18460003808-coder/16_ADC_TEST/hardware/chip reference/ads7953_context.md

# ads7953.pdf

## 主要内容

- **IC型号**: ADS7950～ADS7961；本项目使用 ADS7953
- **类型**: 数据手册（SLAS605C，2018-07 修订）
- **文档覆盖内容**: 特性、引脚、电气参数、时序、工作模式、编程、应用、布局、封装
- **关键外设/特性**: 12/10/8-bit SAR ADC、4/8/12/16 通道、SPI、GPIO、告警、外部参考
- **总页数**: 87

## 目录

### 1 Features (p.1)

### 2 Applications (p.1)

### 3 Description (p.1)

### 4 Revision History (p.2)

### 5 Device Comparison Table (p.5)

### 6 Pin Configuration and Functions (p.5)

### 7 Specifications (p.10)

#### 7.1 Absolute Maximum Ratings (p.10)

#### 7.2 ESD Ratings (p.10)

#### 7.3 Recommended Operating Conditions (p.10)

#### 7.4 Thermal Information: TSSOP (p.11)

#### 7.5 Thermal Information: VQFN (p.11)

#### 7.6 Electrical Characteristics: ADS7950/51/52/53 (p.12)

#### 7.7 Electrical Characteristics: ADS7954/55/56/57 (p.14)

#### 7.8 Electrical Characteristics: ADS7958/59/60/61 (p.15)

#### 7.9 Timing Requirements (p.17)

#### 7.10 Typical Characteristics: All Devices (p.20)

#### 7.11 Typical Characteristics: 12-Bit Devices (p.21)

#### 7.12 Typical Characteristics: 12-Bit Devices (p.27)

### 8 Detailed Description (p.28)

#### 8.1 Overview (p.28)

#### 8.2 Functional Block Diagram (p.29)

#### 8.3 Feature Description (p.29)

#### 8.4 Device Functional Modes (p.29)

#### 8.5 Programming (p.41)

### 9 Application and Implementation (p.46)

#### 9.1 Application Information (p.46)

#### 9.2 Typical Applications (p.48)

### 10 Power Supply Recommendations (p.51)

### 11 Layout (p.52)

#### 11.1 Layout Guidelines (p.52)

#### 11.2 Layout Examples (p.52)

### 12 Device and Documentation Support (p.54)

#### 12.1 Documentation Support (p.54)

#### 12.2 Related Links (p.54)

#### 12.3 Receiving Notification of Documentation Updates (p.54)

#### 12.4 Community Resources (p.54)

#### 12.5 Trademarks (p.54)

#### 12.6 Electrostatic Discharge Caution (p.55)

#### 12.7 Glossary (p.55)

### 13 Mechanical, Packaging, and Orderable Information (p.55)
