18460003808-coder/16_ADC_TEST/ADS7953_0-5V/datasheet_index.md

# Datasheet Index

> 由 datasheet 阅读流程生成的导航文件。

## ./

### 电路原理图.pdf
- **IC/Subject**: ADS7953 16 路 ADC 板
- **Document Type**: 电路原理图
- **Coverage**: ADS7953 电源、参考源、16 路模拟输入、SPI 与连接器
- **Key Features/Peripherals**: CH0～CH15、MXO/AINP、CS#/SCLK/SDI/SDO、GPIO0～3
- **Total Pages**: 1
- **Context File**: 电路原理图_context.md

## chip reference/

### ads7953.pdf
- **IC/Subject**: TI ADS7950～ADS7961，重点 ADS7953
- **Document Type**: 数据手册
- **Coverage**: 引脚、电气指标、SPI 时序、Manual/Auto-1/Auto-2、编程与应用
- **Key Features/Peripherals**: 12-bit、16-channel、1-MSPS、20-MHz SPI、外部参考
- **Total Pages**: 87
- **Context File**: chip reference/ads7953_context.md

## FPGA 选择/

### EP4CE30VER6.1D硬件用户手册.pdf
- **IC/Subject**: Altera Cyclone IV E EP4CE30/EP4CE40 核心板
- **Document Type**: FPGA 核心板硬件用户手册
- **Coverage**: 核心板资源、原理图、板卡布局、外设接口、电源、时钟、扩展接口
- **Key Features/Peripherals**: DDR2、USB 转 RS232、千兆以太网、USB2.0、SD 卡、LCD、QSPI Flash、EEPROM、DS1302
- **Total Pages**: 40
- **Context File**: FPGA 选择/EP4CE30VER6.1D硬件用户手册_context.md
