18460003808-coder/16_ADC_TEST/ADS7953_0-5V/电路原理图_context.md

# 电路原理图.pdf

## 主要内容

- **IC型号**: ADS7953SBDBTR
- **类型**: 单页电路原理图
- **文档覆盖内容**: 电源、参考电压、模拟通道、SPI、GPIO、连接器
- **关键外设/特性**: CH0～CH15、MXO/AINP、CS#/SCLK/SDI/SDO
- **总页数**: 1

## 目录

### Pages
#### SCH_Schematic1 1-P1 (p.1)
### Net
#### AGND, MXO, AINP, SDO, SDI, SCLK, CS#, VCC, +2.5V, +3.3V, +5V (p.1)
#### CH0～CH15, GPIO0～GPIO3 (p.1)
