18460003808-coder/16_ADC_TEST/NEW/ADS7953_NBoard_UART_SLIDE/最开始工程说明.txt

ADS7953_NBoard_UART_SLIDE最终工程说明
=====================================

本工程继承NEW/ADS7953_NBoard_UART的1～20板UART采集功能，并加入滑轨脉冲控制、ADC联动采集、纵向Excel导出和320×N灰度成像。Quartus入口为ADS7953_NBoard_UART_SLIDE.qpf。

一、FPGA

1. 板数由rtl/ads7953_board_count.vh中的ADS7953_BOARD_COUNT宏决定，合法范围1～20，当前为20；修改后必须完整编译并重新下载SOF。
2. ADC SCLK为1 MHz。每块板最多尝试32个SPI字，失败后停止该板SCLK并通过CH0高字节bit7报告读取错误，缺板不会使系统永久忙。
3. slide模块输出2 kHz、50%占空比的脉冲。80个脉冲对应1 mm；一次硬件命令的pulse_num范围为0～65535。
4. dir=1为正向，dir=0为反向。顶层pwm_out连接PIN_A20，dir连接PIN_A19。
5. FPGA只有在ADC与滑轨控制空闲且命令校验正确时才接受滑轨命令；实际脉冲输出结束后才返回完成帧。

二、正式上位机

保留两个程序：

- host/dist/ADS7953_NBoard_AllChannels_UART_SLIDE.exe：全通道显示、采集、滑轨与灰度成像最终版。
- host/dist/ADS7953_NBoard_Scope_UART.exe：保留的多通道示波器式显示版，不含滑轨操作界面；通道采用可滚动复选框选择，并提供“全选”和“清空”。

两个程序共用两份配置：host/dist/board_mapping.csv负责采集卡物理插口1～20与实际逻辑子板1～20，host/dist/channel_mapping.csv负责每块板共用的IV0～IV15与ADC CH0～CH15。断开串口后可点击上位机“映射配置”直接修改，保存后立即生效；显示、标红、波形、Excel和灰度图均使用映射后的逻辑IV0～IV319。配置错误时禁止连接，但可在配置窗口修复，具体格式见docs/板卡映射配置说明.md。

全通道滑轨版功能：

1. 滑轨单独调试可选择方向，距离范围0.5～300 mm。运动期间状态灯为红色，收到匹配的FPGA完成帧后变为绿色。
2. ADC联动每步距离为0.5～2 mm，采集间隔为500～5000 ms，可设置次数N。流程为“采集一次、正向移动一步”，重复N次后反向移动N步总距离复位。
3. 联动数据先保存在内存。复位完成后弹出“另存为”，每次生成新的Excel并由用户命名，不追加旧文件；取消保存后仍可再次保存。
4. Excel的A列为IV0～IV319，后续每列对应不同采集时间；错误板的16路数据标红。
5. 可选择已有或刚生成的纵向Excel生成320×N灰度预览。默认0 V为黑、5 V为白，范围可修改；预览后由用户决定是否导出PNG。

三、文档入口

- README.md：工程范围、构建和验证状态。
- docs/通信协议.md：ADC与滑轨UART帧格式。
- docs/滑轨联动使用说明.md：接线、操作、Excel和灰度图说明。
- docs/板卡映射配置说明.md：板卡序号、板内IV→ADC通道及界面修改方法。
- docs/macOS版本使用与打包说明.md：Apple Silicon M5版构建和使用步骤。
- macOS_M5_Package/：可整体复制到M5 Mac的两款上位机独立构建包。
- docs/FPGA模块调用及信号控制框图.txt：FPGA模块层级及控制时序。
