18460003808-coder/16_ADC_TEST/NEW/验证报告.md

# 验证报告

日期：2026-09-27

## 2026-11-03：SLIDE Scope通道复选框

- 验证Scope可按实际板数动态生成最多320个IV复选框，初始默认勾选IV0；单击复选框后，曲线和Excel均继续使用同一组已选通道。
- 验证“全选”可勾选320路，“清空”可取消全部通道，列表内容高度超过显示区时滚动区域有效；维护目录源码和Mac独立发送包源码均通过相同GUI交互检查。
- Python语法检查和21项单元测试全部通过；重新打包后的Windows Scope正式EXE通过3秒启动检查。
- Scope EXE为13,670,414字节，SHA-256 `CBC26750283D8A7ACE8A427F1D2BE964197E212B30949D5B711FA54D45A6FA29`；AllChannels EXE未重新打包。
- 当前Windows环境不能生成或运行macOS `.app`；本次没有修改或编译FPGA，没有运行Quartus、ModelSim或实物硬件测试。

## 2026-11-03：SLIDE两级映射界面与Mac交付包

- 验证`board_mapping.csv`和`channel_mapping.csv`均可保存、重新加载，并拒绝重复/缺失的一对一配置；Mac首次启动路径测试同时覆盖两份配置。
- 验证自定义IV→ADC通道顺序会改变AllChannels显示行、纵向Excel和Scope Excel读取的ADC原码；板卡序号映射、错误标红、滑轨联动及灰度成像原有测试继续通过。
- Python语法检查和21项单元测试全部通过；AllChannels和Scope均完成“打开映射配置窗口”GUI源码检查，Mac独立交付目录中的同源代码也完成相同检查。
- 两个Windows正式EXE重新打包并分别通过3秒启动检查；`dist`同时包含`board_mapping.csv`和`channel_mapping.csv`。
- AllChannels EXE为16,416,465字节，SHA-256 `C967FEDB41B25E2A95B3141B3D4F08479B4DA4207A5FC9CB119B16FF6A7D3377`；Scope EXE为13,669,247字节，SHA-256 `534C22D87B8FD3D14845A4A851FC6F3F20A03198A608E40B34454E29B1611174`。
- `board_mapping.csv` SHA-256为`6C6C611057B780E32CFAD22EC162E6E1EB5734946324FB0CC774BD0995FF483C`；`channel_mapping.csv` SHA-256为`D14F55DDFE0F007E84DB5B3CACD431BA2D70705102264BDB6A963FAA90AC718E`。
- 当前Windows环境不能实际生成或运行macOS `.app`；M5上的Gatekeeper、USB转串口、实际采集、Excel/PNG和滑轨仍待Mac实机验证。
- 本次没有修改或编译FPGA，没有运行Quartus、ModelSim或实物硬件测试。

## 2026-10-22：SLIDE Apple Silicon M5上位机准备与Windows回归

- macOS路径、首次生成20板恒等映射、映射重新加载以及`Documents`存在/不存在时的默认导出目录均已通过自动测试。
- 两份arm64 PyInstaller规格文件通过Python语法解析；`ads7953_Nboard_gui.py`、AllChannels、Scope和测试文件通过Python语法检查，18项单元测试全部通过。
- `macOS_M5_Package`内9个构建文件与维护目录源文件逐项SHA-256一致，Python源码和两份规格文件可独立解析，Shell脚本保持LF换行，两款GUI均从发送目录独立完成源码启动检查。
- AllChannels和Scope源码GUI启动检查通过；两个Windows正式EXE重新打包后均通过3秒启动检查，`dist/board_mapping.csv`与源码模板一致。
- AllChannels EXE为16,409,776字节，SHA-256 `FD4382C1E6D994BF185EFF2EE1BE847673B844C122FC8C1B40743260C219008D`；Scope EXE为13,663,201字节，SHA-256 `A1ECC42B768D7D64CB14C7FA5C7675CBA0F4B3E1E15C27556326D9D372F8869E`；映射文件SHA-256为`6C6C611057B780E32CFAD22EC162E6E1EB5734946324FB0CC774BD0995FF483C`。
- 当前环境是Windows，未实际生成、签名或启动macOS `.app`，也未验证M5上的Gatekeeper、USB转串口驱动、Excel/PNG、滑轨或实物采集。
- 本次没有修改或编译FPGA，没有运行Quartus、ModelSim或实物硬件测试。

## 2026-10-21：SLIDE板卡映射上位机

- 验证CSV交换`capture_slot 1/2`后，物理Board 1的数据映射为逻辑Board 0，即最终IV0～IV15；SPI错误状态随同16路数据一起映射。
- 验证重复逻辑子板配置被拒绝；实现同时检查缺失文件、表头、整数范围、重复插口和20行完整性。
- AllChannels映射后Excel测试确认IV0取自配置所指物理板，并在该物理板错误时标红；Scope与AllChannels共享同一公共重排入口。
- Python语法检查通过，17项单元测试全部通过，AllChannels和Scope源码GUI启动检查通过。
- 两个正式EXE均已重新打包并通过3秒启动检查，`board_mapping.csv`已复制到同目录。AllChannels为16,409,425字节，SHA-256 `7A0353FC907E54B425EAF7B4C13B553CB666A3290913F6ADD71B469C6FCBFB7B`；Scope为13,663,204字节，SHA-256 `B81C8989B3AF2446A70590E854934D9670CC720468535B221B08E14556F19C3A`。
- 本次没有修改或编译FPGA，没有运行Quartus、ModelSim或实物板卡映射验证。

## 2026-10-08：SLIDE最终整理复核

- 当前正式AllChannels EXE为`host/dist/ADS7953_NBoard_AllChannels_UART_SLIDE.exe`，16,406,775字节，SHA-256 `4F0E1388555E043FA88E32B317E1E6C9C830710B1E456937891239E202550FFD`。
- 当前保留的13项Python单元测试全部通过；本次没有重新运行GUI启动检查、Quartus或ModelSim，也没有进行实物验证。
- 文档全文检索未发现残留UDP/NET、`_FIXED`、`_PREVIEW`、Diagnostic或FreeRun现行说明。
- 项目内现行说明统一为README、`最开始工程说明.txt`、`docs/通信协议.md`、`docs/滑轨联动使用说明.md`和`docs/FPGA模块调用及信号控制框图.txt`。
- 用户Excel和PNG数据未删除；FPGA RTL、约束、SOF和上位机源码未修改。

## 2026-10-08：灰度图预览与选择性PNG导出

- 灰度计算完成后先创建预览窗口，程序不自动写PNG；保存对话框仅由预览窗口“导出PNG”按钮触发。
- 关闭预览或取消导出不会创建PNG，取消导出后预览保持可用。
- 当前`host/dist/1.xlsx`已达到320×320数据，后台解析用时约0.45秒。
- 18项Python测试和GUI源码启动检查通过，预览版EXE打包成功。
- 预览版EXE：`host/dist/ADS7953_NBoard_AllChannels_UART_SLIDE_PREVIEW.exe`，16,406,775字节，SHA-256 `4F0E1388555E043FA88E32B317E1E6C9C830710B1E456937891239E202550FFD`。
- 本次未修改FPGA或SOF。

## 2026-10-08：灰度成像未响应修复

- 复现文件`host/dist/1.xlsx`为321行、101列，即320×100有效数据；普通加载约0.18秒，旧随机访问函数超过30秒未完成。
- 修复后同一文件完整解析为100×320、共32000灰度像素，用时0.139秒。
- Excel改为`iter_rows(values_only=True)`顺序读取，耗时操作放到后台线程；Tk主线程通过队列接收结果并弹出保存和预览。
- 18项Python测试通过，GUI源码启动检查通过，修复版EXE打包成功。
- 修复版EXE：`host/dist/ADS7953_NBoard_AllChannels_UART_SLIDE_FIXED.exe`，16,403,885字节，SHA-256 `F9E2174B4EEA4BF261A02B63627463C80C7CC7DE81652DBDAB55FEDD7C07E904`。
- 原正式EXE当时仍被用户打开，未强制结束或覆盖；本次未修改FPGA或SOF。

## 2026-10-08：SLIDE上位机320×N灰度成像

- 验证纵向Excel解析尺寸为N列×320行，图像行顺序为IV0～IV319、列顺序为采集1～N。
- 默认0～5 V映射验证：0 V为0、2.5 V为128、5 V及以上为255，空白单元格为0；无效电压范围被拒绝。
- SLIDE上位机18项Python测试通过，GUI源码启动检查通过，包含Pillow的正式EXE重新生成成功。
- 新EXE：`host/dist/ADS7953_NBoard_AllChannels_UART_SLIDE.exe`，16,403,677字节，SHA-256 `D96C6FCFF7942F8076CBB9737E91C15EB9AA2C25F2AE30D38A2F103890221A7B`。
- 本次未修改FPGA源码、通信协议或SOF，没有运行Quartus、ModelSim或实物联动验证。

## 2026-10-08：SLIDE联动独立Excel导出

- 验证联动导出直接创建全新工作簿；测试目标原先包含“旧数据”工作表，导出后仅保留新的“纵向通道数据”，证明没有追加旧内容。
- 验证A列IV0～IV319、两轮采集生成两列、列头包含真实采集时间/Seq/位置、错误板对应单元格标红。
- SLIDE上位机16项Python测试通过，GUI源码启动检查通过，正式EXE重新生成成功。
- 新EXE：`host/dist/ADS7953_NBoard_AllChannels_UART_SLIDE.exe`，13,666,218字节，SHA-256 `AC6A4D8143B49928FA941DD6421D31A783D5102575B96EB398AC3E9E2197611C`。
- 本次未修改FPGA源码、通信协议或SOF，没有运行Quartus、ModelSim或实物联动验证。

## 2026-10-08：SLIDE单独调试距离扩展到300 mm

- 验证单独调试接受300 mm并换算为24000个PWM，拒绝300.1 mm。
- 验证联动距离仍限制为0.5～2 mm。
- SLIDE上位机15项Python测试通过，GUI源码启动检查通过，正式EXE重新生成成功。
- 新EXE：`host/dist/ADS7953_NBoard_AllChannels_UART_SLIDE.exe`，13,665,192字节，SHA-256 `9F4CD943C43F26BDA7A2EAD152D8169D93E06010E47F3A137C68A07349A920D1`。
- 本次未修改FPGA源码或SOF，没有运行Quartus、ModelSim或实物滑轨验证。

## 2026-10-08：SLIDE单独调试距离扩展

- 验证单独调试接受0.5 mm和30 mm，拒绝30.1 mm；30 mm正确换算为2400个PWM。
- 验证联动距离仍接受0.5～2 mm并拒绝2.1 mm，未扩大联动运动范围。
- SLIDE上位机全套15项Python测试通过，GUI源码及正式EXE启动检查通过。
- 新EXE：`host/dist/ADS7953_NBoard_AllChannels_UART_SLIDE.exe`，13,665,937字节，SHA-256 `14F77F1FE1CDCE8DEFA075E6A539DBA9B172D15C1DC675CD1290A996E5412162`。
- 本次未修改FPGA源码或SOF，没有运行Quartus或ModelSim，也没有进行实物滑轨验证。

## 2026-10-08：N板UART滑轨联动工程

- `NEW/ADS7953_NBoard_UART_SLIDE`以当前`ADS7953_BOARD_COUNT=20`完成Quartus 13.1全流程编译，Analysis & Synthesis、Fitter、Assembler、TimeQuest均为0 error。
- Fitter保留1条既有3.3-V接口通用警告；TimeQuest同时提示板外I/O未完全约束，不能把编译通过等同于实物滑轨或ADC时序验证。
- 慢角85°C最差setup slack为1.296 ns，最差hold slack为0.450 ns。
- SOF：`output_files/ADS7953_NBoard_UART_SLIDE.sof`，1,171,650字节，SHA-256 `4D759FFE8A1F56EF95D487E175494FA1A96125492F5E12275DC27542D29D4071`。
- Python单元测试15项通过，覆盖原ADC帧、滑轨命令编码、分片完成帧、错误校验拒绝、距离到脉冲换算和既有显示/Excel功能。
- GUI源码启动检查及正式EXE 3秒启动检查通过。EXE：`host/dist/ADS7953_NBoard_AllChannels_UART_SLIDE.exe`，13,665,643字节，SHA-256 `D421816A5333EBF6F6E9E8DE517A16E494EC624DD6DE80B11FF1F4489B0058E7`。
- 已准备`sim/run_slide.do`及更新后的N板仿真脚本，但本次没有运行ModelSim；再次仿真仍需单独取得用户许可。
- 未进行物理滑轨、PWM引脚波形、机械方向、实际位移精度或整套联动实机验证。

## 2026-10-06：AllChannels纵向通道导出

- 验证导出工作表为321行：第1行为表头，第2～321行为IV0～IV319。
- 验证每次采集新增一个数据列，列标题包含时间和Seq；2板配置时IV32～IV319保持空白。
- 验证错误板对应16个数据单元格使用红色字体和浅红背景。
- N板UART上位机全套11项Python测试通过，包含旧工作表保留及自动切换验证；AllChannels源码界面和正式EXE启动检查通过。
- 正式EXE SHA-256：`972BF60956CB223DBC20ABFB6C2C3691CE5AB6E4FA9A8C0C975ECBEE100688E8`。
- 本次未修改FPGA，也未运行ModelSim。

## 2026-10-06：N板UART读取诊断版

- `NEW/ADS7953_NBoard_UART`在当前`ADS7953_BOARD_COUNT=20`配置下完成Quartus 13.1全流程编译：Analysis & Synthesis、Fitter、Assembler、TimeQuest均为0 error；Fitter保留1条既有3.3-V接口通用警告。
- 慢角85°C最差setup slack为1.523 ns，最差hold slack为0.450 ns；板外SPI仍未建立完整输入/输出延时约束，因此该结果不等同于物理SPI波形验证。
- 新SOF：`output_files/ADS7953_NBoard_UART.sof`，SHA-256 `9F44CF897909C2159A0B7C0D8F861660FE5AE08B859D32868B93E19212105ABD`。
- N板UART上位机共9项Python测试通过，覆盖正常/错误标志解析、12位ADC值不受bit7影响、旧解析器兼容、Excel错误状态与红色格式，以及原有连续触发和视图测试。
- `ADS7953_NBoard_Diagnostic_UART.exe`已生成并通过3秒启动冒烟测试；SHA-256 `FF2F611B3C32D0408B7E2FE6510106480A085E8661100FE5E61AB3028BB75CB7`。
- 本次没有运行ModelSim。诊断标志的RTL动态行为尚未做新一轮仿真，运行前仍须取得用户单独许可。

## 2026-10-06：N板UART五款上位机同步更新

- 主界面、AllChannels、Scope、FreeRun和Diagnostic均解析Byte8 bit7；原12位ADC值继续使用高字节`& 0x0F`，协议长度不变。
- 当前全套11项Python测试通过，覆盖错误标志、旧40字节解析兼容、主数据值、AllChannels纵向导出与旧表保留、Scope/Diagnostic导出状态及红色格式、连续触发和通道映射。
- 五个源码界面均完成Tk启动检查；五个正式`host/dist/*.exe`均完成2秒启动冒烟测试。
- 正式EXE SHA-256：主界面`19496285C80BBA9FF1F1D7B8C6501D3428C1CC175C92E0506FF03E93773857D3`；AllChannels`080855D481F224D4D4D6498848C76B3CDD067BB7472AFC910FDEE3681D0B42CC`；Scope`17EF65158929396B91AED09598A347F99C3BC4B7C78CB134B0D65743044C8574`；FreeRun`030866EB5DFF978E5E14E108256CE96544E1A8F08AE62002B1C98FBE5A55C18F`；Diagnostic`16F5E3405C14831EEEA7D6E2499DBF4AB8587819BE9BC94D4074F61A24B21DBF`。
- 本次仅更新上位机源码和EXE，没有再次修改或编译FPGA，也没有运行ModelSim。

## Quartus 13.1

四个工程均以Cyclone IV E `EP4CE30F23C8`完成Analysis & Synthesis、Fitter、Assembler和TimeQuest，结果均为0 error。

| 工程 | 验证板数 | 结果 | 慢角最差setup slack |
|---|---:|---|---:|
| ADS7953_1Board_UART | 1 | 通过 | 6.251 ns |
| ADS7953_1Board_NET | 1 | 通过 | 0.599 ns |
| ADS7953_NBoard_UART | 1 | 通过 | 6.483 ns |
| ADS7953_NBoard_UART | 20 | 通过 | 1.502 ns |
| ADS7953_NBoard_NET | 1 | 通过 | 0.560 ns |
| ADS7953_NBoard_NET | 20 | 通过 | 0.317 ns |

20板验证后，两个N板工程均已恢复`ADS7953_BOARD_COUNT=1`，并重新生成默认1板`.sof`。

NET工程仍有Quartus警告：PHY管理接口`MDC`固定低、`MDIO`保持高阻；GMII GTX时钟到输出脚使用非专用布线；板外I/O未建立完整输入/输出延时约束。当前工程依赖RTL8211上电固定配置，功能编译通过，但量产前建议根据PCB走线补齐板级时序约束并实测GMII裕量。

## 上位机

- 1板UART：新增FreeRun测试后共5项单元测试通过。
- N板UART：新增FreeRun测试后共5项单元测试通过。
- 1板NET：新增FreeRun测试后共7项单元测试通过。
- N板NET：新增FreeRun测试后共7项单元测试通过。
- 四个工程共16个EXE均能启动并保持运行，冒烟测试通过；优化后大小约12.9～13.0 MB。

测试覆盖分片串口帧、UDP完整负载、动态板数、全局IV编号、全通道Excel、示波器选中通道导出、NET示波器刻度校验和IP搜索候选地址。

四个工程的FreeRun专项测试均在完全不提供任何返回帧/UDP数据报的条件下，确认发送循环连续发送3次`T`，证明触发发送不依赖FPGA反馈。

## ModelSim

需求规定每次ModelSim仿真前必须先征得用户许可，当前结果如下：

| 工程/脚本 | 结果 | 仿真时间 | 覆盖内容 |
|---|---|---:|---|
| ADS7953_1Board_UART `sim/run.do` | PASS | 34851 ns | 单板Auto-2扫描、16通道数据及10 MHz SCLK高40 ns/低60 ns |
| ADS7953_1Board_NET `sim/run.do` | PASS | 34851 ns | 单板Auto-2扫描、16通道数据及10 MHz SCLK高40 ns/低60 ns |
| ADS7953_NBoard_UART `sim/run.do` | PASS | 267510 ns | N=1，两轮采集、CS隔离、16通道数据帧和结束帧 |
| ADS7953_NBoard_UART `sim/run_20.do` | PASS | 4616990 ns | N=20，两轮采集、20路CS隔离、全部数据帧和结束帧 |
| ADS7953_NBoard_NET `sim/run_udp.do` | PASS | 4552 ns | N=2，UDP触发、应用负载、IP/UDP封装和Ethernet FCS |
| ADS7953_NBoard_NET `sim/run_udp_20.do` | PASS | 24712 ns | N=20，808字节最大应用负载及Ethernet FCS |

本轮计划内ModelSim仿真已全部通过。

## 无板防死锁修改

- 四个`ads7953_16ch_reader.v`增加`MAX_FRAME_COUNT=32`上限。
- 超过32个16位SPI帧仍未收到完整CH0～CH15时，SCLK停止、CS释放、本轮数据清零并产生完成信号。
- 多板控制器收到完成信号后继续下一块板，因此缺失一块板不会锁死整轮。
- 四个工程已重新通过Quartus 13.1完整编译，均为0 error。
- 单板测试平台已加入SDO固定0的无板场景；新的ModelSim回归尚待用户许可。
