18460003808-coder/16_ADC_TEST/NEW/引脚约束基准.md

# ADS7953统一引脚约束基准

用户于2026-10-06通过Quartus图形界面修改了`ADS7953_NBoard_UART`工程的引脚约束，并明确指定以后所有ADS7953工程均以该工程当前的有效约束为基准。

## 基准如何形成

主工程文件：

`NEW/ADS7953_NBoard_UART/ADS7953_NBoard_UART.qsf`

主QSF先执行：

`source constraints/pins.qsf`

随后，Quartus GUI在主QSF末尾写入CS1～CS19的新分配。由于这些语句位于`source`之后，它们构成对应信号的当前工程覆盖值。因此，不能只复制`constraints/pins.qsf`，也不能只查看主QSF中的新增行；必须解析两者得到最终有效约束。

指定时文件校验值：

- `ADS7953_NBoard_UART.qsf` SHA-256：`EFF4CE49A5B436B7EDCF1A1442365AFF5CEF9C731343FB9B057F92BFFBD7769D`
- `constraints/pins.qsf` SHA-256：`B0755C9B953BAFEF51BBDB9275FCCFD640E3C94B20CC44490D037F269AD42C1A`

## 当前解析后的有效引脚

| 信号 | 有效FPGA引脚 | 来源 |
|---|---|---|
| clk | PIN_G1 | pins.qsf |
| rst_n | PIN_E4 | pins.qsf |
| uart_rxd | PIN_P16 | pins.qsf |
| uart_txd | PIN_P20 | pins.qsf |
| adc_sdo | PIN_G17 | pins.qsf |
| adc_sdi | PIN_H19 | pins.qsf |
| adc_sclk | PIN_J17 | pins.qsf |
| adc_cs_n[0] | PIN_B21 | pins.qsf |
| adc_cs_n[1] | PIN_F17 | 主QSF GUI覆盖 |
| adc_cs_n[2] | PIN_H20 | 主QSF GUI覆盖 |
| adc_cs_n[3] | PIN_K21 | 主QSF GUI覆盖 |
| adc_cs_n[4] | PIN_C20 | 主QSF GUI覆盖 |
| adc_cs_n[5] | PIN_F20 | 主QSF GUI覆盖 |
| adc_cs_n[6] | PIN_H22 | 主QSF GUI覆盖 |
| adc_cs_n[7] | PIN_L21 | 主QSF GUI覆盖 |
| adc_cs_n[8] | PIN_C22 | 主QSF GUI覆盖 |
| adc_cs_n[9] | PIN_F22 | 主QSF GUI覆盖 |
| adc_cs_n[10] | PIN_J18 | 主QSF GUI覆盖 |
| adc_cs_n[11] | PIN_M19 | 主QSF GUI覆盖 |
| adc_cs_n[12] | PIN_D21 | 主QSF GUI覆盖 |
| adc_cs_n[13] | PIN_G18 | 主QSF GUI覆盖 |
| adc_cs_n[14] | PIN_J22 | 主QSF GUI覆盖 |
| adc_cs_n[15] | PIN_M21 | 主QSF GUI覆盖 |
| adc_cs_n[16] | PIN_E21 | 主QSF GUI覆盖 |
| adc_cs_n[17] | PIN_H18 | 主QSF GUI覆盖 |
| adc_cs_n[18] | PIN_K18 | 主QSF GUI覆盖 |
| adc_cs_n[19] | PIN_M22 | 主QSF GUI覆盖 |

I/O标准为3.3-V LVTTL。`uart_txd`、`adc_cs_n[*]`、`adc_sdi`和`adc_sclk`的输出驱动为8 mA。

## 后续使用规则

- 新建、修复或同步工程时，以此有效映射为准，不从旧工程或`.bak`文件恢复。
- 单板工程使用`adc_cs_n[0] = PIN_B21`。
- N板工程使用从`adc_cs_n[0]`开始的前N路有效CS映射。
- NET工程保留自己的Ethernet/GMII专用引脚，只同步公共的时钟、复位、SPI和CS。
- 本次仅记录权威基准，没有覆盖其他现有工程，也没有重新编译。
- 若用户以后再次通过Quartus修改该基准工程，应重新解析有效约束并更新本文档与校验值。
