18460003808-coder/16_ADC_TEST/NEW/通信帧格式.md

# ADS7953上位机通信帧格式

## 1. 分层原则

串口和网口只改变传输外壳，应用层数据完全相同：

```text
上位机触发T → FPGA顺序采集板0…板N-1 → N个数据帧 → 1个结束帧
```

ADS7953每个SPI帧为16位，输出内容是4位通道号加12位转换结果；数据在SCLK下降沿更新，FPGA在上升沿采样。[来源: hardware/chip reference/ads7953.pdf, 8.1 Overview, p.28；Figure 2, p.18]

## 2. 触发命令

| 传输 | 上位机发送 |
|---|---|
| UART | ASCII `T`，即单字节 `54` |
| UDP | UDP负载为单字节 `54`，发送至广播地址 `192.168.1.255:5000` |

FPGA忙、ADC未就绪或正在发送上一包时，新触发会被忽略，避免覆盖数据。

## 3. 数据帧：40字节

| 偏移 | 长度 | 字段 | 示例/说明 |
|---:|---:|---|---|
| 0 | 2 | 帧头 | `A5 5A` |
| 2 | 1 | 协议版本 | `01` |
| 3 | 1 | 板号 | `00～13`，即板0～板19 |
| 4 | 1 | ADC负载长度 | 固定`20`，十六进制32字节 |
| 5 | 2 | 采集序号 | 低字节在前 |
| 7 | 32 | ADC数据 | CH0～CH15，每路2字节、低字节在前、低12位有效 |
| 39 | 1 | XOR | 偏移2～38逐字节异或 |

`NEW/ADS7953_NBoard_UART`在偏移8（CH0高字节）的bit7提供板级SPI读取错误标志：`0=正常`，`1=32字超时`。该位不属于ADC原码，错误时本板16路均无效。其他工程保留该位为0。所有解析器仍必须用`& 0x0F`提取ADC高4位，因此帧长和旧上位机兼容。

第`k`通道原始码解析：

```text
code[k] = byte[7+2k] | ((byte[8+2k] & 0x0F) << 8)
voltage = code[k] × 5.0 / 4096.0
```

## 4. 结束帧：8字节

| 偏移 | 长度 | 字段 | 示例/说明 |
|---:|---:|---|---|
| 0 | 2 | 帧头 | `A5 5A` |
| 2 | 1 | 协议版本 | `01` |
| 3 | 1 | 结束标志 | `FF` |
| 4 | 1 | 实际板数 | `01～14`，即1～20 |
| 5 | 2 | 采集序号 | 与本轮数据帧相同，低字节在前 |
| 7 | 1 | XOR | 偏移2～6逐字节异或 |

单板、序号0的结束帧为：

```text
A5 5A 01 FF 01 00 00 FF
```

结束帧用于明确一轮采集结束。若它声明N块板，而上位机未收到板0～板N-1中的任一数据帧，则本轮判定为不完整。

## 5. UART承载

- 参数：115200 baud、8数据位、无校验、1停止位。
- 字节流：`数据帧0 + … + 数据帧N-1 + 结束帧`。
- 上位机解析器可以从任意字节位置重新搜索`A5 5A`，并用长度、版本和XOR三重校验恢复同步。

## 6. UDP承载

- FPGA：`192.168.1.50:5000`。
- 上位机：默认`192.168.1.10:5001`。
- 触发使用广播，FPGA记住触发方MAC/IP/端口并直接回复，无需FPGA实现ARP。
- 一轮采集封装在一个UDP负载中，长度为`N×40+8`；20板最大808字节，小于标准以太网MTU。

## 7. 多板采集顺序

```text
CS0拉低 → 板0读取16通道 → CS0拉高
等待板间隔
CS1拉低 → 板1读取16通道 → CS1拉高
…
CS(N-1)完成 → 封装并发送本轮数据
```

Auto-2模式可以设定最后扫描通道，并从通道0按升序扫描至该通道；本工程设置最后通道为15。[来源: hardware/chip reference/ads7953.pdf, 8.4.1 Channel Sequencing Modes, p.29-30]

## 8. N板UART滑轨工程扩展

仅`NEW/ADS7953_NBoard_UART_SLIDE`增加以下UART帧：

- 上位机移动命令：`55 AA 4D Dir PulseLo PulseHi XOR`，XOR覆盖Byte2～Byte5。
- FPGA运动完成帧：`A5 5A 01 FE 01 Dir PulseLo PulseHi XOR`，XOR覆盖Byte2～Byte7。
- `Dir=01`为正向，`Dir=00`为反向；脉冲数为16位小端。

原有`54`采集触发、40字节ADC数据帧和8字节结束帧没有改变。
