18460003808-coder/16_ADC_TEST/ADS7953_0-5V/FPGA 选择/EP4CE30VER6.1D硬件用户手册_context.md

# EP4CE30VER6.1D硬件用户手册.pdf

## 主要内容

- **IC型号**: Altera Cyclone IV E EP4CE30/EP4CE40
- **类型**: FPGA 核心板硬件用户手册
- **文档覆盖内容**: 核心板资源、原理图、板卡布局、外设接口、电源、时钟、扩展接口
- **关键外设/特性**: DDR2、USB 转 RS232、千兆以太网、USB2.0、SD 卡、LCD、QSPI Flash、EEPROM、DS1302
- **总页数**: 40

## 目录

### 目 录 (p.2)
### 第一章 硬件说明 (p.3)
#### 1.【产品定位】 (p.4)
#### 2.【产品特色】 (p.4)
#### 3.FPGA核心板资源 (p.6)
#### 4.实验准备 (p.7)
#### 5.原理图 (p.7)
#### 6.开发板布局图 (p.9)
#### 7.系统结构图 (p.9)
#### 一. 简介 (p.11)
#### 二. 可选配套扩展模块列表 (p.12)
#### 三. 电路分析和说明 (p.14)
#### 与摄像头+TFT3.2寸触摸屏+AD模块组合 (p.33)
#### 与3块双通道AD模块组合成6路AD数据采集系统 (p.33)
#### 与7寸LCD连接 (p.33)
#### 混合搭配 (p.34)
#### 与EDA7.0主板组合成EDA+SOPC开发系统 (p.35)
#### 与EDA6.1主板组合成EDA+SOPC综合教学开发系统 (p.35)
#### 双MT9M001摄像头实验 (p.35)
#### 双MT9M034高清摄像头实验 (p.37)
#### AD/DA虚拟仪器实验 (p.38)
