18460003808-coder/16_ADC_TEST/ADS7953_20Board_SharedSPI/fpga_Nboard_NET/datasheet_index.md

# Datasheet Index

> 由datasheet阅读流程生成的导航文件。

## ./

### EP4CE30VER6.1D硬件用户手册.pdf
- **IC/Subject**: Altera Cyclone IV E EP4CE30/EP4CE40核心板
- **Document Type**: FPGA核心板硬件用户手册
- **Coverage**: 核心板资源、原理图、千兆以太网、时钟、电源和扩展接口
- **Key Features/Peripherals**: RTL8211EG、GMII、DDR2、USB2.0、SD卡
- **Total Pages**: 40
- **Context File**: EP4CE30VER6.1D硬件用户手册_context.md
