18460003808-coder/16_ADC_TEST/ADS7953_20Board_SharedSPI/fpga_Nboard_NET/EP4CE30VER6.1D硬件用户手册_context.md

# EP4CE30VER6.1D硬件用户手册.pdf

## 主要内容

- **IC型号**: Altera Cyclone IV E EP4CE30/EP4CE40
- **类型**: FPGA核心板硬件用户手册
- **文档覆盖内容**: 核心板资源、原理图、板卡布局、外设接口、电源、时钟、扩展接口
- **关键外设/特性**: DDR2、USB转RS232、千兆以太网、USB2.0、SD卡、LCD、QSPI Flash、EEPROM、DS1302
- **总页数**: 40

## 目录

### 目录 (p.2)
### 第一章 硬件说明 (p.3)
#### 产品定位 (p.4)
#### 产品特色 (p.4)
#### FPGA核心板资源 (p.6)
#### 实验准备 (p.7)
#### 原理图 (p.7)
#### 开发板布局图 (p.9)
#### 系统结构图 (p.9)
#### 电路分析和说明 (p.14)
#### 千兆网络 (p.22)
#### 时钟源 (p.24)
#### 电源 (p.25)
#### 扩展接口J6、J7、J11 (p.28)
