18460003808-coder/16_ADC_TEST/ADS7953_20Board_SharedSPI/fpga_Nboard/docs/串口协议.md

# ADS7953 N板串口协议

串口参数：`115200 baud, 8-N-1`。上位机发送ASCII `T`（`0x54`）触发一次采集。

FPGA按照编译宏 `ADS7953_BOARD_COUNT=N` 依次扫描板0～板N-1，发送N个40字节数据帧，最后发送一个8字节结束帧。同一轮数据帧和结束帧使用相同采集序号。

## 数据帧（40字节）

| 偏移 | 长度 | 内容 |
|---:|---:|---|
| 0 | 2 | 帧头 `A5 5A` |
| 2 | 1 | 协议版本 `01` |
| 3 | 1 | 板号 `00..13`（十六进制，即0～19） |
| 4 | 1 | ADC负载长度 `20`（十六进制，即32字节） |
| 5 | 2 | 采集序号，小端序 |
| 7 | 32 | CH0～CH15，每通道2字节、小端序、低12位有效 |
| 39 | 1 | 偏移2～38的XOR校验 |

## 结束帧（8字节）

| 偏移 | 长度 | 内容 |
|---:|---:|---|
| 0 | 2 | 帧头 `A5 5A` |
| 2 | 1 | 协议版本 `01` |
| 3 | 1 | 结束标志 `FF` |
| 4 | 1 | 本工程实际板卡数量 `01..14`（十六进制，即1～20） |
| 5 | 2 | 采集序号，小端序 |
| 7 | 1 | 偏移2～6的XOR校验 |

结束帧使上位机无需预先配置板数，也不需要依赖串口空闲超时判断一轮数据何时完成。若结束帧报告N块，但缺少板0～板N-1中的任何数据帧，上位机将显示缺失板号，不提交该轮数据。
