18460003808-coder/16_ADC_TEST/NEW/ADS7953_NBoard_UART_SLIDE/host/dist/1_grayscale.png

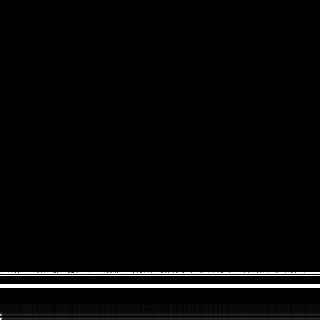
NEW/ADS7953_NBoard_UART_SLIDE/host/dist/1_grayscale.png
