18460003808-coder/16_ADC_TEST/(list of files, cad)

Other CAD files:
ADS7953_0-5V/signaltap/ads7953_debug.stp
ADS7953_20Board_SharedSPI/fpga_2board/stp2.stp
ADS7953_20Board_SharedSPI/fpga_Nboard_NET/stp1.stp
NPWM_DAC/stp1.stp
ADS7953_20Board_SharedSPI/fpga_2board/sim/work/ads7953_2board_top/verilog.psm
ADS7953_20Board_SharedSPI/fpga_2board/sim/work/ads7953_model/verilog.psm
ADS7953_20Board_SharedSPI/fpga_2board/sim/work/tb_ads7953_2board/verilog.psm
NPWM_DAC/NPWM_DAC_ADJ/sim/work/npwm_dac_adjustable/verilog.psm
NPWM_DAC/NPWM_DAC_ADJ/sim/work/tb_npwm_dac_adjustable/verilog.psm
