18460003808-coder/16_ADC_TEST/NEW/ADS7953_NBoard_UART/host/build/ADS7953_NBoard_Diagnostic_UART/xref-ADS7953_NBoard_Diagnostic_UART.html

# modulegraph cross reference for ads7953_diagnostic_gui.py, pyi_rth__tkinter.py, pyi_rth_inspect.py, pyi_rth_pkgutil.py

ads7953_diagnostic_gui.py Script

imports: __future__ • _collections_abc • _weakrefset • abc • ads7953_Nboard_gui • codecs • collections • copyreg • datetime • encodings • encodings.aliases • encodings.ascii • encodings.base64_codec • encodings.big5 • encodings.big5hkscs • encodings.bz2_codec • encodings.charmap • encodings.cp037 • encodings.cp1006 • encodings.cp1026 • encodings.cp1125 • encodings.cp1140 • encodings.cp1250 • encodings.cp1251 • encodings.cp1252 • encodings.cp1253 • encodings.cp1254 • encodings.cp1255 • encodings.cp1256 • encodings.cp1257 • encodings.cp1258 • encodings.cp273 • encodings.cp424 • encodings.cp437 • encodings.cp500 • encodings.cp720 • encodings.cp737 • encodings.cp775 • encodings.cp850 • encodings.cp852 • encodings.cp855 • encodings.cp856 • encodings.cp857 • encodings.cp858 • encodings.cp860 • encodings.cp861 • encodings.cp862 • encodings.cp863 • encodings.cp864 • encodings.cp865 • encodings.cp866 • encodings.cp869 • encodings.cp874 • encodings.cp875 • encodings.cp932 • encodings.cp949 • encodings.cp950 • encodings.euc_jis_2004 • encodings.euc_jisx0213 • encodings.euc_jp • encodings.euc_kr • encodings.gb18030 • encodings.gb2312 • encodings.gbk • encodings.hex_codec • encodings.hp_roman8 • encodings.hz • encodings.idna • encodings.iso2022_jp • encodings.iso2022_jp_1 • encodings.iso2022_jp_2 • encodings.iso2022_jp_2004 • encodings.iso2022_jp_3 • encodings.iso2022_jp_ext • encodings.iso2022_kr • encodings.iso8859_1 • encodings.iso8859_10 • encodings.iso8859_11 • encodings.iso8859_13 • encodings.iso8859_14 • encodings.iso8859_15 • encodings.iso8859_16 • encodings.iso8859_2 • encodings.iso8859_3 • encodings.iso8859_4 • encodings.iso8859_5 • encodings.iso8859_6 • encodings.iso8859_7 • encodings.iso8859_8 • encodings.iso8859_9 • encodings.johab • encodings.koi8_r • encodings.koi8_t • encodings.koi8_u • encodings.kz1048 • encodings.latin_1 • encodings.mac_arabic • encodings.mac_croatian • encodings.mac_cyrillic • encodings.mac_farsi • encodings.mac_greek • encodings.mac_iceland • encodings.mac_latin2 • encodings.mac_roman • encodings.mac_romanian • encodings.mac_turkish • encodings.mbcs • encodings.oem • encodings.palmos • encodings.ptcp154 • encodings.punycode • encodings.quopri_codec • encodings.raw_unicode_escape • encodings.rot_13 • encodings.shift_jis • encodings.shift_jis_2004 • encodings.shift_jisx0213 • encodings.tis_620 • encodings.undefined • encodings.unicode_escape • encodings.utf_16 • encodings.utf_16_be • encodings.utf_16_le • encodings.utf_32 • encodings.utf_32_be • encodings.utf_32_le • encodings.utf_7 • encodings.utf_8 • encodings.utf_8_sig • encodings.uu_codec • encodings.zlib_codec • enum • functools • genericpath • heapq • io • keyword • linecache • locale • ntpath • openpyxl • openpyxl.styles • operator • os • pathlib • posixpath • pyi_rth__tkinter.py • pyi_rth_inspect.py • pyi_rth_pkgutil.py • queue • re • re._casefix • re._compiler • re._constants • re._parser • reprlib • serial • sre_compile • sre_constants • sre_parse • stat • tkinter • traceback • types • warnings • weakref

pyi_rth__tkinter.py Script

imports: os • sys

imported by: ads7953_diagnostic_gui.py

pyi_rth_inspect.py Script

imports: inspect • os • sys • zipfile

imported by: ads7953_diagnostic_gui.py

pyi_rth_pkgutil.py Script

imports: pkgutil • pyimod02_importers

imported by: ads7953_diagnostic_gui.py

'System.IO' MissingModule

imported by: serial.serialcli

'collections.abc' MissingModule

imported by: http.client • importlib.resources.readers • inspect • logging • selectors • traceback • tracemalloc • typing • xml.etree.ElementTree

'java.lang' MissingModule

imported by: platform

'lxml.etree' MissingModule

imported by: openpyxl.xml • openpyxl.xml.functions

PIL ExcludedModule

imported by: openpyxl.drawing.image

System MissingModule

imported by: serial.serialcli

__future__ SourceModule

imported by: _colorize • _pyrepl.pager • ads7953_Nboard_gui • ads7953_diagnostic_gui.py • defusedxml • defusedxml.ElementTree • defusedxml.cElementTree • defusedxml.expatbuilder • defusedxml.expatreader • defusedxml.minidom • defusedxml.pulldom • defusedxml.sax • defusedxml.xmlrpc • et_xmlfile.xmlfile • importlib.metadata • importlib.metadata._meta • importlib.resources.readers • pydoc • serial • serial.serialcli • serial.serialjava • serial.serialposix • serial.serialutil • serial.serialwin32 • serial.tools.list_ports • serial.tools.list_ports_common • serial.tools.list_ports_linux • serial.tools.list_ports_osx • serial.tools.list_ports_posix • serial.tools.list_ports_windows • serial.win32

_abc (builtin module)

imported by: abc

_aix_support SourceModule

imports: contextlib • os • subprocess • sys • sysconfig

imported by: sysconfig

_ast (builtin module)

imported by: ast

_bisect (builtin module)

imported by: bisect

_blake2 (builtin module)

imported by: hashlib

_bz2 D:\anaconda3\DLLs\_bz2.pyd

imported by: bz2

_codecs (builtin module)

imported by: codecs

_codecs_cn (builtin module)

imported by: encodings.gb18030 • encodings.gb2312 • encodings.gbk • encodings.hz

_codecs_hk (builtin module)

imported by: encodings.big5hkscs

_codecs_iso2022 (builtin module)

imported by: encodings.iso2022_jp • encodings.iso2022_jp_1 • encodings.iso2022_jp_2 • encodings.iso2022_jp_2004 • encodings.iso2022_jp_3 • encodings.iso2022_jp_ext • encodings.iso2022_kr

_codecs_jp (builtin module)

imported by: encodings.cp932 • encodings.euc_jis_2004 • encodings.euc_jisx0213 • encodings.euc_jp • encodings.shift_jis • encodings.shift_jis_2004 • encodings.shift_jisx0213

_codecs_kr (builtin module)

imported by: encodings.cp949 • encodings.euc_kr • encodings.johab

_codecs_tw (builtin module)

imported by: encodings.big5 • encodings.cp950

_collections (builtin module)

imported by: collections • threading

_collections_abc SourceModule

imports: abc • sys • warnings

imported by: ads7953_diagnostic_gui.py • collections • contextlib • locale • os • pathlib._local • random • types • weakref

_colorize SourceModule

imports: __future__ • io • nt • os • sys • typing

imported by: traceback

_compat_pickle SourceModule

imported by: _pickle • pickle

_compression SourceModule

imports: io • sys

imported by: bz2 • gzip • lzma

_contextvars (builtin module)

imported by: contextvars

_csv (builtin module)

imported by: csv

_ctypes D:\anaconda3\DLLs\_ctypes.pyd

imported by: ctypes

_datetime (builtin module)

imports: _strptime • time

imported by: datetime

_decimal D:\anaconda3\DLLs\_decimal.pyd

imported by: decimal

_elementtree D:\anaconda3\DLLs\_elementtree.pyd

imports: pyexpat • xml.etree.ElementInclude • xml.etree.ElementPath • xml.etree.ElementTree • xml.etree.cElementTree

imported by: xml.etree.ElementTree

_frozen_importlib ExcludedModule

imported by: importlib • importlib.abc • zipimport

_frozen_importlib_external MissingModule

imported by: importlib • importlib._bootstrap • importlib.abc • zipimport

_functools (builtin module)

imported by: functools

_hashlib D:\anaconda3\DLLs\_hashlib.pyd

imported by: hashlib

_heapq (builtin module)

imported by: heapq

_imp (builtin module)

imported by: importlib • importlib._bootstrap_external • importlib.util • zipimport

_io (builtin module)

imported by: importlib._bootstrap_external • io • zipimport

_json (builtin module)

imports: json.decoder

imported by: json.decoder • json.encoder • json.scanner

_locale (builtin module)

imported by: locale

_lzma D:\anaconda3\DLLs\_lzma.pyd

imported by: lzma

_md5 (builtin module)

imported by: hashlib

_multibytecodec (builtin module)

imported by: encodings.big5 • encodings.big5hkscs • encodings.cp932 • encodings.cp949 • encodings.cp950 • encodings.euc_jis_2004 • encodings.euc_jisx0213 • encodings.euc_jp • encodings.euc_kr • encodings.gb18030 • encodings.gb2312 • encodings.gbk • encodings.hz • encodings.iso2022_jp • encodings.iso2022_jp_1 • encodings.iso2022_jp_2 • encodings.iso2022_jp_2004 • encodings.iso2022_jp_3 • encodings.iso2022_jp_ext • encodings.iso2022_kr • encodings.johab • encodings.shift_jis • encodings.shift_jis_2004 • encodings.shift_jisx0213

_opcode (builtin module)

imported by: dis • opcode

_opcode_metadata SourceModule

imported by: opcode

_operator (builtin module)

imported by: operator

_pickle (builtin module)

imports: _compat_pickle • codecs • copyreg

imported by: pickle

_posixsubprocess MissingModule

imports: gc

imported by: subprocess

_py_abc SourceModule

imports: _weakrefset

imported by: abc

_pydatetime SourceModule

imports: _strptime • math • operator • sys • time • warnings

imported by: datetime

_pydecimal SourceModule

imports: collections • contextvars • itertools • locale • math • numbers • re • sys

imported by: decimal

_pyrepl Package

imported by: _pyrepl.pager

_pyrepl.pager SourceModule

imports: __future__ • _pyrepl • io • os • re • subprocess • sys • tempfile • termios • tty • typing

imported by: pydoc

_queue D:\anaconda3\DLLs\_queue.pyd

imported by: queue

_random (builtin module)

imported by: random

_scproxy MissingModule

imported by: urllib.request

_sha1 (builtin module)

imported by: hashlib

_sha2 (builtin module)

imported by: hashlib • random

_sha3 (builtin module)

imported by: hashlib

_signal (builtin module)

imported by: signal

_socket D:\anaconda3\DLLs\_socket.pyd

imported by: socket • types

_sre (builtin module)

imports: copy • re

imported by: re • re._compiler • re._constants

_ssl D:\anaconda3\DLLs\_ssl.pyd

imports: socket

imported by: ssl

_stat (builtin module)

imported by: stat

_statistics (builtin module)

imported by: statistics

_string (builtin module)

imported by: string

_strptime SourceModule

imports: _thread • calendar • datetime • locale • os • re • time • warnings

imported by: _datetime • _pydatetime • time

_struct (builtin module)

imported by: struct

_suggestions (builtin module)

imported by: traceback

_sysconfig (builtin module)

imported by: sysconfig

_thread (builtin module)

imported by: _strptime • functools • reprlib • tempfile • threading

_threading_local SourceModule

imports: contextlib • threading • weakref

imported by: threading

_tkinter D:\anaconda3\DLLs\_tkinter.pyd

imported by: tkinter

_tokenize (builtin module)

imported by: tokenize

_tracemalloc (builtin module)

imported by: tracemalloc

_typing (builtin module)

imported by: typing

_warnings (builtin module)

imported by: importlib._bootstrap_external • warnings • zipimport

_weakref (builtin module)

imported by: _weakrefset • collections • weakref • xml.sax.expatreader

_weakrefset SourceModule

imports: _weakref • types

imported by: _py_abc • ads7953_diagnostic_gui.py • threading • weakref

_winapi (builtin module)

imported by: encodings • mimetypes • ntpath • shutil • subprocess • sysconfig

_wmi D:\anaconda3\DLLs\_wmi.pyd

imported by: platform

abc SourceModule

imports: _abc • _py_abc

imported by: _collections_abc • ads7953_diagnostic_gui.py • contextlib • dataclasses • email._policybase • functools • importlib._abc • importlib.abc • importlib.metadata • importlib.resources.abc • inspect • io • numbers • os • selectors • typing

ads7953_Nboard_gui SourceModule

imports: __future__ • datetime • openpyxl • pathlib • queue • serial • serial.tools • serial.tools.list_ports • threading • time • tkinter • tkinter.filedialog • tkinter.messagebox • tkinter.ttk

imported by: ads7953_diagnostic_gui.py

argparse SourceModule

imports: copy • gettext • os • re • shutil • sys • textwrap • warnings

imported by: ast • calendar • dis • gzip • http.server • inspect • py_compile • random • serial.tools.list_ports • tarfile • tokenize • webbrowser • zipfile

array (builtin module)

imported by: openpyxl.styles.cell_style • serial.serialposix • serial.serialutil • socket

ast SourceModule

imports: _ast • argparse • collections • contextlib • enum • inspect • re • sys • warnings

imported by: inspect • pydoc • traceback

atexit (builtin module)

imported by: logging • openpyxl.worksheet._writer • weakref

base64 SourceModule

imports: binascii • getopt • re • struct • sys

imported by: email._encoded_words • email.base64mime • email.encoders • encodings.base64_codec • http.server • ssl • urllib.request • xmlrpc.client

binascii (builtin module)

imported by: base64 • email._encoded_words • email.base64mime • email.contentmanager • email.header • email.message • encodings.hex_codec • encodings.uu_codec • http.server • quopri • zipfile

bisect SourceModule

imports: _bisect

imported by: random • statistics • urllib.request

builtins (builtin module)

imported by: bz2 • codecs • enum • gettext • gzip • inspect • locale • lzma • operator • pydoc • reprlib • subprocess • tarfile • tokenize • warnings

bz2 SourceModule

imports: _bz2 • _compression • builtins • io • os

imported by: encodings.bz2_codec • shutil • tarfile • zipfile

calendar SourceModule

imports: argparse • datetime • enum • itertools • locale • sys • warnings

imported by: _strptime • email._parseaddr • http.cookiejar • ssl

codecs SourceModule

imports: _codecs • builtins • encodings • sys

imported by: _pickle • ads7953_diagnostic_gui.py • encodings • encodings.ascii • encodings.base64_codec • encodings.big5 • encodings.big5hkscs • encodings.bz2_codec • encodings.charmap • encodings.cp037 • encodings.cp1006 • encodings.cp1026 • encodings.cp1125 • encodings.cp1140 • encodings.cp1250 • encodings.cp1251 • encodings.cp1252 • encodings.cp1253 • encodings.cp1254 • encodings.cp1255 • encodings.cp1256 • encodings.cp1257 • encodings.cp1258 • encodings.cp273 • encodings.cp424 • encodings.cp437 • encodings.cp500 • encodings.cp720 • encodings.cp737 • encodings.cp775 • encodings.cp850 • encodings.cp852 • encodings.cp855 • encodings.cp856 • encodings.cp857 • encodings.cp858 • encodings.cp860 • encodings.cp861 • encodings.cp862 • encodings.cp863 • encodings.cp864 • encodings.cp865 • encodings.cp866 • encodings.cp869 • encodings.cp874 • encodings.cp875 • encodings.cp932 • encodings.cp949 • encodings.cp950 • encodings.euc_jis_2004 • encodings.euc_jisx0213 • encodings.euc_jp • encodings.euc_kr • encodings.gb18030 • encodings.gb2312 • encodings.gbk • encodings.hex_codec • encodings.hp_roman8 • encodings.hz • encodings.idna • encodings.iso2022_jp • encodings.iso2022_jp_1 • encodings.iso2022_jp_2 • encodings.iso2022_jp_2004 • encodings.iso2022_jp_3 • encodings.iso2022_jp_ext • encodings.iso2022_kr • encodings.iso8859_1 • encodings.iso8859_10 • encodings.iso8859_11 • encodings.iso8859_13 • encodings.iso8859_14 • encodings.iso8859_15 • encodings.iso8859_16 • encodings.iso8859_2 • encodings.iso8859_3 • encodings.iso8859_4 • encodings.iso8859_5 • encodings.iso8859_6 • encodings.iso8859_7 • encodings.iso8859_8 • encodings.iso8859_9 • encodings.johab • encodings.koi8_r • encodings.koi8_t • encodings.koi8_u • encodings.kz1048 • encodings.latin_1 • encodings.mac_arabic • encodings.mac_croatian • encodings.mac_cyrillic • encodings.mac_farsi • encodings.mac_greek • encodings.mac_iceland • encodings.mac_latin2 • encodings.mac_roman • encodings.mac_romanian • encodings.mac_turkish • encodings.mbcs • encodings.oem • encodings.palmos • encodings.ptcp154 • encodings.punycode • encodings.quopri_codec • encodings.raw_unicode_escape • encodings.rot_13 • encodings.shift_jis • encodings.shift_jis_2004 • encodings.shift_jisx0213 • encodings.tis_620 • encodings.undefined • encodings.unicode_escape • encodings.utf_16 • encodings.utf_16_be • encodings.utf_16_le • encodings.utf_32 • encodings.utf_32_be • encodings.utf_32_le • encodings.utf_7 • encodings.utf_8 • encodings.utf_8_sig • encodings.uu_codec • encodings.zlib_codec • json • pickle • tokenize • xml.sax.saxutils

collections Package

imports: _collections • _collections_abc • _weakref • copy • heapq • itertools • keyword • operator • reprlib • sys

imported by: _pydecimal • ads7953_diagnostic_gui.py • ast • contextlib • dis • email.feedparser • functools • importlib.metadata • importlib.metadata._collections • importlib.resources.readers • inspect • openpyxl.chart._chart • openpyxl.formatting.formatting • openpyxl.pivot.table • openpyxl.utils.bound_dictionary • openpyxl.workbook.defined_name • openpyxl.worksheet._writer • openpyxl.worksheet.datavalidation • pkgutil • platform • pprint • pydoc • queue • selectors • shlex • shutil • ssl • statistics • string • threading • tkinter • tokenize • typing • urllib.parse • xml.etree.ElementTree

contextlib SourceModule

imports: _collections_abc • abc • collections • functools • os • sys • types

imported by: _aix_support • _threading_local • ast • et_xmlfile.incremental_tree • et_xmlfile.xmlfile • getpass • glob • http.server • importlib.metadata • importlib.resources._adapters • importlib.resources._common • importlib.resources.readers • subprocess • traceback • typing • urllib.request • xml.etree.ElementTree • zipfile._path

contextvars SourceModule

imports: _contextvars

imported by: _pydecimal

copy SourceModule

imports: copyreg • types • weakref

imported by: _sre • argparse • collections • dataclasses • email.generator • gettext • http.cookiejar • http.server • openpyxl.cell.cell • openpyxl.cell.rich_text • openpyxl.descriptors.serialisable • openpyxl.styles.proxy • openpyxl.styles.styleable • openpyxl.workbook.workbook • openpyxl.worksheet._reader • openpyxl.worksheet.cell_range • openpyxl.worksheet.copier • openpyxl.worksheet.dimensions • openpyxl.worksheet.merge • tarfile • weakref • webbrowser • xml.dom.xmlbuilder • xml.etree.ElementInclude

copyreg SourceModule

imports: functools • operator

imported by: _pickle • ads7953_diagnostic_gui.py • copy • pickle • re • typing

csv SourceModule

imports: _csv • io • re • types

imported by: importlib.metadata

ctypes Package

imports: _ctypes • ctypes._endian • nt • os • struct • sys • types • warnings

imported by: ctypes._endian • ctypes.wintypes • platform • serial.serialwin32 • serial.tools.list_ports_osx • serial.tools.list_ports_windows • serial.win32 • webbrowser

ctypes._endian SourceModule

imports: ctypes • sys

imported by: ctypes

ctypes.wintypes SourceModule

imports: ctypes

imported by: serial.tools.list_ports_windows • serial.win32

dataclasses SourceModule

imports: abc • copy • inspect • itertools • keyword • re • reprlib • sys • types

imported by: pprint

datetime SourceModule

imports: _datetime • _pydatetime • time

imported by: _strptime • ads7953_Nboard_gui • ads7953_diagnostic_gui.py • calendar • email.utils • http.cookiejar • http.server • openpyxl.cell._writer • openpyxl.cell.cell • openpyxl.compat.strings • openpyxl.descriptors.base • openpyxl.packaging.core • openpyxl.utils.datetime • openpyxl.writer.excel • xmlrpc.client • xmlrpc.server

decimal SourceModule

imports: _decimal • _pydecimal • sys

imported by: fractions • openpyxl.compat.numbers • statistics • xmlrpc.client

defusedxml Package

imports: __future__ • defusedxml • defusedxml.ElementTree • defusedxml.cElementTree • defusedxml.common • defusedxml.expatbuilder • defusedxml.expatreader • defusedxml.minidom • defusedxml.pulldom • defusedxml.sax • defusedxml.xmlrpc • warnings

imported by: defusedxml • defusedxml.ElementTree • defusedxml.cElementTree • defusedxml.common • defusedxml.expatbuilder • defusedxml.expatreader • defusedxml.minidom • defusedxml.pulldom • defusedxml.sax • defusedxml.xmlrpc • openpyxl.xml

defusedxml.ElementTree SourceModule

imports: __future__ • defusedxml • defusedxml.common • importlib • sys • warnings • xml.etree.ElementTree

imported by: defusedxml • defusedxml.cElementTree • openpyxl.xml.functions

defusedxml.cElementTree SourceModule

imports: __future__ • defusedxml • defusedxml.ElementTree • defusedxml.common • warnings • xml.etree.ElementTree • xml.etree.cElementTree

imported by: defusedxml

defusedxml.common SourceModule

imports: defusedxml • sys • xml.parsers.expat

imported by: defusedxml • defusedxml.ElementTree • defusedxml.cElementTree • defusedxml.expatbuilder • defusedxml.expatreader • defusedxml.xmlrpc

defusedxml.expatbuilder SourceModule

imports: __future__ • defusedxml • defusedxml.common • xml.dom.expatbuilder

imported by: defusedxml • defusedxml.minidom

defusedxml.expatreader SourceModule

imports: __future__ • defusedxml • defusedxml.common • xml.sax.expatreader

imported by: defusedxml • defusedxml.sax

defusedxml.minidom SourceModule

imports: __future__ • defusedxml • defusedxml.expatbuilder • defusedxml.pulldom • xml.dom.minidom

imported by: defusedxml

defusedxml.pulldom SourceModule

imports: __future__ • defusedxml • defusedxml.sax • xml.dom.pulldom

imported by: defusedxml • defusedxml.minidom

defusedxml.sax SourceModule

imports: __future__ • defusedxml • defusedxml.expatreader • io • xml.sax

imported by: defusedxml • defusedxml.pulldom

defusedxml.xmlrpc SourceModule

imports: __future__ • defusedxml • defusedxml.common • gzip • io • xmlrpc • xmlrpc.client • xmlrpc.server • xmlrpclib

imported by: defusedxml

dis SourceModule

imports: _opcode • argparse • collections • io • opcode • sys • types

imported by: inspect

email Package

imports: email._header_value_parser • email.charset • email.errors • email.header • email.parser

imported by: email._encoded_words • email._header_value_parser • email._parseaddr • email._policybase • email.base64mime • email.charset • email.contentmanager • email.encoders • email.errors • email.feedparser • email.generator • email.header • email.headerregistry • email.iterators • email.message • email.parser • email.policy • email.quoprimime • email.utils • importlib.metadata • urllib.request

email._encoded_words SourceModule

imports: base64 • binascii • email • email.errors • functools • re • string

imported by: email._header_value_parser • email.message

email._header_value_parser SourceModule

imports: email • email._encoded_words • email.errors • email.utils • operator • re • string • sys • urllib

imported by: email • email.headerregistry

email._parseaddr SourceModule

imports: calendar • email • time

imported by: email.utils

email._policybase SourceModule

imports: abc • email • email.charset • email.header • email.utils

imported by: email.feedparser • email.message • email.parser • email.policy

email.base64mime SourceModule

imports: base64 • binascii • email

imported by: email.charset • email.header

email.charset SourceModule

imports: email • email.base64mime • email.encoders • email.errors • email.quoprimime • functools

imported by: email • email._policybase • email.contentmanager • email.header • email.message • email.utils

email.contentmanager SourceModule

imports: binascii • email • email.charset • email.errors • email.message • email.quoprimime

imported by: email.policy

email.encoders SourceModule

imports: base64 • email • quopri

imported by: email.charset

email.errors SourceModule

imports: email

imported by: email • email._encoded_words • email._header_value_parser • email.charset • email.contentmanager • email.feedparser • email.generator • email.header • email.headerregistry • email.message

email.feedparser SourceModule

imports: collections • email • email._policybase • email.errors • email.message • io • re

imported by: email.parser

email.generator SourceModule

imports: copy • email • email.errors • email.utils • io • random • re • sys • time

imported by: email.message

email.header SourceModule

imports: binascii • email • email.base64mime • email.charset • email.errors • email.quoprimime • re

imported by: email • email._policybase

email.headerregistry SourceModule

imports: email • email._header_value_parser • email.errors • email.utils • types

imported by: email.policy

email.iterators SourceModule

imports: email • io • sys

imported by: email.message

email.message SourceModule

imports: binascii • email • email._encoded_words • email._policybase • email.charset • email.errors • email.generator • email.iterators • email.policy • email.utils • io • quopri • re

imported by: email.contentmanager • email.feedparser • email.policy • http.client • importlib.metadata._adapters • pydoc

email.parser SourceModule

imports: email • email._policybase • email.feedparser • io

imported by: email • http.client

email.policy SourceModule

imports: email • email._policybase • email.contentmanager • email.headerregistry • email.message • email.utils • re • sys

imported by: email.message

email.quoprimime SourceModule

imports: email • re • string

imported by: email.charset • email.contentmanager • email.header

email.utils SourceModule

imports: datetime • email • email._parseaddr • email.charset • os • random • re • socket • time • urllib.parse • warnings

imported by: email._header_value_parser • email._policybase • email.generator • email.headerregistry • email.message • email.policy • http.server • urllib.request

encodings Package

imports: _winapi • codecs • encodings • encodings.aliases • encodings.ascii • encodings.base64_codec • encodings.big5 • encodings.big5hkscs • encodings.bz2_codec • encodings.charmap • encodings.cp037 • encodings.cp1006 • encodings.cp1026 • encodings.cp1125 • encodings.cp1140 • encodings.cp1250 • encodings.cp1251 • encodings.cp1252 • encodings.cp1253 • encodings.cp1254 • encodings.cp1255 • encodings.cp1256 • encodings.cp1257 • encodings.cp1258 • encodings.cp273 • encodings.cp424 • encodings.cp437 • encodings.cp500 • encodings.cp720 • encodings.cp737 • encodings.cp775 • encodings.cp850 • encodings.cp852 • encodings.cp855 • encodings.cp856 • encodings.cp857 • encodings.cp858 • encodings.cp860 • encodings.cp861 • encodings.cp862 • encodings.cp863 • encodings.cp864 • encodings.cp865 • encodings.cp866 • encodings.cp869 • encodings.cp874 • encodings.cp875 • encodings.cp932 • encodings.cp949 • encodings.cp950 • encodings.euc_jis_2004 • encodings.euc_jisx0213 • encodings.euc_jp • encodings.euc_kr • encodings.gb18030 • encodings.gb2312 • encodings.gbk • encodings.hex_codec • encodings.hp_roman8 • encodings.hz • encodings.idna • encodings.iso2022_jp • encodings.iso2022_jp_1 • encodings.iso2022_jp_2 • encodings.iso2022_jp_2004 • encodings.iso2022_jp_3 • encodings.iso2022_jp_ext • encodings.iso2022_kr • encodings.iso8859_1 • encodings.iso8859_10 • encodings.iso8859_11 • encodings.iso8859_13 • encodings.iso8859_14 • encodings.iso8859_15 • encodings.iso8859_16 • encodings.iso8859_2 • encodings.iso8859_3 • encodings.iso8859_4 • encodings.iso8859_5 • encodings.iso8859_6 • encodings.iso8859_7 • encodings.iso8859_8 • encodings.iso8859_9 • encodings.johab • encodings.koi8_r • encodings.koi8_t • encodings.koi8_u • encodings.kz1048 • encodings.latin_1 • encodings.mac_arabic • encodings.mac_croatian • encodings.mac_cyrillic • encodings.mac_farsi • encodings.mac_greek • encodings.mac_iceland • encodings.mac_latin2 • encodings.mac_roman • encodings.mac_romanian • encodings.mac_turkish • encodings.mbcs • encodings.oem • encodings.palmos • encodings.ptcp154 • encodings.punycode • encodings.quopri_codec • encodings.raw_unicode_escape • encodings.rot_13 • encodings.shift_jis • encodings.shift_jis_2004 • encodings.shift_jisx0213 • encodings.tis_620 • encodings.undefined • encodings.unicode_escape • encodings.utf_16 • encodings.utf_16_be • encodings.utf_16_le • encodings.utf_32 • encodings.utf_32_be • encodings.utf_32_le • encodings.utf_7 • encodings.utf_8 • encodings.utf_8_sig • encodings.uu_codec • encodings.zlib_codec • sys

imported by: ads7953_diagnostic_gui.py • codecs • encodings • encodings.aliases • encodings.ascii • encodings.base64_codec • encodings.big5 • encodings.big5hkscs • encodings.bz2_codec • encodings.charmap • encodings.cp037 • encodings.cp1006 • encodings.cp1026 • encodings.cp1125 • encodings.cp1140 • encodings.cp1250 • encodings.cp1251 • encodings.cp1252 • encodings.cp1253 • encodings.cp1254 • encodings.cp1255 • encodings.cp1256 • encodings.cp1257 • encodings.cp1258 • encodings.cp273 • encodings.cp424 • encodings.cp437 • encodings.cp500 • encodings.cp720 • encodings.cp737 • encodings.cp775 • encodings.cp850 • encodings.cp852 • encodings.cp855 • encodings.cp856 • encodings.cp857 • encodings.cp858 • encodings.cp860 • encodings.cp861 • encodings.cp862 • encodings.cp863 • encodings.cp864 • encodings.cp865 • encodings.cp866 • encodings.cp869 • encodings.cp874 • encodings.cp875 • encodings.cp932 • encodings.cp949 • encodings.cp950 • encodings.euc_jis_2004 • encodings.euc_jisx0213 • encodings.euc_jp • encodings.euc_kr • encodings.gb18030 • encodings.gb2312 • encodings.gbk • encodings.hex_codec • encodings.hp_roman8 • encodings.hz • encodings.idna • encodings.iso2022_jp • encodings.iso2022_jp_1 • encodings.iso2022_jp_2 • encodings.iso2022_jp_2004 • encodings.iso2022_jp_3 • encodings.iso2022_jp_ext • encodings.iso2022_kr • encodings.iso8859_1 • encodings.iso8859_10 • encodings.iso8859_11 • encodings.iso8859_13 • encodings.iso8859_14 • encodings.iso8859_15 • encodings.iso8859_16 • encodings.iso8859_2 • encodings.iso8859_3 • encodings.iso8859_4 • encodings.iso8859_5 • encodings.iso8859_6 • encodings.iso8859_7 • encodings.iso8859_8 • encodings.iso8859_9 • encodings.johab • encodings.koi8_r • encodings.koi8_t • encodings.koi8_u • encodings.kz1048 • encodings.latin_1 • encodings.mac_arabic • encodings.mac_croatian • encodings.mac_cyrillic • encodings.mac_farsi • encodings.mac_greek • encodings.mac_iceland • encodings.mac_latin2 • encodings.mac_roman • encodings.mac_romanian • encodings.mac_turkish • encodings.mbcs • encodings.oem • encodings.palmos • encodings.ptcp154 • encodings.punycode • encodings.quopri_codec • encodings.raw_unicode_escape • encodings.rot_13 • encodings.shift_jis • encodings.shift_jis_2004 • encodings.shift_jisx0213 • encodings.tis_620 • encodings.undefined • encodings.unicode_escape • encodings.utf_16 • encodings.utf_16_be • encodings.utf_16_le • encodings.utf_32 • encodings.utf_32_be • encodings.utf_32_le • encodings.utf_7 • encodings.utf_8 • encodings.utf_8_sig • encodings.uu_codec • encodings.zlib_codec • locale

encodings.aliases SourceModule

imports: encodings

imported by: ads7953_diagnostic_gui.py • encodings • locale

encodings.ascii SourceModule

imports: codecs • encodings

imported by: ads7953_diagnostic_gui.py • encodings

encodings.base64_codec SourceModule

imports: base64 • codecs • encodings

imported by: ads7953_diagnostic_gui.py • encodings

encodings.big5 SourceModule

imports: _codecs_tw • _multibytecodec • codecs • encodings

imported by: ads7953_diagnostic_gui.py • encodings

encodings.big5hkscs SourceModule

imports: _codecs_hk • _multibytecodec • codecs • encodings

imported by: ads7953_diagnostic_gui.py • encodings

encodings.bz2_codec SourceModule

imports: bz2 • codecs • encodings

imported by: ads7953_diagnostic_gui.py • encodings

encodings.charmap SourceModule

imports: codecs • encodings

imported by: ads7953_diagnostic_gui.py • encodings

encodings.cp037 SourceModule

imports: codecs • encodings

imported by: ads7953_diagnostic_gui.py • encodings

encodings.cp1006 SourceModule

imports: codecs • encodings

imported by: ads7953_diagnostic_gui.py • encodings

encodings.cp1026 SourceModule

imports: codecs • encodings

imported by: ads7953_diagnostic_gui.py • encodings

encodings.cp1125 SourceModule

imports: codecs • encodings

imported by: ads7953_diagnostic_gui.py • encodings

encodings.cp1140 SourceModule

imports: codecs • encodings

imported by: ads7953_diagnostic_gui.py • encodings

encodings.cp1250 SourceModule

imports: codecs • encodings

imported by: ads7953_diagnostic_gui.py • encodings

encodings.cp1251 SourceModule

imports: codecs • encodings

imported by: ads7953_diagnostic_gui.py • encodings

encodings.cp1252 SourceModule

imports: codecs • encodings

imported by: ads7953_diagnostic_gui.py • encodings

encodings.cp1253 SourceModule

imports: codecs • encodings

imported by: ads7953_diagnostic_gui.py • encodings

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

imports: codecs • encodings

imported by: ads7953_diagnostic_gui.py • encodings

encodings.punycode SourceModule

imports: codecs • encodings

imported by: ads7953_diagnostic_gui.py • encodings

encodings.quopri_codec SourceModule

imports: codecs • encodings • io • quopri

imported by: ads7953_diagnostic_gui.py • encodings

encodings.raw_unicode_escape SourceModule

imports: codecs • encodings

imported by: ads7953_diagnostic_gui.py • encodings

encodings.rot_13 SourceModule

imports: codecs • encodings • sys

imported by: ads7953_diagnostic_gui.py • encodings

encodings.shift_jis SourceModule

imports: _codecs_jp • _multibytecodec • codecs • encodings

imported by: ads7953_diagnostic_gui.py • encodings

encodings.shift_jis_2004 SourceModule

imports: _codecs_jp • _multibytecodec • codecs • encodings

imported by: ads7953_diagnostic_gui.py • encodings

encodings.shift_jisx0213 SourceModule

imports: _codecs_jp • _multibytecodec • codecs • encodings

imported by: ads7953_diagnostic_gui.py • encodings

encodings.tis_620 SourceModule

imports: codecs • encodings

imported by: ads7953_diagnostic_gui.py • encodings

encodings.undefined SourceModule

imports: codecs • encodings

imported by: ads7953_diagnostic_gui.py • encodings

encodings.unicode_escape SourceModule

imports: codecs • encodings

imported by: ads7953_diagnostic_gui.py • encodings

encodings.utf_16 SourceModule

imports: codecs • encodings • sys

imported by: ads7953_diagnostic_gui.py • encodings

encodings.utf_16_be SourceModule

imports: codecs • encodings

imported by: ads7953_diagnostic_gui.py • encodings

encodings.utf_16_le SourceModule

imports: codecs • encodings

imported by: ads7953_diagnostic_gui.py • encodings

encodings.utf_32 SourceModule

imports: codecs • encodings • sys

imported by: ads7953_diagnostic_gui.py • encodings

encodings.utf_32_be SourceModule

imports: codecs • encodings

imported by: ads7953_diagnostic_gui.py • encodings

encodings.utf_32_le SourceModule

imports: codecs • encodings

imported by: ads7953_diagnostic_gui.py • encodings

encodings.utf_7 SourceModule

imports: codecs • encodings

imported by: ads7953_diagnostic_gui.py • encodings

encodings.utf_8 SourceModule

imports: codecs • encodings

imported by: ads7953_diagnostic_gui.py • encodings

encodings.utf_8_sig SourceModule

imports: codecs • encodings

imported by: ads7953_diagnostic_gui.py • encodings

encodings.uu_codec SourceModule

imports: binascii • codecs • encodings • io

imported by: ads7953_diagnostic_gui.py • encodings

encodings.zlib_codec SourceModule

imports: codecs • encodings • zlib

imported by: ads7953_diagnostic_gui.py • encodings

enum SourceModule

imports: builtins • functools • sys • types • warnings

imported by: ads7953_diagnostic_gui.py • ast • calendar • http • inspect • py_compile • re • signal • socket • ssl • tkinter

errno (builtin module)

imported by: gettext • gzip • http.client • pathlib._abc • posixpath • serial.serialposix • shutil • socket • ssl • subprocess • tempfile • xmlrpc.client

et_xmlfile Package

imports: et_xmlfile • et_xmlfile.incremental_tree • et_xmlfile.xmlfile

imported by: et_xmlfile • et_xmlfile.incremental_tree • et_xmlfile.xmlfile • openpyxl.xml.functions

et_xmlfile.incremental_tree SourceModule

imports: contextlib • et_xmlfile • io • xml.etree.ElementTree

imported by: et_xmlfile • et_xmlfile.xmlfile

et_xmlfile.xmlfile SourceModule

imports: __future__ • contextlib • et_xmlfile • et_xmlfile.incremental_tree • xml.etree.ElementTree

imported by: et_xmlfile • openpyxl.xml.functions

fcntl MissingModule

imported by: serial.serialposix • subprocess • xmlrpc.server

fnmatch SourceModule

imports: functools • os • posixpath • re

imported by: glob • shutil • tkinter.filedialog • tracemalloc • urllib.request

fractions SourceModule

imports: decimal • functools • math • numbers • operator • re • sys

imported by: statistics

ftplib SourceModule

imports: netrc • re • socket • ssl • sys

imported by: urllib.request

functools SourceModule

imports: _functools • _thread • abc • collections • reprlib • types • typing • warnings • weakref

imported by: ads7953_diagnostic_gui.py • contextlib • copyreg • email._encoded_words • email.charset • enum • fnmatch • fractions • glob • importlib.metadata • importlib.metadata._adapters • importlib.metadata._functools • importlib.resources._common • inspect • ipaddress • locale • openpyxl.compat • openpyxl.utils.cell • openpyxl.xml.functions • operator • pathlib._abc • pickle • pkgutil • platform • re • statistics • tempfile • tokenize • tracemalloc • types • typing • urllib.parse • warnings • xmlrpc.server

gc (builtin module)

imports: time

imported by: _posixsubprocess • weakref

genericpath SourceModule

imports: os • stat

imported by: ads7953_diagnostic_gui.py • ntpath • posixpath

getopt SourceModule

imports: gettext • os • sys

imported by: base64 • mimetypes • pydoc • quopri

getpass SourceModule

imports: contextlib • io • msvcrt • os • pwd • sys • termios • warnings

imported by: urllib.request

gettext SourceModule

imports: builtins • copy • errno • locale • operator • os • re • struct • sys • warnings

imported by: argparse • getopt

glob SourceModule

imports: contextlib • fnmatch • functools • itertools • operator • os • re • stat • sys • warnings

imported by: pathlib._abc • pathlib._local • serial.tools.list_ports_common • serial.tools.list_ports_linux • serial.tools.list_ports_posix

grp MissingModule

imported by: pathlib._local • shutil • subprocess • tarfile

gzip SourceModule

imports: _compression • argparse • builtins • errno • io • os • struct • sys • time • warnings • weakref • zlib

imported by: defusedxml.xmlrpc • tarfile • xmlrpc.client

hashlib SourceModule

imports: _blake2 • _hashlib • _md5 • _sha1 • _sha2 • _sha3 • logging

imported by: openpyxl.chartsheet.protection • random • urllib.request

heapq SourceModule

imports: _heapq

imported by: ads7953_diagnostic_gui.py • collections • queue

html Package

imports: html.entities • re

imported by: html.entities • http.server • xmlrpc.server

html.entities SourceModule

imports: html

imported by: html

http Package

imports: enum

imported by: http.client • http.cookiejar • http.server

http.client SourceModule

imports: 'collections.abc' • email.message • email.parser • errno • http • io • re • socket • ssl • sys • urllib.parse

imported by: http.cookiejar • http.server • urllib.request • xmlrpc.client

http.cookiejar SourceModule

imports: calendar • copy • datetime • http • http.client • io • logging • os • re • threading • time • traceback • urllib.parse • urllib.request • warnings

imported by: urllib.request

http.server SourceModule

imports: argparse • base64 • binascii • contextlib • copy • datetime • email.utils • html • http • http.client • io • itertools • mimetypes • os • posixpath • pwd • select • shutil • socket • socketserver • subprocess • sys • time • urllib.parse • warnings

imported by: pydoc • xmlrpc.server

importlib Package

imports: _frozen_importlib • _frozen_importlib_external • _imp • importlib • importlib._bootstrap • importlib._bootstrap_external • sys

imported by: defusedxml.ElementTree • importlib • importlib._abc • importlib._bootstrap • importlib._bootstrap_external • importlib.abc • importlib.machinery • importlib.metadata • importlib.readers • importlib.resources • importlib.resources._common • importlib.util • inspect • pkgutil • serial

importlib._abc SourceModule

imports: abc • importlib • importlib._bootstrap

imported by: importlib.abc • importlib.util

importlib._bootstrap SourceModule

imports: _frozen_importlib_external • importlib

imported by: importlib • importlib._abc • importlib.machinery • importlib.util • pydoc

importlib._bootstrap_external SourceModule

imports: _imp • _io • _warnings • importlib • importlib.metadata • importlib.readers • marshal • nt • posix • sys • tokenize • winreg

imported by: importlib • importlib.abc • importlib.machinery • importlib.util • py_compile • pydoc

importlib.abc SourceModule

imports: _frozen_importlib • _frozen_importlib_external • abc • importlib • importlib._abc • importlib._bootstrap_external • importlib.machinery • importlib.resources • importlib.resources.abc • warnings

imported by: importlib.metadata

importlib.machinery SourceModule

imports: importlib • importlib._bootstrap • importlib._bootstrap_external

imported by: importlib.abc • inspect • pkgutil • py_compile • pydoc • sysconfig

importlib.metadata Package

imports: __future__ • abc • collections • contextlib • csv • email • functools • importlib • importlib.abc • importlib.metadata • importlib.metadata._adapters • importlib.metadata._collections • importlib.metadata._functools • importlib.metadata._itertools • importlib.metadata._meta • inspect • itertools • json • operator • os • pathlib • posixpath • re • sys • textwrap • types • typing • warnings • zipfile

imported by: importlib._bootstrap_external • importlib.metadata • importlib.metadata._adapters • importlib.metadata._collections • importlib.metadata._functools • importlib.metadata._itertools • importlib.metadata._meta • importlib.metadata._text

importlib.metadata._adapters SourceModule

imports: email.message • functools • importlib.metadata • importlib.metadata._text • re • textwrap • warnings

imported by: importlib.metadata

importlib.metadata._collections SourceModule

imports: collections • importlib.metadata

imported by: importlib.metadata

importlib.metadata._functools SourceModule

imports: functools • importlib.metadata • types

imported by: importlib.metadata • importlib.metadata._text

importlib.metadata._itertools SourceModule

imports: importlib.metadata • itertools

imported by: importlib.metadata

importlib.metadata._meta SourceModule

imports: __future__ • importlib.metadata • os • typing

imported by: importlib.metadata

importlib.metadata._text SourceModule

imports: importlib.metadata • importlib.metadata._functools • re

imported by: importlib.metadata._adapters

importlib.readers SourceModule

imports: importlib • importlib.resources.readers

imported by: importlib._bootstrap_external • zipimport

importlib.resources Package

imports: importlib • importlib.resources • importlib.resources._common • importlib.resources._functional • importlib.resources.abc

imported by: importlib.abc • importlib.resources • importlib.resources._adapters • importlib.resources._common • importlib.resources._functional • importlib.resources._itertools • importlib.resources.abc • importlib.resources.readers

importlib.resources._adapters SourceModule

imports: contextlib • importlib.resources • importlib.resources.abc • io

imported by: importlib.resources._common

importlib.resources._common SourceModule

imports: contextlib • functools • importlib • importlib.resources • importlib.resources._adapters • importlib.resources.abc • inspect • itertools • os • pathlib • tempfile • types • typing • warnings

imported by: importlib.resources • importlib.resources._functional

importlib.resources._functional SourceModule

imports: importlib.resources • importlib.resources._common • warnings

imported by: importlib.resources

importlib.resources._itertools SourceModule

imports: importlib.resources

imported by: importlib.resources.readers

importlib.resources.abc SourceModule

imports: abc • importlib.resources • io • itertools • os • pathlib • typing

imported by: importlib.abc • importlib.resources • importlib.resources._adapters • importlib.resources._common • importlib.resources.readers

importlib.resources.readers SourceModule

imports: 'collections.abc' • __future__ • collections • contextlib • importlib.resources • importlib.resources._itertools • importlib.resources.abc • itertools • operator • pathlib • re • warnings • zipfile

imported by: importlib.readers

importlib.util SourceModule

imports: _imp • importlib • importlib._abc • importlib._bootstrap • importlib._bootstrap_external • sys • threading • types

imported by: pkgutil • py_compile • pydoc • sysconfig • zipfile

inspect SourceModule

imports: 'collections.abc' • abc • argparse • ast • builtins • collections • dis • enum • functools • importlib • importlib.machinery • itertools • keyword • linecache • operator • os • re • sys • token • tokenize • types • weakref

imported by: ast • dataclasses • importlib.metadata • importlib.resources._common • openpyxl.compat • openpyxl.worksheet._write_only • openpyxl.worksheet.worksheet • pkgutil • pydoc • pyi_rth_inspect.py • typing • warnings • xmlrpc.server

io SourceModule

imports: _io • abc

imported by: _colorize • _compression • _pyrepl.pager • ads7953_diagnostic_gui.py • bz2 • csv • defusedxml.sax • defusedxml.xmlrpc • dis • email.feedparser • email.generator • email.iterators • email.message • email.parser • encodings.quopri_codec • encodings.uu_codec • et_xmlfile.incremental_tree • getpass • gzip • http.client • http.cookiejar • http.server • importlib.resources._adapters • importlib.resources.abc • logging • lzma • openpyxl.drawing.image • openpyxl.reader.drawings • openpyxl.reader.excel • openpyxl.worksheet._writer • os • pathlib._local • pickle • pprint • pydoc • quopri • serial.serialutil • shlex • socket • socketserver • subprocess • tarfile • tempfile • tokenize • urllib.error • urllib.request • xml.dom.minidom • xml.dom.pulldom • xml.etree.ElementTree • xml.sax • xml.sax.saxutils • xmlrpc.client • zipfile • zipfile._path

ipaddress SourceModule

imports: functools • re

imported by: urllib.parse • urllib.request

itertools (builtin module)

imported by: _pydecimal • calendar • collections • dataclasses • glob • http.server • importlib.metadata • importlib.metadata._itertools • importlib.resources._common • importlib.resources.abc • importlib.resources.readers • inspect • openpyxl.chart.reference • openpyxl.utils.cell • openpyxl.worksheet.cell_range • openpyxl.worksheet.datavalidation • openpyxl.worksheet.worksheet • pathlib._local • pickle • platform • random • reprlib • statistics • threading • tokenize • traceback • weakref • zipfile._path

java MissingModule

imported by: platform

json Package

imports: codecs • json.decoder • json.encoder • json.scanner

imported by: importlib.metadata • json.decoder • json.encoder • json.scanner

json.decoder SourceModule

imports: _json • json • json.scanner • re

imported by: _json • json

json.encoder SourceModule

imports: _json • json • re

imported by: json

json.scanner SourceModule

imports: _json • json • re

imported by: json • json.decoder

keyword SourceModule

imported by: ads7953_diagnostic_gui.py • collections • dataclasses • inspect • openpyxl.descriptors.serialisable

linecache SourceModule

imports: os • sys • tokenize

imported by: ads7953_diagnostic_gui.py • inspect • traceback • tracemalloc • warnings

locale SourceModule

imports: _collections_abc • _locale • builtins • encodings • encodings.aliases • functools • os • re • sys • warnings

imported by: _pydecimal • _strptime • ads7953_diagnostic_gui.py • calendar • gettext • subprocess • tkinter.filedialog

logging Package

imports: 'collections.abc' • atexit • io • os • pickle • re • string • sys • threading • time • traceback • types • warnings • weakref

imported by: hashlib • http.cookiejar

lzma SourceModule

imports: _compression • _lzma • builtins • io • os

imported by: shutil • tarfile • zipfile

marshal (builtin module)

imported by: importlib._bootstrap_external • pkgutil • zipimport

math (builtin module)

imported by: _pydatetime • _pydecimal • fractions • openpyxl.compat.strings • openpyxl.drawing.drawing • openpyxl.utils.datetime • openpyxl.utils.units • random • reprlib • selectors • statistics • urllib.parse

mimetypes SourceModule

imports: _winapi • getopt • os • posixpath • sys • urllib.parse • winreg

imported by: http.server • openpyxl.packaging.manifest • urllib.request

msvcrt (builtin module)

imported by: getpass • subprocess

netrc SourceModule

imports: os • pwd • stat

imported by: ftplib

nt (builtin module)

imported by: _colorize • ctypes • importlib._bootstrap_external • ntpath • os • shutil

ntpath SourceModule

imports: _winapi • genericpath • nt • os • string • sys

imported by: ads7953_diagnostic_gui.py • os • os.path • pathlib._local

nturl2path SourceModule

imports: string • urllib.parse

imported by: urllib.request

numbers SourceModule

imports: abc

imported by: _pydecimal • fractions • statistics

numpy ExcludedModule

imported by: openpyxl.compat.numbers

opcode SourceModule

imports: _opcode • _opcode_metadata

imported by: dis

openpyxl Package

imports: openpyxl._constants • openpyxl.compat.numbers • openpyxl.reader.excel • openpyxl.workbook • openpyxl.xml

imported by: ads7953_Nboard_gui • ads7953_diagnostic_gui.py • openpyxl._constants • openpyxl.cell • openpyxl.cell._writer • openpyxl.chart • openpyxl.chartsheet • openpyxl.comments • openpyxl.compat • openpyxl.descriptors • openpyxl.descriptors.base • openpyxl.drawing • openpyxl.formatting • openpyxl.formula • openpyxl.packaging • openpyxl.packaging.extended • openpyxl.pivot • openpyxl.reader • openpyxl.styles • openpyxl.utils • openpyxl.workbook • openpyxl.worksheet • openpyxl.writer • openpyxl.xml • openpyxl.xml.functions

openpyxl._constants SourceModule

imports: openpyxl

imported by: openpyxl

openpyxl.cell Package

imports: openpyxl • openpyxl.cell.cell • openpyxl.cell.read_only

imported by: openpyxl.cell._writer • openpyxl.cell.cell • openpyxl.cell.read_only • openpyxl.cell.rich_text • openpyxl.cell.text • openpyxl.reader.excel • openpyxl.worksheet._reader • openpyxl.worksheet._write_only • openpyxl.worksheet.worksheet

openpyxl.cell._writer SourceModule

imports: datetime • openpyxl • openpyxl.cell • openpyxl.cell.rich_text • openpyxl.compat • openpyxl.utils.datetime • openpyxl.worksheet.formula • openpyxl.xml.functions

imported by: openpyxl.worksheet._writer

openpyxl.cell.cell SourceModule

imports: copy • datetime • openpyxl.cell • openpyxl.cell.rich_text • openpyxl.compat • openpyxl.styles • openpyxl.styles.numbers • openpyxl.styles.styleable • openpyxl.utils • openpyxl.utils.exceptions • openpyxl.worksheet.formula • openpyxl.worksheet.hyperlink • re

imported by: openpyxl.cell • openpyxl.worksheet.merge

openpyxl.cell.read_only SourceModule

imports: openpyxl.cell • openpyxl.styles • openpyxl.styles.numbers • openpyxl.utils • openpyxl.utils.datetime

imported by: openpyxl.cell • openpyxl.worksheet._read_only

openpyxl.cell.rich_text SourceModule

imports: copy • openpyxl.cell • openpyxl.cell.text • openpyxl.compat • openpyxl.descriptors • openpyxl.xml.functions

imported by: openpyxl.cell._writer • openpyxl.cell.cell • openpyxl.reader.strings • openpyxl.worksheet._reader

openpyxl.cell.text SourceModule

imports: openpyxl.cell • openpyxl.descriptors • openpyxl.descriptors.nested • openpyxl.descriptors.serialisable • openpyxl.styles.fonts

imported by: openpyxl.cell.rich_text • openpyxl.comments.comment_sheet • openpyxl.reader.strings • openpyxl.worksheet._reader

openpyxl.chart Package

imports: openpyxl • openpyxl.chart.area_chart • openpyxl.chart.bar_chart • openpyxl.chart.bubble_chart • openpyxl.chart.line_chart • openpyxl.chart.pie_chart • openpyxl.chart.radar_chart • openpyxl.chart.reference • openpyxl.chart.scatter_chart • openpyxl.chart.series_factory • openpyxl.chart.stock_chart • openpyxl.chart.surface_chart

imported by: openpyxl.chart._3d • openpyxl.chart._chart • openpyxl.chart.area_chart • openpyxl.chart.axis • openpyxl.chart.bar_chart • openpyxl.chart.bubble_chart • openpyxl.chart.chartspace • openpyxl.chart.data_source • openpyxl.chart.descriptors • openpyxl.chart.error_bar • openpyxl.chart.label • openpyxl.chart.layout • openpyxl.chart.legend • openpyxl.chart.line_chart • openpyxl.chart.marker • openpyxl.chart.picture • openpyxl.chart.pie_chart • openpyxl.chart.pivot • openpyxl.chart.plotarea • openpyxl.chart.print_settings • openpyxl.chart.radar_chart • openpyxl.chart.reader • openpyxl.chart.reference • openpyxl.chart.scatter_chart • openpyxl.chart.series • openpyxl.chart.series_factory • openpyxl.chart.shapes • openpyxl.chart.stock_chart • openpyxl.chart.surface_chart • openpyxl.chart.text • openpyxl.chart.title • openpyxl.chart.trendline • openpyxl.chart.updown_bars

openpyxl.chart._3d SourceModule

imports: openpyxl.chart • openpyxl.chart.marker • openpyxl.chart.shapes • openpyxl.descriptors • openpyxl.descriptors.excel • openpyxl.descriptors.nested • openpyxl.descriptors.serialisable

imported by: openpyxl.chart._chart • openpyxl.chart.bar_chart • openpyxl.chart.chartspace • openpyxl.chart.plotarea • openpyxl.chart.surface_chart

openpyxl.chart._chart SourceModule

imports: collections • openpyxl.chart • openpyxl.chart._3d • openpyxl.chart.chartspace • openpyxl.chart.data_source • openpyxl.chart.layout • openpyxl.chart.legend • openpyxl.chart.reference • openpyxl.chart.series • openpyxl.chart.series_factory • openpyxl.chart.shapes • openpyxl.chart.title • openpyxl.descriptors • openpyxl.descriptors.sequence • openpyxl.descriptors.serialisable • operator

imported by: openpyxl.chart.area_chart • openpyxl.chart.bar_chart • openpyxl.chart.bubble_chart • openpyxl.chart.line_chart • openpyxl.chart.pie_chart • openpyxl.chart.radar_chart • openpyxl.chart.scatter_chart • openpyxl.chart.stock_chart • openpyxl.chart.surface_chart • openpyxl.drawing.spreadsheet_drawing

openpyxl.chart.area_chart SourceModule

imports: openpyxl.chart • openpyxl.chart._chart • openpyxl.chart.axis • openpyxl.chart.descriptors • openpyxl.chart.label • openpyxl.chart.series • openpyxl.descriptors • openpyxl.descriptors.excel • openpyxl.descriptors.nested • openpyxl.descriptors.serialisable

imported by: openpyxl.chart • openpyxl.chart.plotarea

openpyxl.chart.axis SourceModule

imports: openpyxl.chart • openpyxl.chart.descriptors • openpyxl.chart.layout • openpyxl.chart.shapes • openpyxl.chart.text • openpyxl.chart.title • openpyxl.descriptors • openpyxl.descriptors.excel • openpyxl.descriptors.nested • openpyxl.descriptors.serialisable • openpyxl.xml.constants

imported by: openpyxl.chart.area_chart • openpyxl.chart.bar_chart • openpyxl.chart.bubble_chart • openpyxl.chart.line_chart • openpyxl.chart.pie_chart • openpyxl.chart.plotarea • openpyxl.chart.radar_chart • openpyxl.chart.scatter_chart • openpyxl.chart.stock_chart • openpyxl.chart.surface_chart • openpyxl.chart.updown_bars

openpyxl.chart.bar_chart SourceModule

imports: openpyxl.chart • openpyxl.chart._3d • openpyxl.chart._chart • openpyxl.chart.axis • openpyxl.chart.descriptors • openpyxl.chart.label • openpyxl.chart.legend • openpyxl.chart.series • openpyxl.chart.shapes • openpyxl.descriptors • openpyxl.descriptors.excel • openpyxl.descriptors.nested • openpyxl.descriptors.serialisable

imported by: openpyxl.chart • openpyxl.chart.plotarea

openpyxl.chart.bubble_chart SourceModule

imports: openpyxl.chart • openpyxl.chart._chart • openpyxl.chart.axis • openpyxl.chart.label • openpyxl.chart.series • openpyxl.descriptors • openpyxl.descriptors.excel • openpyxl.descriptors.nested • openpyxl.descriptors.serialisable

imported by: openpyxl.chart • openpyxl.chart.plotarea

openpyxl.chart.chartspace SourceModule

imports: openpyxl.chart • openpyxl.chart._3d • openpyxl.chart.legend • openpyxl.chart.pivot • openpyxl.chart.plotarea • openpyxl.chart.print_settings • openpyxl.chart.shapes • openpyxl.chart.text • openpyxl.chart.title • openpyxl.descriptors • openpyxl.descriptors.excel • openpyxl.descriptors.nested • openpyxl.descriptors.sequence • openpyxl.descriptors.serialisable • openpyxl.drawing.colors • openpyxl.xml.constants

imported by: openpyxl.chart._chart • openpyxl.reader.drawings

openpyxl.chart.data_source SourceModule

imports: openpyxl.chart • openpyxl.descriptors • openpyxl.descriptors.excel • openpyxl.descriptors.nested • openpyxl.descriptors.serialisable

imported by: openpyxl.chart._chart • openpyxl.chart.descriptors • openpyxl.chart.error_bar • openpyxl.chart.series • openpyxl.chart.series_factory • openpyxl.chart.text • openpyxl.chart.trendline

openpyxl.chart.descriptors SourceModule

imports: openpyxl.chart • openpyxl.chart.data_source • openpyxl.descriptors • openpyxl.descriptors.nested

imported by: openpyxl.chart.area_chart • openpyxl.chart.axis • openpyxl.chart.bar_chart • openpyxl.chart.line_chart • openpyxl.chart.pie_chart • openpyxl.chart.updown_bars

openpyxl.chart.error_bar SourceModule

imports: openpyxl.chart • openpyxl.chart.data_source • openpyxl.chart.shapes • openpyxl.descriptors • openpyxl.descriptors.excel • openpyxl.descriptors.nested • openpyxl.descriptors.serialisable

imported by: openpyxl.chart.marker • openpyxl.chart.series

openpyxl.chart.label SourceModule

imports: openpyxl.chart • openpyxl.chart.shapes • openpyxl.chart.text • openpyxl.descriptors • openpyxl.descriptors.excel • openpyxl.descriptors.nested • openpyxl.descriptors.serialisable

imported by: openpyxl.chart.area_chart • openpyxl.chart.bar_chart • openpyxl.chart.bubble_chart • openpyxl.chart.line_chart • openpyxl.chart.pie_chart • openpyxl.chart.pivot • openpyxl.chart.radar_chart • openpyxl.chart.scatter_chart • openpyxl.chart.series • openpyxl.chart.stock_chart

openpyxl.chart.layout SourceModule

imports: openpyxl.chart • openpyxl.descriptors • openpyxl.descriptors.excel • openpyxl.descriptors.nested • openpyxl.descriptors.serialisable

imported by: openpyxl.chart._chart • openpyxl.chart.axis • openpyxl.chart.legend • openpyxl.chart.marker • openpyxl.chart.plotarea • openpyxl.chart.title • openpyxl.chart.trendline

openpyxl.chart.legend SourceModule

imports: openpyxl.chart • openpyxl.chart.layout • openpyxl.chart.shapes • openpyxl.chart.text • openpyxl.descriptors • openpyxl.descriptors.excel • openpyxl.descriptors.nested • openpyxl.descriptors.serialisable

imported by: openpyxl.chart._chart • openpyxl.chart.bar_chart • openpyxl.chart.chartspace

openpyxl.chart.line_chart SourceModule

imports: openpyxl.chart • openpyxl.chart._chart • openpyxl.chart.axis • openpyxl.chart.descriptors • openpyxl.chart.label • openpyxl.chart.series • openpyxl.chart.updown_bars • openpyxl.descriptors • openpyxl.descriptors.excel • openpyxl.descriptors.nested

imported by: openpyxl.chart • openpyxl.chart.plotarea

openpyxl.chart.marker SourceModule

imports: openpyxl.chart • openpyxl.chart.error_bar • openpyxl.chart.layout • openpyxl.chart.picture • openpyxl.chart.shapes • openpyxl.chart.text • openpyxl.descriptors • openpyxl.descriptors.excel • openpyxl.descriptors.nested • openpyxl.descriptors.serialisable

imported by: openpyxl.chart._3d • openpyxl.chart.pivot • openpyxl.chart.series

openpyxl.chart.picture SourceModule

imports: openpyxl.chart • openpyxl.descriptors.nested • openpyxl.descriptors.serialisable

imported by: openpyxl.chart.marker

openpyxl.chart.pie_chart SourceModule

imports: openpyxl.chart • openpyxl.chart._chart • openpyxl.chart.axis • openpyxl.chart.descriptors • openpyxl.chart.label • openpyxl.chart.series • openpyxl.descriptors • openpyxl.descriptors.excel • openpyxl.descriptors.nested • openpyxl.descriptors.sequence • openpyxl.descriptors.serialisable

imported by: openpyxl.chart • openpyxl.chart.plotarea

openpyxl.chart.pivot SourceModule

imports: openpyxl.chart • openpyxl.chart.label • openpyxl.chart.marker • openpyxl.chart.shapes • openpyxl.chart.text • openpyxl.descriptors • openpyxl.descriptors.excel • openpyxl.descriptors.nested • openpyxl.descriptors.serialisable

imported by: openpyxl.chart.chartspace

openpyxl.chart.plotarea SourceModule

imports: openpyxl.chart • openpyxl.chart._3d • openpyxl.chart.area_chart • openpyxl.chart.axis • openpyxl.chart.bar_chart • openpyxl.chart.bubble_chart • openpyxl.chart.layout • openpyxl.chart.line_chart • openpyxl.chart.pie_chart • openpyxl.chart.radar_chart • openpyxl.chart.scatter_chart • openpyxl.chart.shapes • openpyxl.chart.stock_chart • openpyxl.chart.surface_chart • openpyxl.chart.text • openpyxl.descriptors • openpyxl.descriptors.excel • openpyxl.descriptors.nested • openpyxl.descriptors.sequence • openpyxl.descriptors.serialisable

imported by: openpyxl.chart.chartspace

openpyxl.chart.print_settings SourceModule

imports: openpyxl.chart • openpyxl.descriptors • openpyxl.descriptors.serialisable • openpyxl.worksheet.header_footer • openpyxl.worksheet.page

imported by: openpyxl.chart.chartspace

openpyxl.chart.radar_chart SourceModule

imports: openpyxl.chart • openpyxl.chart._chart • openpyxl.chart.axis • openpyxl.chart.label • openpyxl.chart.series • openpyxl.descriptors • openpyxl.descriptors.excel • openpyxl.descriptors.nested • openpyxl.descriptors.serialisable

imported by: openpyxl.chart • openpyxl.chart.plotarea

openpyxl.chart.reader SourceModule

imports: openpyxl.chart

imported by: openpyxl.reader.drawings

openpyxl.chart.reference SourceModule

imports: itertools • openpyxl.chart • openpyxl.descriptors • openpyxl.descriptors.serialisable • openpyxl.utils • openpyxl.worksheet.worksheet

imported by: openpyxl.chart • openpyxl.chart._chart • openpyxl.chart.series_factory

openpyxl.chart.scatter_chart SourceModule

imports: openpyxl.chart • openpyxl.chart._chart • openpyxl.chart.axis • openpyxl.chart.label • openpyxl.chart.series • openpyxl.descriptors • openpyxl.descriptors.excel • openpyxl.descriptors.nested • openpyxl.descriptors.serialisable

imported by: openpyxl.chart • openpyxl.chart.plotarea

openpyxl.chart.series SourceModule

imports: openpyxl.chart • openpyxl.chart.data_source • openpyxl.chart.error_bar • openpyxl.chart.label • openpyxl.chart.marker • openpyxl.chart.shapes • openpyxl.chart.trendline • openpyxl.descriptors • openpyxl.descriptors.excel • openpyxl.descriptors.nested • openpyxl.descriptors.serialisable

imported by: openpyxl.chart._chart • openpyxl.chart.area_chart • openpyxl.chart.bar_chart • openpyxl.chart.bubble_chart • openpyxl.chart.line_chart • openpyxl.chart.pie_chart • openpyxl.chart.radar_chart • openpyxl.chart.scatter_chart • openpyxl.chart.series_factory • openpyxl.chart.stock_chart • openpyxl.chart.surface_chart

openpyxl.chart.series_factory SourceModule

imports: openpyxl.chart • openpyxl.chart.data_source • openpyxl.chart.reference • openpyxl.chart.series • openpyxl.utils

imported by: openpyxl.chart • openpyxl.chart._chart

openpyxl.chart.shapes SourceModule

imports: openpyxl.chart • openpyxl.descriptors • openpyxl.descriptors.nested • openpyxl.descriptors.serialisable • openpyxl.drawing.colors • openpyxl.drawing.fill • openpyxl.drawing.geometry • openpyxl.drawing.line

imported by: openpyxl.chart._3d • openpyxl.chart._chart • openpyxl.chart.axis • openpyxl.chart.bar_chart • openpyxl.chart.chartspace • openpyxl.chart.error_bar • openpyxl.chart.label • openpyxl.chart.legend • openpyxl.chart.marker • openpyxl.chart.pivot • openpyxl.chart.plotarea • openpyxl.chart.series • openpyxl.chart.surface_chart • openpyxl.chart.title • openpyxl.chart.trendline • openpyxl.chart.updown_bars • openpyxl.drawing.connector • openpyxl.drawing.picture

openpyxl.chart.stock_chart SourceModule

imports: openpyxl.chart • openpyxl.chart._chart • openpyxl.chart.axis • openpyxl.chart.label • openpyxl.chart.series • openpyxl.chart.updown_bars • openpyxl.descriptors • openpyxl.descriptors.excel • openpyxl.descriptors.serialisable

imported by: openpyxl.chart • openpyxl.chart.plotarea

openpyxl.chart.surface_chart SourceModule

imports: openpyxl.chart • openpyxl.chart._3d • openpyxl.chart._chart • openpyxl.chart.axis • openpyxl.chart.series • openpyxl.chart.shapes • openpyxl.descriptors • openpyxl.descriptors.excel • openpyxl.descriptors.nested • openpyxl.descriptors.serialisable

imported by: openpyxl.chart • openpyxl.chart.plotarea

openpyxl.chart.text SourceModule

imports: openpyxl.chart • openpyxl.chart.data_source • openpyxl.descriptors • openpyxl.descriptors.serialisable • openpyxl.drawing.text

imported by: openpyxl.chart.axis • openpyxl.chart.chartspace • openpyxl.chart.label • openpyxl.chart.legend • openpyxl.chart.marker • openpyxl.chart.pivot • openpyxl.chart.plotarea • openpyxl.chart.title • openpyxl.chart.trendline • openpyxl.drawing.connector

openpyxl.chart.title SourceModule

imports: openpyxl.chart • openpyxl.chart.layout • openpyxl.chart.shapes • openpyxl.chart.text • openpyxl.descriptors • openpyxl.descriptors.excel • openpyxl.descriptors.nested • openpyxl.descriptors.serialisable • openpyxl.drawing.text

imported by: openpyxl.chart._chart • openpyxl.chart.axis • openpyxl.chart.chartspace

openpyxl.chart.trendline SourceModule

imports: openpyxl.chart • openpyxl.chart.data_source • openpyxl.chart.layout • openpyxl.chart.shapes • openpyxl.chart.text • openpyxl.descriptors • openpyxl.descriptors.excel • openpyxl.descriptors.nested • openpyxl.descriptors.serialisable

imported by: openpyxl.chart.series

openpyxl.chart.updown_bars SourceModule

imports: openpyxl.chart • openpyxl.chart.axis • openpyxl.chart.descriptors • openpyxl.chart.shapes • openpyxl.descriptors • openpyxl.descriptors.excel • openpyxl.descriptors.serialisable

imported by: openpyxl.chart.line_chart • openpyxl.chart.stock_chart

openpyxl.chartsheet Package

imports: openpyxl • openpyxl.chartsheet.chartsheet

imported by: openpyxl.chartsheet.chartsheet • openpyxl.chartsheet.custom • openpyxl.chartsheet.properties • openpyxl.chartsheet.protection • openpyxl.chartsheet.publish • openpyxl.chartsheet.relation • openpyxl.chartsheet.views • openpyxl.reader.excel • openpyxl.workbook.workbook

openpyxl.chartsheet.chartsheet SourceModule

imports: openpyxl.chartsheet • openpyxl.chartsheet.custom • openpyxl.chartsheet.properties • openpyxl.chartsheet.protection • openpyxl.chartsheet.publish • openpyxl.chartsheet.relation • openpyxl.chartsheet.views • openpyxl.descriptors • openpyxl.descriptors.excel • openpyxl.descriptors.serialisable • openpyxl.drawing.spreadsheet_drawing • openpyxl.workbook.child • openpyxl.worksheet.drawing • openpyxl.worksheet.header_footer • openpyxl.worksheet.page • openpyxl.xml.constants

imported by: openpyxl.chartsheet

openpyxl.chartsheet.custom SourceModule

imports: openpyxl.chartsheet • openpyxl.descriptors • openpyxl.descriptors.excel • openpyxl.descriptors.serialisable • openpyxl.worksheet.header_footer • openpyxl.worksheet.page

imported by: openpyxl.chartsheet.chartsheet

openpyxl.chartsheet.properties SourceModule

imports: openpyxl.chartsheet • openpyxl.descriptors • openpyxl.descriptors.serialisable • openpyxl.styles

imported by: openpyxl.chartsheet.chartsheet

openpyxl.chartsheet.protection SourceModule

imports: hashlib • openpyxl.chartsheet • openpyxl.descriptors • openpyxl.descriptors.excel • openpyxl.descriptors.serialisable • openpyxl.worksheet.protection

imported by: openpyxl.chartsheet.chartsheet

openpyxl.chartsheet.publish SourceModule

imports: openpyxl.chartsheet • openpyxl.descriptors • openpyxl.descriptors.serialisable

imported by: openpyxl.chartsheet.chartsheet

openpyxl.chartsheet.relation SourceModule

imports: openpyxl.chartsheet • openpyxl.descriptors • openpyxl.descriptors.excel • openpyxl.descriptors.serialisable

imported by: openpyxl.chartsheet.chartsheet

openpyxl.chartsheet.views SourceModule

imports: openpyxl.chartsheet • openpyxl.descriptors • openpyxl.descriptors.excel • openpyxl.descriptors.serialisable

imported by: openpyxl.chartsheet.chartsheet

openpyxl.comments Package

imports: openpyxl • openpyxl.comments.comments

imported by: openpyxl.comments.author • openpyxl.comments.comment_sheet • openpyxl.comments.comments • openpyxl.comments.shape_writer

openpyxl.comments.author SourceModule

imports: openpyxl.comments • openpyxl.descriptors • openpyxl.descriptors.serialisable

imported by: openpyxl.comments.comment_sheet

openpyxl.comments.comment_sheet SourceModule

imports: openpyxl.cell.text • openpyxl.comments • openpyxl.comments.author • openpyxl.comments.comments • openpyxl.comments.shape_writer • openpyxl.descriptors • openpyxl.descriptors.excel • openpyxl.descriptors.sequence • openpyxl.descriptors.serialisable • openpyxl.utils.indexed_list • openpyxl.xml.constants

imported by: openpyxl.reader.excel • openpyxl.worksheet._writer • openpyxl.writer.excel

openpyxl.comments.comments SourceModule

imports: openpyxl.comments

imported by: openpyxl.comments • openpyxl.comments.comment_sheet

openpyxl.comments.shape_writer SourceModule

imports: openpyxl.comments • openpyxl.utils • openpyxl.xml.functions

imported by: openpyxl.comments.comment_sheet

openpyxl.compat Package

imports: functools • inspect • openpyxl • openpyxl.compat.numbers • openpyxl.compat.strings • warnings

imported by: openpyxl.cell._writer • openpyxl.cell.cell • openpyxl.cell.rich_text • openpyxl.compat.numbers • openpyxl.compat.strings • openpyxl.descriptors.excel • openpyxl.descriptors.nested • openpyxl.descriptors.sequence • openpyxl.descriptors.serialisable • openpyxl.styles.alignment • openpyxl.styles.borders • openpyxl.styles.colors • openpyxl.styles.fills • openpyxl.styles.fonts • openpyxl.styles.named_styles • openpyxl.styles.proxy • openpyxl.workbook.defined_name • openpyxl.workbook.workbook • openpyxl.worksheet.dimensions • openpyxl.worksheet.formula • openpyxl.worksheet.worksheet

openpyxl.compat.numbers SourceModule

imports: decimal • numpy • openpyxl.compat

imported by: openpyxl • openpyxl.compat • openpyxl.compat.strings

openpyxl.compat.strings SourceModule

imports: datetime • math • openpyxl.compat • openpyxl.compat.numbers • sys

imported by: openpyxl.compat

openpyxl.descriptors Package

imports: openpyxl • openpyxl.descriptors • openpyxl.descriptors.base • openpyxl.descriptors.sequence

imported by: openpyxl.cell.rich_text • openpyxl.cell.text • openpyxl.chart._3d • openpyxl.chart._chart • openpyxl.chart.area_chart • openpyxl.chart.axis • openpyxl.chart.bar_chart • openpyxl.chart.bubble_chart • openpyxl.chart.chartspace • openpyxl.chart.data_source • openpyxl.chart.descriptors • openpyxl.chart.error_bar • openpyxl.chart.label • openpyxl.chart.layout • openpyxl.chart.legend • openpyxl.chart.line_chart • openpyxl.chart.marker • openpyxl.chart.pie_chart • openpyxl.chart.pivot • openpyxl.chart.plotarea • openpyxl.chart.print_settings • openpyxl.chart.radar_chart • openpyxl.chart.reference • openpyxl.chart.scatter_chart • openpyxl.chart.series • openpyxl.chart.shapes • openpyxl.chart.stock_chart • openpyxl.chart.surface_chart • openpyxl.chart.text • openpyxl.chart.title • openpyxl.chart.trendline • openpyxl.chart.updown_bars • openpyxl.chartsheet.chartsheet • openpyxl.chartsheet.custom • openpyxl.chartsheet.properties • openpyxl.chartsheet.protection • openpyxl.chartsheet.publish • openpyxl.chartsheet.relation • openpyxl.chartsheet.views • openpyxl.comments.author • openpyxl.comments.comment_sheet • openpyxl.descriptors • openpyxl.descriptors.base • openpyxl.descriptors.container • openpyxl.descriptors.excel • openpyxl.descriptors.namespace • openpyxl.descriptors.nested • openpyxl.descriptors.sequence • openpyxl.descriptors.serialisable • openpyxl.drawing.colors • openpyxl.drawing.connector • openpyxl.drawing.effect • openpyxl.drawing.fill • openpyxl.drawing.geometry • openpyxl.drawing.graphic • openpyxl.drawing.line • openpyxl.drawing.picture • openpyxl.drawing.properties • openpyxl.drawing.spreadsheet_drawing • openpyxl.drawing.text • openpyxl.formatting.formatting • openpyxl.formatting.rule • openpyxl.packaging.core • openpyxl.packaging.custom • openpyxl.packaging.extended • openpyxl.packaging.manifest • openpyxl.packaging.relationship • openpyxl.packaging.workbook • openpyxl.pivot.cache • openpyxl.pivot.fields • openpyxl.pivot.record • openpyxl.pivot.table • openpyxl.styles.alignment • openpyxl.styles.borders • openpyxl.styles.cell_style • openpyxl.styles.colors • openpyxl.styles.differential • openpyxl.styles.fills • openpyxl.styles.fonts • openpyxl.styles.named_styles • openpyxl.styles.numbers • openpyxl.styles.protection • openpyxl.styles.stylesheet • openpyxl.styles.table • openpyxl.workbook.defined_name • openpyxl.workbook.external_link.external • openpyxl.workbook.external_reference • openpyxl.workbook.function_group • openpyxl.workbook.properties • openpyxl.workbook.protection • openpyxl.workbook.smart_tags • openpyxl.workbook.views • openpyxl.workbook.web • openpyxl.worksheet.cell_range • openpyxl.worksheet.datavalidation • openpyxl.worksheet.dimensions • openpyxl.worksheet.filters • openpyxl.worksheet.header_footer • openpyxl.worksheet.hyperlink • openpyxl.worksheet.merge • openpyxl.worksheet.page • openpyxl.worksheet.pagebreak • openpyxl.worksheet.print_settings • openpyxl.worksheet.properties • openpyxl.worksheet.protection • openpyxl.worksheet.scenario • openpyxl.worksheet.table • openpyxl.worksheet.views

openpyxl.descriptors.base SourceModule

imports: datetime • openpyxl • openpyxl.descriptors • openpyxl.descriptors.namespace • openpyxl.utils.datetime • re

imported by: openpyxl.descriptors • openpyxl.descriptors.nested • openpyxl.descriptors.sequence

openpyxl.descriptors.container SourceModule

imports: openpyxl.descriptors • openpyxl.xml.functions

imported by: openpyxl.packaging.relationship

openpyxl.descriptors.excel SourceModule

imports: openpyxl.compat • openpyxl.descriptors • openpyxl.descriptors.serialisable • openpyxl.xml.constants • openpyxl.xml.functions

imported by: openpyxl.chart._3d • openpyxl.chart.area_chart • openpyxl.chart.axis • openpyxl.chart.bar_chart • openpyxl.chart.bubble_chart • openpyxl.chart.chartspace • openpyxl.chart.data_source • openpyxl.chart.error_bar • openpyxl.chart.label • openpyxl.chart.layout • openpyxl.chart.legend • openpyxl.chart.line_chart • openpyxl.chart.marker • openpyxl.chart.pie_chart • openpyxl.chart.pivot • openpyxl.chart.plotarea • openpyxl.chart.radar_chart • openpyxl.chart.scatter_chart • openpyxl.chart.series • openpyxl.chart.stock_chart • openpyxl.chart.surface_chart • openpyxl.chart.title • openpyxl.chart.trendline • openpyxl.chart.updown_bars • openpyxl.chartsheet.chartsheet • openpyxl.chartsheet.custom • openpyxl.chartsheet.protection • openpyxl.chartsheet.relation • openpyxl.chartsheet.views • openpyxl.comments.comment_sheet • openpyxl.drawing.colors • openpyxl.drawing.connector • openpyxl.drawing.fill • openpyxl.drawing.geometry • openpyxl.drawing.graphic • openpyxl.drawing.line • openpyxl.drawing.picture • openpyxl.drawing.properties • openpyxl.drawing.relation • openpyxl.drawing.spreadsheet_drawing • openpyxl.drawing.text • openpyxl.formatting.rule • openpyxl.packaging.workbook • openpyxl.pivot.cache • openpyxl.pivot.fields • openpyxl.pivot.record • openpyxl.pivot.table • openpyxl.styles.cell_style • openpyxl.styles.named_styles • openpyxl.styles.stylesheet • openpyxl.workbook.external_link.external • openpyxl.workbook.external_reference • openpyxl.workbook.properties • openpyxl.workbook.protection • openpyxl.workbook.views • openpyxl.worksheet._reader • openpyxl.worksheet.drawing • openpyxl.worksheet.filters • openpyxl.worksheet.hyperlink • openpyxl.worksheet.page • openpyxl.worksheet.protection • openpyxl.worksheet.related • openpyxl.worksheet.table • openpyxl.worksheet.views

openpyxl.descriptors.namespace SourceModule

imports: openpyxl.descriptors

imported by: openpyxl.descriptors.base • openpyxl.descriptors.sequence • openpyxl.descriptors.serialisable

openpyxl.descriptors.nested SourceModule

imports: openpyxl.compat • openpyxl.descriptors • openpyxl.descriptors.base • openpyxl.xml.functions

imported by: openpyxl.cell.text • openpyxl.chart._3d • openpyxl.chart.area_chart • openpyxl.chart.axis • openpyxl.chart.bar_chart • openpyxl.chart.bubble_chart • openpyxl.chart.chartspace • openpyxl.chart.data_source • openpyxl.chart.descriptors • openpyxl.chart.error_bar • openpyxl.chart.label • openpyxl.chart.layout • openpyxl.chart.legend • openpyxl.chart.line_chart • openpyxl.chart.marker • openpyxl.chart.picture • openpyxl.chart.pie_chart • openpyxl.chart.pivot • openpyxl.chart.plotarea • openpyxl.chart.radar_chart • openpyxl.chart.scatter_chart • openpyxl.chart.series • openpyxl.chart.shapes • openpyxl.chart.surface_chart • openpyxl.chart.title • openpyxl.chart.trendline • openpyxl.drawing.colors • openpyxl.drawing.fill • openpyxl.drawing.line • openpyxl.drawing.spreadsheet_drawing • openpyxl.drawing.text • openpyxl.packaging.core • openpyxl.packaging.custom • openpyxl.packaging.extended • openpyxl.packaging.workbook • openpyxl.pivot.cache • openpyxl.pivot.record • openpyxl.styles.fonts • openpyxl.workbook.external_link.external • openpyxl.worksheet.datavalidation

openpyxl.descriptors.sequence SourceModule

imports: openpyxl.compat • openpyxl.descriptors • openpyxl.descriptors.base • openpyxl.descriptors.namespace • openpyxl.utils.indexed_list • openpyxl.xml.functions

imported by: openpyxl.chart._chart • openpyxl.chart.chartspace • openpyxl.chart.pie_chart • openpyxl.chart.plotarea • openpyxl.comments.comment_sheet • openpyxl.descriptors • openpyxl.descriptors.serialisable • openpyxl.drawing.fill • openpyxl.packaging.custom • openpyxl.packaging.workbook • openpyxl.pivot.cache • openpyxl.pivot.record • openpyxl.pivot.table • openpyxl.styles.colors • openpyxl.styles.stylesheet • openpyxl.workbook.external_link.external • openpyxl.worksheet.cell_range • openpyxl.worksheet.filters • openpyxl.worksheet.table

openpyxl.descriptors.serialisable SourceModule

imports: copy • keyword • openpyxl.compat • openpyxl.descriptors • openpyxl.descriptors.namespace • openpyxl.descriptors.sequence • openpyxl.xml.functions

imported by: openpyxl.cell.text • openpyxl.chart._3d • openpyxl.chart._chart • openpyxl.chart.area_chart • openpyxl.chart.axis • openpyxl.chart.bar_chart • openpyxl.chart.bubble_chart • openpyxl.chart.chartspace • openpyxl.chart.data_source • openpyxl.chart.error_bar • openpyxl.chart.label • openpyxl.chart.layout • openpyxl.chart.legend • openpyxl.chart.marker • openpyxl.chart.picture • openpyxl.chart.pie_chart • openpyxl.chart.pivot • openpyxl.chart.plotarea • openpyxl.chart.print_settings • openpyxl.chart.radar_chart • openpyxl.chart.reference • openpyxl.chart.scatter_chart • openpyxl.chart.series • openpyxl.chart.shapes • openpyxl.chart.stock_chart • openpyxl.chart.surface_chart • openpyxl.chart.text • openpyxl.chart.title • openpyxl.chart.trendline • openpyxl.chart.updown_bars • openpyxl.chartsheet.chartsheet • openpyxl.chartsheet.custom • openpyxl.chartsheet.properties • openpyxl.chartsheet.protection • openpyxl.chartsheet.publish • openpyxl.chartsheet.relation • openpyxl.chartsheet.views • openpyxl.comments.author • openpyxl.comments.comment_sheet • openpyxl.descriptors.excel • openpyxl.drawing.colors • openpyxl.drawing.connector • openpyxl.drawing.effect • openpyxl.drawing.fill • openpyxl.drawing.geometry • openpyxl.drawing.graphic • openpyxl.drawing.line • openpyxl.drawing.picture • openpyxl.drawing.properties • openpyxl.drawing.relation • openpyxl.drawing.spreadsheet_drawing • openpyxl.drawing.text • openpyxl.formatting.formatting • openpyxl.formatting.rule • openpyxl.packaging.core • openpyxl.packaging.custom • openpyxl.packaging.extended • openpyxl.packaging.manifest • openpyxl.packaging.relationship • openpyxl.packaging.workbook • openpyxl.pivot.cache • openpyxl.pivot.fields • openpyxl.pivot.record • openpyxl.pivot.table • openpyxl.styles.alignment • openpyxl.styles.borders • openpyxl.styles.cell_style • openpyxl.styles.colors • openpyxl.styles.differential • openpyxl.styles.fills • openpyxl.styles.fonts • openpyxl.styles.named_styles • openpyxl.styles.numbers • openpyxl.styles.protection • openpyxl.styles.stylesheet • openpyxl.styles.table • openpyxl.workbook.defined_name • openpyxl.workbook.external_link.external • openpyxl.workbook.external_reference • openpyxl.workbook.function_group • openpyxl.workbook.properties • openpyxl.workbook.protection • openpyxl.workbook.smart_tags • openpyxl.workbook.views • openpyxl.workbook.web • openpyxl.worksheet.cell_range • openpyxl.worksheet.datavalidation • openpyxl.worksheet.dimensions • openpyxl.worksheet.drawing • openpyxl.worksheet.filters • openpyxl.worksheet.header_footer • openpyxl.worksheet.hyperlink • openpyxl.worksheet.merge • openpyxl.worksheet.page • openpyxl.worksheet.pagebreak • openpyxl.worksheet.properties • openpyxl.worksheet.protection • openpyxl.worksheet.related • openpyxl.worksheet.scenario • openpyxl.worksheet.table • openpyxl.worksheet.views

openpyxl.drawing Package

imports: openpyxl • openpyxl.drawing.drawing

imported by: openpyxl.drawing.colors • openpyxl.drawing.connector • openpyxl.drawing.drawing • openpyxl.drawing.effect • openpyxl.drawing.fill • openpyxl.drawing.geometry • openpyxl.drawing.graphic • openpyxl.drawing.image • openpyxl.drawing.line • openpyxl.drawing.picture • openpyxl.drawing.properties • openpyxl.drawing.relation • openpyxl.drawing.spreadsheet_drawing • openpyxl.drawing.text • openpyxl.drawing.xdr

openpyxl.drawing.colors SourceModule

imports: openpyxl.descriptors • openpyxl.descriptors.excel • openpyxl.descriptors.nested • openpyxl.descriptors.serialisable • openpyxl.drawing • openpyxl.styles.colors • openpyxl.xml.constants

imported by: openpyxl.chart.chartspace • openpyxl.chart.shapes • openpyxl.drawing.effect • openpyxl.drawing.fill • openpyxl.drawing.line • openpyxl.drawing.text

openpyxl.drawing.connector SourceModule

imports: openpyxl.chart.shapes • openpyxl.chart.text • openpyxl.descriptors • openpyxl.descriptors.excel • openpyxl.descriptors.serialisable • openpyxl.drawing • openpyxl.drawing.geometry • openpyxl.drawing.properties

imported by: openpyxl.drawing.spreadsheet_drawing

openpyxl.drawing.drawing SourceModule

imports: math • openpyxl.drawing • openpyxl.drawing.spreadsheet_drawing • openpyxl.utils.units

imported by: openpyxl.drawing

openpyxl.drawing.effect SourceModule

imports: openpyxl.descriptors • openpyxl.descriptors.serialisable • openpyxl.drawing • openpyxl.drawing.colors

imported by: openpyxl.drawing.fill • openpyxl.drawing.graphic • openpyxl.drawing.text

openpyxl.drawing.fill SourceModule

imports: openpyxl.descriptors • openpyxl.descriptors.excel • openpyxl.descriptors.nested • openpyxl.descriptors.sequence • openpyxl.descriptors.serialisable • openpyxl.drawing • openpyxl.drawing.colors • openpyxl.drawing.effect • openpyxl.xml.constants

imported by: openpyxl.chart.shapes • openpyxl.drawing.graphic • openpyxl.drawing.line • openpyxl.drawing.picture • openpyxl.drawing.spreadsheet_drawing • openpyxl.drawing.text

openpyxl.drawing.geometry SourceModule

imports: openpyxl.descriptors • openpyxl.descriptors.excel • openpyxl.descriptors.serialisable • openpyxl.drawing • openpyxl.drawing.line • openpyxl.styles.colors • openpyxl.xml.constants

imported by: openpyxl.chart.shapes • openpyxl.drawing.connector • openpyxl.drawing.picture • openpyxl.drawing.properties • openpyxl.drawing.spreadsheet_drawing • openpyxl.drawing.text • openpyxl.drawing.xdr

openpyxl.drawing.graphic SourceModule

imports: openpyxl.descriptors • openpyxl.descriptors.excel • openpyxl.descriptors.serialisable • openpyxl.drawing • openpyxl.drawing.effect • openpyxl.drawing.fill • openpyxl.drawing.picture • openpyxl.drawing.properties • openpyxl.drawing.relation • openpyxl.drawing.xdr • openpyxl.xml.constants

imported by: openpyxl.drawing.spreadsheet_drawing

openpyxl.drawing.image SourceModule

imports: PIL • io • openpyxl.drawing

imported by: openpyxl.drawing.spreadsheet_drawing • openpyxl.reader.drawings

openpyxl.drawing.line SourceModule

imports: openpyxl.descriptors • openpyxl.descriptors.excel • openpyxl.descriptors.nested • openpyxl.descriptors.serialisable • openpyxl.drawing • openpyxl.drawing.colors • openpyxl.drawing.fill • openpyxl.xml.constants

imported by: openpyxl.chart.shapes • openpyxl.drawing.geometry

openpyxl.drawing.picture SourceModule

imports: openpyxl.chart.shapes • openpyxl.descriptors • openpyxl.descriptors.excel • openpyxl.descriptors.serialisable • openpyxl.drawing • openpyxl.drawing.fill • openpyxl.drawing.geometry • openpyxl.drawing.properties • openpyxl.xml.constants

imported by: openpyxl.drawing.graphic • openpyxl.drawing.spreadsheet_drawing

openpyxl.drawing.properties SourceModule

imports: openpyxl.descriptors • openpyxl.descriptors.excel • openpyxl.descriptors.serialisable • openpyxl.drawing • openpyxl.drawing.geometry • openpyxl.drawing.text • openpyxl.xml.constants

imported by: openpyxl.drawing.connector • openpyxl.drawing.graphic • openpyxl.drawing.picture

openpyxl.drawing.relation SourceModule

imports: openpyxl.descriptors.excel • openpyxl.descriptors.serialisable • openpyxl.drawing • openpyxl.xml.constants

imported by: openpyxl.drawing.graphic • openpyxl.drawing.spreadsheet_drawing

openpyxl.drawing.spreadsheet_drawing SourceModule

imports: openpyxl.chart._chart • openpyxl.descriptors • openpyxl.descriptors.excel • openpyxl.descriptors.nested • openpyxl.descriptors.serialisable • openpyxl.drawing • openpyxl.drawing.connector • openpyxl.drawing.fill • openpyxl.drawing.geometry • openpyxl.drawing.graphic • openpyxl.drawing.image • openpyxl.drawing.picture • openpyxl.drawing.relation • openpyxl.drawing.xdr • openpyxl.packaging.relationship • openpyxl.utils • openpyxl.utils.units • openpyxl.xml.constants

imported by: openpyxl.chartsheet.chartsheet • openpyxl.drawing.drawing • openpyxl.reader.drawings • openpyxl.reader.excel • openpyxl.writer.excel

openpyxl.drawing.text SourceModule

imports: openpyxl.descriptors • openpyxl.descriptors.excel • openpyxl.descriptors.nested • openpyxl.descriptors.serialisable • openpyxl.drawing • openpyxl.drawing.colors • openpyxl.drawing.effect • openpyxl.drawing.fill • openpyxl.drawing.geometry • openpyxl.xml.constants

imported by: openpyxl.chart.text • openpyxl.chart.title • openpyxl.drawing.properties

openpyxl.drawing.xdr SourceModule

imports: openpyxl.drawing • openpyxl.drawing.geometry

imported by: openpyxl.drawing.graphic • openpyxl.drawing.spreadsheet_drawing

openpyxl.formatting Package

imports: openpyxl • openpyxl.formatting.rule

imported by: openpyxl.formatting.formatting • openpyxl.formatting.rule

openpyxl.formatting.formatting SourceModule

imports: collections • openpyxl.descriptors • openpyxl.descriptors.serialisable • openpyxl.formatting • openpyxl.formatting.rule • openpyxl.worksheet.cell_range

imported by: openpyxl.worksheet._reader • openpyxl.worksheet.worksheet

openpyxl.formatting.rule SourceModule

imports: openpyxl.descriptors • openpyxl.descriptors.excel • openpyxl.descriptors.serialisable • openpyxl.formatting • openpyxl.styles.colors • openpyxl.styles.differential • openpyxl.utils.cell

imported by: openpyxl.formatting • openpyxl.formatting.formatting

openpyxl.formula Package

imports: openpyxl • openpyxl.formula.tokenizer

imported by: openpyxl.formula.tokenizer • openpyxl.formula.translate • openpyxl.utils.formulas • openpyxl.workbook.defined_name

openpyxl.formula.tokenizer SourceModule

imports: openpyxl.formula • re

imported by: openpyxl.formula • openpyxl.formula.translate

openpyxl.formula.translate SourceModule

imports: openpyxl.formula • openpyxl.formula.tokenizer • openpyxl.utils • re

imported by: openpyxl.worksheet._reader • openpyxl.worksheet.worksheet

openpyxl.packaging Package

imports: openpyxl

imported by: openpyxl.packaging.core • openpyxl.packaging.custom • openpyxl.packaging.extended • openpyxl.packaging.manifest • openpyxl.packaging.relationship • openpyxl.packaging.workbook

openpyxl.packaging.core SourceModule

imports: datetime • openpyxl.descriptors • openpyxl.descriptors.nested • openpyxl.descriptors.serialisable • openpyxl.packaging • openpyxl.xml.constants • openpyxl.xml.functions

imported by: openpyxl.packaging.custom • openpyxl.reader.excel • openpyxl.workbook.workbook

openpyxl.packaging.custom SourceModule

imports: openpyxl.descriptors • openpyxl.descriptors.nested • openpyxl.descriptors.sequence • openpyxl.descriptors.serialisable • openpyxl.packaging • openpyxl.packaging.core • openpyxl.xml.constants • warnings

imported by: openpyxl.reader.excel • openpyxl.workbook.workbook

openpyxl.packaging.extended SourceModule

imports: openpyxl • openpyxl.descriptors • openpyxl.descriptors.nested • openpyxl.descriptors.serialisable • openpyxl.packaging • openpyxl.xml.constants

imported by: openpyxl.writer.excel

openpyxl.packaging.manifest SourceModule

imports: mimetypes • openpyxl.descriptors • openpyxl.descriptors.serialisable • openpyxl.packaging • openpyxl.xml.constants • openpyxl.xml.functions • os.path

imported by: openpyxl.reader.excel • openpyxl.writer.excel

openpyxl.packaging.relationship SourceModule

imports: openpyxl.descriptors • openpyxl.descriptors.container • openpyxl.descriptors.serialisable • openpyxl.packaging • openpyxl.xml.constants • openpyxl.xml.functions • posixpath • warnings

imported by: openpyxl.drawing.spreadsheet_drawing • openpyxl.pivot.cache • openpyxl.pivot.table • openpyxl.reader.drawings • openpyxl.reader.excel • openpyxl.reader.workbook • openpyxl.workbook._writer • openpyxl.workbook.external_link.external • openpyxl.workbook.workbook • openpyxl.worksheet._writer • openpyxl.worksheet.worksheet • openpyxl.writer.excel

openpyxl.packaging.workbook SourceModule

imports: openpyxl.descriptors • openpyxl.descriptors.excel • openpyxl.descriptors.nested • openpyxl.descriptors.sequence • openpyxl.descriptors.serialisable • openpyxl.packaging • openpyxl.workbook.defined_name • openpyxl.workbook.external_reference • openpyxl.workbook.function_group • openpyxl.workbook.properties • openpyxl.workbook.protection • openpyxl.workbook.smart_tags • openpyxl.workbook.views • openpyxl.workbook.web • openpyxl.xml.constants

imported by: openpyxl.reader.workbook • openpyxl.workbook._writer

openpyxl.pivot Package

imports: openpyxl

imported by: openpyxl.pivot.cache • openpyxl.pivot.fields • openpyxl.pivot.record • openpyxl.pivot.table

openpyxl.pivot.cache SourceModule

imports: openpyxl.descriptors • openpyxl.descriptors.excel • openpyxl.descriptors.nested • openpyxl.descriptors.sequence • openpyxl.descriptors.serialisable • openpyxl.packaging.relationship • openpyxl.pivot • openpyxl.pivot.fields • openpyxl.pivot.table • openpyxl.xml.constants • openpyxl.xml.functions

imported by: openpyxl.reader.workbook

openpyxl.pivot.fields SourceModule

imports: openpyxl.descriptors • openpyxl.descriptors.excel • openpyxl.descriptors.serialisable • openpyxl.pivot

imported by: openpyxl.pivot.cache • openpyxl.pivot.record • openpyxl.pivot.table

openpyxl.pivot.record SourceModule

imports: openpyxl.descriptors • openpyxl.descriptors.excel • openpyxl.descriptors.nested • openpyxl.descriptors.sequence • openpyxl.descriptors.serialisable • openpyxl.pivot • openpyxl.pivot.fields • openpyxl.xml.constants • openpyxl.xml.functions

imported by: openpyxl.reader.workbook

openpyxl.pivot.table SourceModule

imports: collections • openpyxl.descriptors • openpyxl.descriptors.excel • openpyxl.descriptors.sequence • openpyxl.descriptors.serialisable • openpyxl.packaging.relationship • openpyxl.pivot • openpyxl.pivot.fields • openpyxl.worksheet.filters • openpyxl.xml.constants • openpyxl.xml.functions

imported by: openpyxl.pivot.cache • openpyxl.reader.excel

openpyxl.reader Package

imports: openpyxl

imported by: openpyxl.reader.drawings • openpyxl.reader.excel • openpyxl.reader.strings • openpyxl.reader.workbook

openpyxl.reader.drawings SourceModule

imports: io • openpyxl.chart.chartspace • openpyxl.chart.reader • openpyxl.drawing.image • openpyxl.drawing.spreadsheet_drawing • openpyxl.packaging.relationship • openpyxl.reader • openpyxl.xml.constants • openpyxl.xml.functions • warnings

imported by: openpyxl.reader.excel

openpyxl.reader.excel SourceModule

imports: io • openpyxl.cell • openpyxl.chartsheet • openpyxl.comments.comment_sheet • openpyxl.drawing.spreadsheet_drawing • openpyxl.packaging.core • openpyxl.packaging.custom • openpyxl.packaging.manifest • openpyxl.packaging.relationship • openpyxl.pivot.table • openpyxl.reader • openpyxl.reader.drawings • openpyxl.reader.strings • openpyxl.reader.workbook • openpyxl.styles.stylesheet • openpyxl.tests • openpyxl.utils.exceptions • openpyxl.worksheet._read_only • openpyxl.worksheet._reader • openpyxl.worksheet.table • openpyxl.xml.constants • openpyxl.xml.functions • os.path • warnings • zipfile

imported by: openpyxl

openpyxl.reader.strings SourceModule

imports: openpyxl.cell.rich_text • openpyxl.cell.text • openpyxl.reader • openpyxl.xml.constants • openpyxl.xml.functions

imported by: openpyxl.reader.excel

openpyxl.reader.workbook SourceModule

imports: openpyxl.packaging.relationship • openpyxl.packaging.workbook • openpyxl.pivot.cache • openpyxl.pivot.record • openpyxl.reader • openpyxl.utils.datetime • openpyxl.workbook • openpyxl.workbook.defined_name • openpyxl.workbook.external_link.external • openpyxl.worksheet.print_settings • openpyxl.xml.functions • warnings

imported by: openpyxl.reader.excel

openpyxl.styles Package

imports: openpyxl • openpyxl.styles.alignment • openpyxl.styles.borders • openpyxl.styles.colors • openpyxl.styles.fills • openpyxl.styles.fonts • openpyxl.styles.named_styles • openpyxl.styles.numbers • openpyxl.styles.protection

imported by: ads7953_diagnostic_gui.py • openpyxl.cell.cell • openpyxl.cell.read_only • openpyxl.chartsheet.properties • openpyxl.styles.alignment • openpyxl.styles.borders • openpyxl.styles.builtins • openpyxl.styles.cell_style • openpyxl.styles.colors • openpyxl.styles.differential • openpyxl.styles.fills • openpyxl.styles.fonts • openpyxl.styles.named_styles • openpyxl.styles.numbers • openpyxl.styles.protection • openpyxl.styles.proxy • openpyxl.styles.styleable • openpyxl.styles.stylesheet • openpyxl.styles.table

openpyxl.styles.alignment SourceModule

imports: openpyxl.compat • openpyxl.descriptors • openpyxl.descriptors.serialisable • openpyxl.styles

imported by: openpyxl.styles • openpyxl.styles.cell_style • openpyxl.styles.named_styles • openpyxl.workbook.workbook

openpyxl.styles.borders SourceModule

imports: openpyxl.compat • openpyxl.descriptors • openpyxl.descriptors.serialisable • openpyxl.styles • openpyxl.styles.colors

imported by: openpyxl.styles • openpyxl.styles.named_styles • openpyxl.styles.stylesheet • openpyxl.workbook.workbook • openpyxl.worksheet.merge

openpyxl.styles.builtins SourceModule

imports: openpyxl.styles • openpyxl.styles.named_styles • openpyxl.xml.functions

imported by: openpyxl.styles.styleable • openpyxl.styles.stylesheet

openpyxl.styles.cell_style SourceModule

imports: array • openpyxl.descriptors • openpyxl.descriptors.excel • openpyxl.descriptors.serialisable • openpyxl.styles • openpyxl.styles.alignment • openpyxl.styles.protection • openpyxl.utils.indexed_list

imported by: openpyxl.styles.named_styles • openpyxl.styles.styleable • openpyxl.styles.stylesheet • openpyxl.workbook.workbook

openpyxl.styles.colors SourceModule

imports: openpyxl.compat • openpyxl.descriptors • openpyxl.descriptors.sequence • openpyxl.descriptors.serialisable • openpyxl.styles • re

imported by: openpyxl.drawing.colors • openpyxl.drawing.geometry • openpyxl.formatting.rule • openpyxl.styles • openpyxl.styles.borders • openpyxl.styles.fills • openpyxl.styles.fonts • openpyxl.styles.stylesheet • openpyxl.styles.table • openpyxl.workbook.workbook • openpyxl.worksheet.properties

openpyxl.styles.differential SourceModule

imports: openpyxl.descriptors • openpyxl.descriptors.serialisable • openpyxl.styles • openpyxl.styles.numbers

imported by: openpyxl.formatting.rule • openpyxl.styles.stylesheet • openpyxl.workbook.workbook • openpyxl.worksheet._writer

openpyxl.styles.fills SourceModule

imports: openpyxl.compat • openpyxl.descriptors • openpyxl.descriptors.serialisable • openpyxl.styles • openpyxl.styles.colors • openpyxl.xml.constants • openpyxl.xml.functions

imported by: openpyxl.styles • openpyxl.styles.named_styles • openpyxl.styles.stylesheet • openpyxl.workbook.workbook

openpyxl.styles.fonts SourceModule

imports: openpyxl.compat • openpyxl.descriptors • openpyxl.descriptors.nested • openpyxl.descriptors.serialisable • openpyxl.styles • openpyxl.styles.colors • openpyxl.xml.constants • openpyxl.xml.functions

imported by: openpyxl.cell.text • openpyxl.styles • openpyxl.styles.named_styles • openpyxl.styles.stylesheet • openpyxl.workbook.workbook

openpyxl.styles.named_styles SourceModule

imports: openpyxl.compat • openpyxl.descriptors • openpyxl.descriptors.excel • openpyxl.descriptors.serialisable • openpyxl.styles • openpyxl.styles.alignment • openpyxl.styles.borders • openpyxl.styles.cell_style • openpyxl.styles.fills • openpyxl.styles.fonts • openpyxl.styles.numbers • openpyxl.styles.protection

imported by: openpyxl.styles • openpyxl.styles.builtins • openpyxl.styles.styleable • openpyxl.styles.stylesheet • openpyxl.workbook.workbook

openpyxl.styles.numbers SourceModule

imports: openpyxl.descriptors • openpyxl.descriptors.serialisable • openpyxl.styles • re

imported by: openpyxl.cell.cell • openpyxl.cell.read_only • openpyxl.styles • openpyxl.styles.differential • openpyxl.styles.named_styles • openpyxl.styles.styleable • openpyxl.styles.stylesheet

openpyxl.styles.protection SourceModule

imports: openpyxl.descriptors • openpyxl.descriptors.serialisable • openpyxl.styles

imported by: openpyxl.styles • openpyxl.styles.cell_style • openpyxl.styles.named_styles • openpyxl.workbook.workbook

openpyxl.styles.proxy SourceModule

imports: copy • openpyxl.compat • openpyxl.styles

imported by: openpyxl.styles.styleable

openpyxl.styles.styleable SourceModule

imports: copy • openpyxl.styles • openpyxl.styles.builtins • openpyxl.styles.cell_style • openpyxl.styles.named_styles • openpyxl.styles.numbers • openpyxl.styles.proxy

imported by: openpyxl.cell.cell • openpyxl.worksheet.dimensions

openpyxl.styles.stylesheet SourceModule

imports: openpyxl.descriptors • openpyxl.descriptors.excel • openpyxl.descriptors.sequence • openpyxl.descriptors.serialisable • openpyxl.styles • openpyxl.styles.borders • openpyxl.styles.builtins • openpyxl.styles.cell_style • openpyxl.styles.colors • openpyxl.styles.differential • openpyxl.styles.fills • openpyxl.styles.fonts • openpyxl.styles.named_styles • openpyxl.styles.numbers • openpyxl.styles.table • openpyxl.utils.indexed_list • openpyxl.xml.constants • openpyxl.xml.functions • warnings

imported by: openpyxl.reader.excel • openpyxl.writer.excel

openpyxl.styles.table SourceModule

imports: openpyxl.descriptors • openpyxl.descriptors.serialisable • openpyxl.styles • openpyxl.styles.colors

imported by: openpyxl.styles.stylesheet • openpyxl.workbook.workbook

openpyxl.tests MissingModule

imported by: openpyxl.reader.excel

openpyxl.utils Package

imports: openpyxl • openpyxl.utils.cell • openpyxl.utils.formulas

imported by: openpyxl.cell.cell • openpyxl.cell.read_only • openpyxl.chart.reference • openpyxl.chart.series_factory • openpyxl.comments.shape_writer • openpyxl.drawing.spreadsheet_drawing • openpyxl.formula.translate • openpyxl.utils.bound_dictionary • openpyxl.utils.cell • openpyxl.utils.datetime • openpyxl.utils.escape • openpyxl.utils.exceptions • openpyxl.utils.formulas • openpyxl.utils.indexed_list • openpyxl.utils.protection • openpyxl.utils.units • openpyxl.workbook._writer • openpyxl.workbook.workbook • openpyxl.worksheet._read_only • openpyxl.worksheet._reader • openpyxl.worksheet.cell_range • openpyxl.worksheet.datavalidation • openpyxl.worksheet.dimensions • openpyxl.worksheet.filters • openpyxl.worksheet.print_settings • openpyxl.worksheet.table • openpyxl.worksheet.worksheet

openpyxl.utils.bound_dictionary SourceModule

imports: collections • openpyxl.utils

imported by: openpyxl.worksheet.dimensions

openpyxl.utils.cell D:\anaconda3\Lib\site-packages\openpyxl\utils\cell.cp313-win_amd64.pyd

imports: functools • itertools • openpyxl.utils • openpyxl.utils.exceptions • re • string

imported by: openpyxl.formatting.rule • openpyxl.utils • openpyxl.workbook.defined_name • openpyxl.worksheet.print_settings

openpyxl.utils.datetime SourceModule

imports: datetime • math • openpyxl.utils • re

imported by: openpyxl.cell._writer • openpyxl.cell.read_only • openpyxl.descriptors.base • openpyxl.reader.workbook • openpyxl.workbook._writer • openpyxl.workbook.workbook • openpyxl.worksheet._reader

openpyxl.utils.escape SourceModule

imports: openpyxl.utils • re

imported by: openpyxl.worksheet.header_footer • openpyxl.worksheet.table

openpyxl.utils.exceptions SourceModule

imports: openpyxl.utils

imported by: openpyxl.cell.cell • openpyxl.reader.excel • openpyxl.utils.cell • openpyxl.workbook.workbook • openpyxl.worksheet._write_only • openpyxl.writer.excel

openpyxl.utils.formulas SourceModule

imports: openpyxl.formula • openpyxl.utils

imported by: openpyxl.utils

openpyxl.utils.indexed_list SourceModule

imports: openpyxl.utils

imported by: openpyxl.comments.comment_sheet • openpyxl.descriptors.sequence • openpyxl.styles.cell_style • openpyxl.styles.stylesheet • openpyxl.workbook.workbook

openpyxl.utils.protection SourceModule

imports: openpyxl.utils

imported by: openpyxl.workbook.protection • openpyxl.worksheet.protection

openpyxl.utils.units SourceModule

imports: math • openpyxl.utils

imported by: openpyxl.drawing.drawing • openpyxl.drawing.spreadsheet_drawing • openpyxl.worksheet.dimensions

openpyxl.workbook Package

imports: openpyxl • openpyxl.workbook.workbook

imported by: openpyxl • openpyxl.reader.workbook • openpyxl.workbook._writer • openpyxl.workbook.child • openpyxl.workbook.defined_name • openpyxl.workbook.external_link • openpyxl.workbook.external_reference • openpyxl.workbook.function_group • openpyxl.workbook.properties • openpyxl.workbook.protection • openpyxl.workbook.smart_tags • openpyxl.workbook.views • openpyxl.workbook.web • openpyxl.workbook.workbook

openpyxl.workbook._writer SourceModule

imports: openpyxl.packaging.relationship • openpyxl.packaging.workbook • openpyxl.utils • openpyxl.utils.datetime • openpyxl.workbook • openpyxl.workbook.defined_name • openpyxl.workbook.external_reference • openpyxl.workbook.properties • openpyxl.xml.constants • openpyxl.xml.functions

imported by: openpyxl.writer.excel

openpyxl.workbook.child SourceModule

imports: openpyxl.workbook • openpyxl.worksheet.header_footer • re • warnings

imported by: openpyxl.chartsheet.chartsheet • openpyxl.workbook.workbook • openpyxl.worksheet._write_only • openpyxl.worksheet.worksheet

openpyxl.workbook.defined_name SourceModule

imports: collections • openpyxl.compat • openpyxl.descriptors • openpyxl.descriptors.serialisable • openpyxl.formula • openpyxl.utils.cell • openpyxl.workbook • re

imported by: openpyxl.packaging.workbook • openpyxl.reader.workbook • openpyxl.workbook._writer • openpyxl.workbook.workbook • openpyxl.worksheet._read_only • openpyxl.worksheet.worksheet

openpyxl.workbook.external_link Package

imports: openpyxl.workbook • openpyxl.workbook.external_link.external

imported by: openpyxl.workbook.external_link.external

openpyxl.workbook.external_link.external SourceModule

imports: openpyxl.descriptors • openpyxl.descriptors.excel • openpyxl.descriptors.nested • openpyxl.descriptors.sequence • openpyxl.descriptors.serialisable • openpyxl.packaging.relationship • openpyxl.workbook.external_link • openpyxl.xml.constants • openpyxl.xml.functions

imported by: openpyxl.reader.workbook • openpyxl.workbook.external_link

openpyxl.workbook.external_reference SourceModule

imports: openpyxl.descriptors • openpyxl.descriptors.excel • openpyxl.descriptors.serialisable • openpyxl.workbook

imported by: openpyxl.packaging.workbook • openpyxl.workbook._writer

openpyxl.workbook.function_group SourceModule

imports: openpyxl.descriptors • openpyxl.descriptors.serialisable • openpyxl.workbook

imported by: openpyxl.packaging.workbook

openpyxl.workbook.properties SourceModule

imports: openpyxl.descriptors • openpyxl.descriptors.excel • openpyxl.descriptors.serialisable • openpyxl.workbook

imported by: openpyxl.packaging.workbook • openpyxl.workbook._writer • openpyxl.workbook.workbook

openpyxl.workbook.protection SourceModule

imports: openpyxl.descriptors • openpyxl.descriptors.excel • openpyxl.descriptors.serialisable • openpyxl.utils.protection • openpyxl.workbook

imported by: openpyxl.packaging.workbook • openpyxl.workbook.workbook

openpyxl.workbook.smart_tags SourceModule

imports: openpyxl.descriptors • openpyxl.descriptors.serialisable • openpyxl.workbook

imported by: openpyxl.packaging.workbook

openpyxl.workbook.views SourceModule

imports: openpyxl.descriptors • openpyxl.descriptors.excel • openpyxl.descriptors.serialisable • openpyxl.workbook

imported by: openpyxl.packaging.workbook • openpyxl.workbook.workbook

openpyxl.workbook.web SourceModule

imports: openpyxl.descriptors • openpyxl.descriptors.serialisable • openpyxl.workbook

imported by: openpyxl.packaging.workbook

openpyxl.workbook.workbook SourceModule

imports: copy • openpyxl.chartsheet • openpyxl.compat • openpyxl.packaging.core • openpyxl.packaging.custom • openpyxl.packaging.relationship • openpyxl.styles.alignment • openpyxl.styles.borders • openpyxl.styles.cell_style • openpyxl.styles.colors • openpyxl.styles.differential • openpyxl.styles.fills • openpyxl.styles.fonts • openpyxl.styles.named_styles • openpyxl.styles.protection • openpyxl.styles.table • openpyxl.utils • openpyxl.utils.datetime • openpyxl.utils.exceptions • openpyxl.utils.indexed_list • openpyxl.workbook • openpyxl.workbook.child • openpyxl.workbook.defined_name • openpyxl.workbook.properties • openpyxl.workbook.protection • openpyxl.workbook.views • openpyxl.worksheet._read_only • openpyxl.worksheet._write_only • openpyxl.worksheet.copier • openpyxl.worksheet.worksheet • openpyxl.writer.excel • openpyxl.xml.constants

imported by: openpyxl.workbook

openpyxl.worksheet Package

imports: openpyxl

imported by: openpyxl.worksheet._read_only • openpyxl.worksheet._reader • openpyxl.worksheet._write_only • openpyxl.worksheet._writer • openpyxl.worksheet.cell_range • openpyxl.worksheet.copier • openpyxl.worksheet.datavalidation • openpyxl.worksheet.dimensions • openpyxl.worksheet.drawing • openpyxl.worksheet.filters • openpyxl.worksheet.formula • openpyxl.worksheet.header_footer • openpyxl.worksheet.hyperlink • openpyxl.worksheet.merge • openpyxl.worksheet.page • openpyxl.worksheet.pagebreak • openpyxl.worksheet.print_settings • openpyxl.worksheet.properties • openpyxl.worksheet.protection • openpyxl.worksheet.related • openpyxl.worksheet.scenario • openpyxl.worksheet.table • openpyxl.worksheet.views • openpyxl.worksheet.worksheet

openpyxl.worksheet._read_only SourceModule

imports: openpyxl.cell.read_only • openpyxl.utils • openpyxl.workbook.defined_name • openpyxl.worksheet • openpyxl.worksheet._reader • openpyxl.worksheet.worksheet

imported by: openpyxl.reader.excel • openpyxl.workbook.workbook

openpyxl.worksheet._reader D:\anaconda3\Lib\site-packages\openpyxl\worksheet\_reader.cp313-win_amd64.pyd

imports: copy • openpyxl.cell • openpyxl.cell.rich_text • openpyxl.cell.text • openpyxl.descriptors.excel • openpyxl.formatting.formatting • openpyxl.formula.translate • openpyxl.utils • openpyxl.utils.datetime • openpyxl.worksheet • openpyxl.worksheet.cell_range • openpyxl.worksheet.datavalidation • openpyxl.worksheet.dimensions • openpyxl.worksheet.filters • openpyxl.worksheet.formula • openpyxl.worksheet.header_footer • openpyxl.worksheet.hyperlink • openpyxl.worksheet.merge • openpyxl.worksheet.page • openpyxl.worksheet.pagebreak • openpyxl.worksheet.properties • openpyxl.worksheet.protection • openpyxl.worksheet.related • openpyxl.worksheet.scenario • openpyxl.worksheet.table • openpyxl.worksheet.views • openpyxl.xml.constants • openpyxl.xml.functions • warnings

imported by: openpyxl.reader.excel • openpyxl.worksheet._read_only

openpyxl.worksheet._write_only SourceModule

imports: inspect • openpyxl.cell • openpyxl.utils.exceptions • openpyxl.workbook.child • openpyxl.worksheet • openpyxl.worksheet._writer • openpyxl.worksheet.worksheet

imported by: openpyxl.workbook.workbook

openpyxl.worksheet._writer D:\anaconda3\Lib\site-packages\openpyxl\worksheet\_writer.cp313-win_amd64.pyd

imports: atexit • collections • io • openpyxl.cell._writer • openpyxl.comments.comment_sheet • openpyxl.packaging.relationship • openpyxl.styles.differential • openpyxl.worksheet • openpyxl.worksheet.dimensions • openpyxl.worksheet.hyperlink • openpyxl.worksheet.merge • openpyxl.worksheet.related • openpyxl.worksheet.table • openpyxl.xml.constants • openpyxl.xml.functions • os • tempfile • warnings

imported by: openpyxl.worksheet._write_only • openpyxl.writer.excel

openpyxl.worksheet.cell_range SourceModule

imports: copy • itertools • openpyxl.descriptors • openpyxl.descriptors.sequence • openpyxl.descriptors.serialisable • openpyxl.utils • openpyxl.worksheet • operator

imported by: openpyxl.formatting.formatting • openpyxl.worksheet._reader • openpyxl.worksheet.datavalidation • openpyxl.worksheet.merge • openpyxl.worksheet.print_settings • openpyxl.worksheet.scenario • openpyxl.worksheet.worksheet

openpyxl.worksheet.copier SourceModule

imports: copy • openpyxl.worksheet • openpyxl.worksheet.worksheet

imported by: openpyxl.workbook.workbook

openpyxl.worksheet.datavalidation SourceModule

imports: collections • itertools • openpyxl.descriptors • openpyxl.descriptors.nested • openpyxl.descriptors.serialisable • openpyxl.utils • openpyxl.worksheet • openpyxl.worksheet.cell_range • operator

imported by: openpyxl.worksheet._reader • openpyxl.worksheet.worksheet

openpyxl.worksheet.dimensions SourceModule

imports: copy • openpyxl.compat • openpyxl.descriptors • openpyxl.descriptors.serialisable • openpyxl.styles.styleable • openpyxl.utils • openpyxl.utils.bound_dictionary • openpyxl.utils.units • openpyxl.worksheet • openpyxl.xml.functions

imported by: openpyxl.worksheet._reader • openpyxl.worksheet._writer • openpyxl.worksheet.worksheet

openpyxl.worksheet.drawing SourceModule

imports: openpyxl.descriptors.excel • openpyxl.descriptors.serialisable • openpyxl.worksheet

imported by: openpyxl.chartsheet.chartsheet

openpyxl.worksheet.filters SourceModule

imports: openpyxl.descriptors • openpyxl.descriptors.excel • openpyxl.descriptors.sequence • openpyxl.descriptors.serialisable • openpyxl.utils • openpyxl.worksheet • re

imported by: openpyxl.pivot.table • openpyxl.worksheet._reader • openpyxl.worksheet.table • openpyxl.worksheet.worksheet

openpyxl.worksheet.formula SourceModule

imports: openpyxl.compat • openpyxl.worksheet

imported by: openpyxl.cell._writer • openpyxl.cell.cell • openpyxl.worksheet._reader • openpyxl.worksheet.worksheet

openpyxl.worksheet.header_footer SourceModule

imports: openpyxl.descriptors • openpyxl.descriptors.serialisable • openpyxl.utils.escape • openpyxl.worksheet • openpyxl.xml.functions • re • warnings

imported by: openpyxl.chart.print_settings • openpyxl.chartsheet.chartsheet • openpyxl.chartsheet.custom • openpyxl.workbook.child • openpyxl.worksheet._reader

openpyxl.worksheet.hyperlink SourceModule

imports: openpyxl.descriptors • openpyxl.descriptors.excel • openpyxl.descriptors.serialisable • openpyxl.worksheet

imported by: openpyxl.cell.cell • openpyxl.worksheet._reader • openpyxl.worksheet._writer

openpyxl.worksheet.merge SourceModule

imports: copy • openpyxl.cell.cell • openpyxl.descriptors • openpyxl.descriptors.serialisable • openpyxl.styles.borders • openpyxl.worksheet • openpyxl.worksheet.cell_range

imported by: openpyxl.worksheet._reader • openpyxl.worksheet._writer • openpyxl.worksheet.worksheet

openpyxl.worksheet.page SourceModule

imports: openpyxl.descriptors • openpyxl.descriptors.excel • openpyxl.descriptors.serialisable • openpyxl.worksheet

imported by: openpyxl.chart.print_settings • openpyxl.chartsheet.chartsheet • openpyxl.chartsheet.custom • openpyxl.worksheet._reader • openpyxl.worksheet.worksheet

openpyxl.worksheet.pagebreak SourceModule

imports: openpyxl.descriptors • openpyxl.descriptors.serialisable • openpyxl.worksheet

imported by: openpyxl.worksheet._reader • openpyxl.worksheet.worksheet

openpyxl.worksheet.print_settings SourceModule

imports: openpyxl.descriptors • openpyxl.utils • openpyxl.utils.cell • openpyxl.worksheet • openpyxl.worksheet.cell_range • re

imported by: openpyxl.reader.workbook • openpyxl.worksheet.worksheet

openpyxl.worksheet.properties SourceModule

imports: openpyxl.descriptors • openpyxl.descriptors.serialisable • openpyxl.styles.colors • openpyxl.worksheet

imported by: openpyxl.worksheet._reader • openpyxl.worksheet.worksheet

openpyxl.worksheet.protection SourceModule

imports: openpyxl.descriptors • openpyxl.descriptors.excel • openpyxl.descriptors.serialisable • openpyxl.utils.protection • openpyxl.worksheet

imported by: openpyxl.chartsheet.protection • openpyxl.worksheet._reader • openpyxl.worksheet.worksheet

openpyxl.worksheet.related SourceModule

imports: openpyxl.descriptors.excel • openpyxl.descriptors.serialisable • openpyxl.worksheet

imported by: openpyxl.worksheet._reader • openpyxl.worksheet._writer • openpyxl.worksheet.table

openpyxl.worksheet.scenario SourceModule

imports: openpyxl.descriptors • openpyxl.descriptors.serialisable • openpyxl.worksheet • openpyxl.worksheet.cell_range

imported by: openpyxl.worksheet._reader • openpyxl.worksheet.worksheet

openpyxl.worksheet.table SourceModule

imports: openpyxl.descriptors • openpyxl.descriptors.excel • openpyxl.descriptors.sequence • openpyxl.descriptors.serialisable • openpyxl.utils • openpyxl.utils.escape • openpyxl.worksheet • openpyxl.worksheet.filters • openpyxl.worksheet.related • openpyxl.xml.constants • openpyxl.xml.functions

imported by: openpyxl.reader.excel • openpyxl.worksheet._reader • openpyxl.worksheet._writer • openpyxl.worksheet.worksheet

openpyxl.worksheet.views SourceModule

imports: openpyxl.descriptors • openpyxl.descriptors.excel • openpyxl.descriptors.serialisable • openpyxl.worksheet

imported by: openpyxl.worksheet._reader • openpyxl.worksheet.worksheet

openpyxl.worksheet.worksheet SourceModule

imports: inspect • itertools • openpyxl.cell • openpyxl.compat • openpyxl.formatting.formatting • openpyxl.formula.translate • openpyxl.packaging.relationship • openpyxl.utils • openpyxl.workbook.child • openpyxl.workbook.defined_name • openpyxl.worksheet • openpyxl.worksheet.cell_range • openpyxl.worksheet.datavalidation • openpyxl.worksheet.dimensions • openpyxl.worksheet.filters • openpyxl.worksheet.formula • openpyxl.worksheet.merge • openpyxl.worksheet.page • openpyxl.worksheet.pagebreak • openpyxl.worksheet.print_settings • openpyxl.worksheet.properties • openpyxl.worksheet.protection • openpyxl.worksheet.scenario • openpyxl.worksheet.table • openpyxl.worksheet.views • operator • warnings

imported by: openpyxl.chart.reference • openpyxl.workbook.workbook • openpyxl.worksheet._read_only • openpyxl.worksheet._write_only • openpyxl.worksheet.copier

openpyxl.writer Package

imports: openpyxl

imported by: openpyxl.writer.excel • openpyxl.writer.theme

openpyxl.writer.excel SourceModule

imports: datetime • openpyxl.comments.comment_sheet • openpyxl.drawing.spreadsheet_drawing • openpyxl.packaging.extended • openpyxl.packaging.manifest • openpyxl.packaging.relationship • openpyxl.styles.stylesheet • openpyxl.utils.exceptions • openpyxl.workbook._writer • openpyxl.worksheet._writer • openpyxl.writer • openpyxl.writer.theme • openpyxl.xml.constants • openpyxl.xml.functions • re • zipfile

imported by: openpyxl.workbook.workbook

openpyxl.writer.theme SourceModule

imports: openpyxl.writer

imported by: openpyxl.writer.excel

openpyxl.xml Package

imports: 'lxml.etree' • defusedxml • openpyxl • os • warnings

imported by: openpyxl • openpyxl.xml.constants • openpyxl.xml.functions

openpyxl.xml.constants SourceModule

imports: openpyxl.xml

imported by: openpyxl.chart.axis • openpyxl.chart.chartspace • openpyxl.chartsheet.chartsheet • openpyxl.comments.comment_sheet • openpyxl.descriptors.excel • openpyxl.drawing.colors • openpyxl.drawing.fill • openpyxl.drawing.geometry • openpyxl.drawing.graphic • openpyxl.drawing.line • openpyxl.drawing.picture • openpyxl.drawing.properties • openpyxl.drawing.relation • openpyxl.drawing.spreadsheet_drawing • openpyxl.drawing.text • openpyxl.packaging.core • openpyxl.packaging.custom • openpyxl.packaging.extended • openpyxl.packaging.manifest • openpyxl.packaging.relationship • openpyxl.packaging.workbook • openpyxl.pivot.cache • openpyxl.pivot.record • openpyxl.pivot.table • openpyxl.reader.drawings • openpyxl.reader.excel • openpyxl.reader.strings • openpyxl.styles.fills • openpyxl.styles.fonts • openpyxl.styles.stylesheet • openpyxl.workbook._writer • openpyxl.workbook.external_link.external • openpyxl.workbook.workbook • openpyxl.worksheet._reader • openpyxl.worksheet._writer • openpyxl.worksheet.table • openpyxl.writer.excel • openpyxl.xml.functions

openpyxl.xml.functions SourceModule

imports: 'lxml.etree' • defusedxml.ElementTree • et_xmlfile • et_xmlfile.xmlfile • functools • openpyxl • openpyxl.xml • openpyxl.xml.constants • re • xml.etree.ElementTree

imported by: openpyxl.cell._writer • openpyxl.cell.rich_text • openpyxl.comments.shape_writer • openpyxl.descriptors.container • openpyxl.descriptors.excel • openpyxl.descriptors.nested • openpyxl.descriptors.sequence • openpyxl.descriptors.serialisable • openpyxl.packaging.core • openpyxl.packaging.manifest • openpyxl.packaging.relationship • openpyxl.pivot.cache • openpyxl.pivot.record • openpyxl.pivot.table • openpyxl.reader.drawings • openpyxl.reader.excel • openpyxl.reader.strings • openpyxl.reader.workbook • openpyxl.styles.builtins • openpyxl.styles.fills • openpyxl.styles.fonts • openpyxl.styles.stylesheet • openpyxl.workbook._writer • openpyxl.workbook.external_link.external • openpyxl.worksheet._reader • openpyxl.worksheet._writer • openpyxl.worksheet.dimensions • openpyxl.worksheet.header_footer • openpyxl.worksheet.table • openpyxl.writer.excel

operator SourceModule

imports: _operator • builtins • functools

imported by: _pydatetime • ads7953_diagnostic_gui.py • collections • copyreg • email._header_value_parser • fractions • gettext • glob • importlib.metadata • importlib.resources.readers • inspect • openpyxl.chart._chart • openpyxl.worksheet.cell_range • openpyxl.worksheet.datavalidation • openpyxl.worksheet.worksheet • pathlib._local • random • statistics • typing

os SourceModule

imports: _collections_abc • abc • io • nt • ntpath • os.path • posix • posixpath • stat • subprocess • sys • warnings

imported by: _aix_support • _colorize • _pyrepl.pager • _strptime • ads7953_diagnostic_gui.py • argparse • bz2 • contextlib • ctypes • email.utils • fnmatch • genericpath • getopt • getpass • gettext • glob • gzip • http.cookiejar • http.server • importlib.metadata • importlib.metadata._meta • importlib.resources._common • importlib.resources.abc • inspect • linecache • locale • logging • lzma • mimetypes • netrc • ntpath • openpyxl.worksheet._writer • openpyxl.xml • os.path • pathlib._local • pkgutil • platform • posixpath • py_compile • pydoc • pyi_rth__tkinter.py • pyi_rth_inspect.py • random • serial • serial.serialposix • serial.tools.list_ports • serial.tools.list_ports_common • serial.tools.list_ports_linux • serial.tools.list_ports_posix • shlex • shutil • socket • socketserver • ssl • subprocess • sysconfig • tarfile • tempfile • threading • tkinter • tkinter.filedialog • urllib.request • webbrowser • xml.dom.domreg • xml.sax • xml.sax.saxutils • xmlrpc.server • zipfile • zipfile._path.glob

os.path AliasNode

imports: ntpath • os

imported by: openpyxl.packaging.manifest • openpyxl.reader.excel • os • pkgutil • py_compile • serial.tools.list_ports_common • sysconfig • tracemalloc

pathlib Package

imports: pathlib._abc • pathlib._local

imported by: ads7953_Nboard_gui • ads7953_diagnostic_gui.py • importlib.metadata • importlib.resources._common • importlib.resources.abc • importlib.resources.readers • pathlib._abc • pathlib._local • zipfile._path

pathlib._abc SourceModule

imports: errno • functools • glob • pathlib • stat

imported by: pathlib • pathlib._local

pathlib._local SourceModule

imports: _collections_abc • glob • grp • io • itertools • ntpath • operator • os • pathlib • pathlib._abc • posixpath • pwd • sys • urllib.parse • warnings

imported by: pathlib

pickle SourceModule

imports: _compat_pickle • _pickle • codecs • copyreg • functools • io • itertools • pprint • re • struct • sys • types

imported by: logging • tracemalloc

pkgutil SourceModule

imports: collections • functools • importlib • importlib.machinery • importlib.util • inspect • marshal • os • os.path • re • sys • types • warnings • zipimport

imported by: pydoc • pyi_rth_pkgutil.py

platform SourceModule

imports: 'java.lang' • _wmi • collections • ctypes • functools • itertools • java • os • re • socket • struct • subprocess • sys • vms_lib • warnings • winreg

imported by: pydoc

posix MissingModule

imports: resource

imported by: importlib._bootstrap_external • os • posixpath • shutil

posixpath SourceModule

imports: errno • genericpath • os • posix • pwd • re • stat • sys

imported by: ads7953_diagnostic_gui.py • fnmatch • http.server • importlib.metadata • mimetypes • openpyxl.packaging.relationship • os • pathlib._local • xml.dom.xmlbuilder • zipfile._path

pprint SourceModule

imports: collections • dataclasses • io • re • sys • types

imported by: pickle

pwd MissingModule

imported by: getpass • http.server • netrc • pathlib._local • posixpath • shutil • subprocess • tarfile

py_compile SourceModule

imports: argparse • enum • importlib._bootstrap_external • importlib.machinery • importlib.util • os • os.path • sys • traceback

imported by: zipfile

pydoc SourceModule

imports: __future__ • _pyrepl.pager • ast • builtins • collections • email.message • getopt • http.server • importlib._bootstrap • importlib._bootstrap_external • importlib.machinery • importlib.util • inspect • io • os • pkgutil • platform • pydoc_data.topics • re • reprlib • select • sys • sysconfig • textwrap • threading • time • tokenize • traceback • urllib.parse • warnings • webbrowser

imported by: xmlrpc.server

pydoc_data Package

imported by: pydoc_data.topics

pydoc_data.topics SourceModule

imports: pydoc_data

imported by: pydoc

pyexpat D:\anaconda3\DLLs\pyexpat.pyd

imported by: _elementtree • xml.etree.ElementTree • xml.parsers.expat

pyimod02_importers MissingModule

imported by: pyi_rth_pkgutil.py

queue SourceModule

imports: _queue • collections • heapq • threading • time • types

imported by: ads7953_Nboard_gui • ads7953_diagnostic_gui.py

quopri SourceModule

imports: binascii • getopt • io • sys

imported by: email.encoders • email.message • encodings.quopri_codec

random SourceModule

imports: _collections_abc • _random • _sha2 • argparse • bisect • hashlib • itertools • math • operator • os • statistics • time • warnings

imported by: email.generator • email.utils • statistics • tempfile

re Package

imports: _sre • copyreg • enum • functools • re • re._compiler • re._constants • re._parser • warnings

imported by: _pydecimal • _pyrepl.pager • _sre • _strptime • ads7953_diagnostic_gui.py • argparse • ast • base64 • csv • dataclasses • email._encoded_words • email._header_value_parser • email.feedparser • email.generator • email.header • email.message • email.policy • email.quoprimime • email.utils • encodings.idna • fnmatch • fractions • ftplib • gettext • glob • html • http.client • http.cookiejar • importlib.metadata • importlib.metadata._adapters • importlib.metadata._text • importlib.resources.readers • inspect • ipaddress • json.decoder • json.encoder • json.scanner • locale • logging • openpyxl.cell.cell • openpyxl.descriptors.base • openpyxl.formula.tokenizer • openpyxl.formula.translate • openpyxl.styles.colors • openpyxl.styles.numbers • openpyxl.utils.cell • openpyxl.utils.datetime • openpyxl.utils.escape • openpyxl.workbook.child • openpyxl.workbook.defined_name • openpyxl.worksheet.filters • openpyxl.worksheet.header_footer • openpyxl.worksheet.print_settings • openpyxl.writer.excel • openpyxl.xml.functions • pickle • pkgutil • platform • posixpath • pprint • pydoc • re • re._casefix • re._compiler • re._constants • re._parser • serial.tools.list_ports • serial.tools.list_ports_common • serial.tools.list_ports_windows • shlex • sre_compile • sre_constants • sre_parse • string • sysconfig • tarfile • textwrap • tkinter • tokenize • typing • urllib.parse • urllib.request • warnings • xml.etree.ElementPath • xml.etree.ElementTree • xmlrpc.server • zipfile._path • zipfile._path.glob

re._casefix SourceModule

imports: re

imported by: ads7953_diagnostic_gui.py • re._compiler

re._compiler SourceModule

imports: _sre • re • re._casefix • re._constants • re._parser • sys

imported by: ads7953_diagnostic_gui.py • re • sre_compile

re._constants SourceModule

imports: _sre • re

imported by: ads7953_diagnostic_gui.py • re • re._compiler • re._parser • sre_constants

re._parser SourceModule

imports: re • re._constants • unicodedata • warnings

imported by: ads7953_diagnostic_gui.py • re • re._compiler • sre_parse

reprlib SourceModule

imports: _thread • builtins • itertools • math • sys

imported by: ads7953_diagnostic_gui.py • collections • dataclasses • functools • pydoc

resource MissingModule

imported by: posix

select D:\anaconda3\DLLs\select.pyd

imported by: http.server • pydoc • selectors • serial.serialposix • subprocess

selectors SourceModule

imports: 'collections.abc' • abc • collections • math • select • sys

imported by: socket • socketserver • subprocess

serial Package

imports: __future__ • importlib • os • serial.serialcli • serial.serialjava • serial.serialposix • serial.serialutil • serial.serialwin32 • serial.win32 • sys

imported by: ads7953_Nboard_gui • ads7953_diagnostic_gui.py • serial.serialcli • serial.serialjava • serial.serialposix • serial.serialutil • serial.serialwin32 • serial.tools • serial.tools.list_ports_posix • serial.tools.list_ports_windows • serial.win32

serial.serialcli SourceModule

imports: 'System.IO' • System • __future__ • serial • serial.serialutil

imported by: serial

serial.serialjava SourceModule

imports: __future__ • serial • serial.serialutil

imported by: serial

serial.serialposix SourceModule

imports: __future__ • array • errno • fcntl • os • select • serial • serial.serialutil • struct • sys • termios • warnings

imported by: serial

serial.serialutil SourceModule

imports: __future__ • array • io • serial • sys • time

imported by: serial • serial.serialcli • serial.serialjava • serial.serialposix • serial.serialwin32

serial.serialwin32 SourceModule

imports: __future__ • ctypes • serial • serial.serialutil • serial.win32 • time

imported by: serial

serial.tools Package

imports: serial • serial.tools.list_ports • serial.tools.list_ports_common

imported by: ads7953_Nboard_gui • serial.tools.list_ports • serial.tools.list_ports_common • serial.tools.list_ports_linux • serial.tools.list_ports_osx • serial.tools.list_ports_posix • serial.tools.list_ports_windows

serial.tools.list_ports SourceModule

imports: __future__ • argparse • os • re • serial.tools • serial.tools.list_ports_posix • serial.tools.list_ports_windows • sys

imported by: ads7953_Nboard_gui • serial.tools

serial.tools.list_ports_common SourceModule

imports: __future__ • glob • os • os.path • re • serial.tools

imported by: serial.tools • serial.tools.list_ports_linux • serial.tools.list_ports_osx • serial.tools.list_ports_posix • serial.tools.list_ports_windows

serial.tools.list_ports_linux SourceModule

imports: __future__ • glob • os • serial.tools • serial.tools.list_ports_common

imported by: serial.tools.list_ports_posix

serial.tools.list_ports_osx SourceModule

imports: __future__ • ctypes • serial.tools • serial.tools.list_ports_common

imported by: serial.tools.list_ports_posix

serial.tools.list_ports_posix SourceModule

imports: __future__ • glob • os • serial • serial.tools • serial.tools.list_ports_common • serial.tools.list_ports_linux • serial.tools.list_ports_osx • sys

imported by: serial.tools.list_ports

serial.tools.list_ports_windows SourceModule

imports: __future__ • ctypes • ctypes.wintypes • re • serial • serial.tools • serial.tools.list_ports_common • serial.win32

imported by: serial.tools.list_ports

serial.win32 SourceModule

imports: __future__ • ctypes • ctypes.wintypes • serial

imported by: serial • serial.serialwin32 • serial.tools.list_ports_windows

shlex SourceModule

imports: collections • io • os • re • sys

imported by: webbrowser

shutil SourceModule

imports: _winapi • bz2 • collections • errno • fnmatch • grp • lzma • nt • os • posix • pwd • stat • sys • tarfile • zipfile • zlib

imported by: argparse • http.server • tarfile • tempfile • webbrowser • zipfile

signal SourceModule

imports: _signal • enum

imported by: subprocess

socket SourceModule

imports: _socket • array • enum • errno • io • os • selectors • sys

imported by: _ssl • email.utils • ftplib • http.client • http.server • platform • socketserver • ssl • urllib.request

socketserver SourceModule

imports: io • os • selectors • socket • sys • threading • time • traceback

imported by: http.server • xmlrpc.server

sre_compile SourceModule

imports: re • re._compiler • warnings

imported by: ads7953_diagnostic_gui.py

sre_constants SourceModule

imports: re • re._constants • warnings

imported by: ads7953_diagnostic_gui.py

sre_parse SourceModule

imports: re • re._parser • warnings

imported by: ads7953_diagnostic_gui.py

ssl SourceModule

imports: _ssl • base64 • calendar • collections • enum • errno • os • socket • sys • time • warnings

imported by: ftplib • http.client • urllib.request

stat SourceModule

imports: _stat

imported by: ads7953_diagnostic_gui.py • genericpath • glob • netrc • os • pathlib._abc • posixpath • shutil • tarfile • zipfile • zipfile._path

statistics SourceModule

imports: _statistics • bisect • collections • decimal • fractions • functools • itertools • math • numbers • operator • random • sys

imported by: random

string SourceModule

imports: _string • collections • re

imported by: email._encoded_words • email._header_value_parser • email.quoprimime • logging • ntpath • nturl2path • openpyxl.utils.cell • urllib.request

stringprep SourceModule

imports: unicodedata

imported by: encodings.idna

struct SourceModule

imports: _struct

imported by: base64 • ctypes • gettext • gzip • pickle • platform • serial.serialposix • tarfile • zipfile • zipimport

subprocess SourceModule

imports: _posixsubprocess • _winapi • builtins • contextlib • errno • fcntl • grp • io • locale • msvcrt • os • pwd • select • selectors • signal • sys • threading • time • types • warnings

imported by: _aix_support • _pyrepl.pager • http.server • os • platform • webbrowser

sys (builtin module)

imported by: _aix_support • _collections_abc • _colorize • _compression • _pydatetime • _pydecimal • _pyrepl.pager • argparse • ast • base64 • calendar • codecs • collections • contextlib • ctypes • ctypes._endian • dataclasses • decimal • defusedxml.ElementTree • defusedxml.common • dis • email._header_value_parser • email.generator • email.iterators • email.policy • encodings • encodings.rot_13 • encodings.utf_16 • encodings.utf_32 • enum • fractions • ftplib • getopt • getpass • gettext • glob • gzip • http.client • http.server • importlib • importlib._bootstrap_external • importlib.metadata • importlib.util • inspect • linecache • locale • logging • mimetypes • ntpath • openpyxl.compat.strings • os • pathlib._local • pickle • pkgutil • platform • posixpath • pprint • py_compile • pydoc • pyi_rth__tkinter.py • pyi_rth_inspect.py • quopri • re._compiler • reprlib • selectors • serial • serial.serialposix • serial.serialutil • serial.tools.list_ports • serial.tools.list_ports_posix • shlex • shutil • socket • socketserver • ssl • statistics • subprocess • sysconfig • tarfile • tempfile • threading • tkinter • tokenize • traceback • types • typing • urllib.request • warnings • weakref • webbrowser • xml.dom.domreg • xml.etree.ElementTree • xml.parsers.expat • xml.sax • xml.sax.saxutils • xmlrpc.client • xmlrpc.server • zipfile • zipfile._path • zipimport

sysconfig Package

imports: _aix_support • _sysconfig • _winapi • importlib.machinery • importlib.util • os • os.path • re • sys • threading • warnings

imported by: _aix_support • pydoc

tarfile SourceModule

imports: argparse • builtins • bz2 • copy • grp • gzip • io • lzma • os • pwd • re • shutil • stat • struct • sys • time • warnings • zlib

imported by: shutil

tempfile SourceModule

imports: _thread • errno • functools • io • os • random • shutil • sys • types • warnings • weakref

imported by: _pyrepl.pager • importlib.resources._common • openpyxl.worksheet._writer • urllib.request • urllib.response

termios MissingModule

imported by: _pyrepl.pager • getpass • serial.serialposix • tty

textwrap SourceModule

imports: re

imported by: argparse • importlib.metadata • importlib.metadata._adapters • pydoc • traceback

threading SourceModule

imports: _collections • _thread • _threading_local • _weakrefset • collections • itertools • os • sys • time • traceback • warnings

imported by: _threading_local • ads7953_Nboard_gui • http.cookiejar • importlib.util • logging • pydoc • queue • socketserver • subprocess • sysconfig • webbrowser • zipfile

time (builtin module)

imports: _strptime

imported by: _datetime • _pydatetime • _strptime • ads7953_Nboard_gui • datetime • email._parseaddr • email.generator • email.utils • gc • gzip • http.cookiejar • http.server • logging • pydoc • queue • random • serial.serialutil • serial.serialwin32 • socketserver • ssl • subprocess • tarfile • threading • urllib.request • xmlrpc.client • zipfile • zipimport

tkinter Package

imports: _tkinter • collections • enum • os • re • sys • tkinter.commondialog • tkinter.constants • tkinter.filedialog • tkinter.messagebox • tkinter.ttk • traceback • types

imported by: ads7953_Nboard_gui • ads7953_diagnostic_gui.py • tkinter.commondialog • tkinter.constants • tkinter.dialog • tkinter.filedialog • tkinter.messagebox • tkinter.simpledialog • tkinter.ttk

tkinter.commondialog SourceModule

imports: tkinter

imported by: tkinter • tkinter.filedialog • tkinter.messagebox

tkinter.constants SourceModule

imports: tkinter

imported by: tkinter

tkinter.dialog SourceModule

imports: tkinter

imported by: tkinter.filedialog

tkinter.filedialog SourceModule

imports: fnmatch • locale • os • tkinter • tkinter.commondialog • tkinter.dialog • tkinter.simpledialog

imported by: ads7953_Nboard_gui • tkinter

tkinter.messagebox SourceModule

imports: tkinter • tkinter.commondialog

imported by: ads7953_Nboard_gui • tkinter • tkinter.simpledialog

tkinter.simpledialog SourceModule

imports: tkinter • tkinter.messagebox

imported by: tkinter.filedialog

tkinter.ttk SourceModule

imports: tkinter

imported by: ads7953_Nboard_gui • tkinter

token SourceModule

imported by: inspect • tokenize

tokenize SourceModule

imports: _tokenize • argparse • builtins • codecs • collections • functools • io • itertools • re • sys • token

imported by: importlib._bootstrap_external • inspect • linecache • pydoc

traceback SourceModule

imports: 'collections.abc' • _colorize • _suggestions • ast • contextlib • itertools • linecache • sys • textwrap • unicodedata • warnings

imported by: ads7953_diagnostic_gui.py • http.cookiejar • logging • py_compile • pydoc • socketserver • threading • tkinter • warnings • xmlrpc.server

tracemalloc SourceModule

imports: 'collections.abc' • _tracemalloc • fnmatch • functools • linecache • os.path • pickle

imported by: warnings

tty SourceModule

imports: termios

imported by: _pyrepl.pager

types SourceModule

imports: _collections_abc • _socket • functools • sys

imported by: _weakrefset • ads7953_diagnostic_gui.py • contextlib • copy • csv • ctypes • dataclasses • dis • email.headerregistry • enum • functools • importlib.metadata • importlib.metadata._functools • importlib.resources._common • importlib.util • inspect • logging • pickle • pkgutil • pprint • queue • subprocess • tempfile • tkinter • typing • urllib.parse • warnings

typing SourceModule

imports: 'collections.abc' • _typing • abc • collections • contextlib • copyreg • functools • inspect • operator • re • sys • types • warnings

imported by: _colorize • _pyrepl.pager • functools • importlib.metadata • importlib.metadata._meta • importlib.resources._common • importlib.resources.abc

unicodedata D:\anaconda3\DLLs\unicodedata.pyd

imported by: encodings.idna • re._parser • stringprep • traceback • urllib.parse

urllib Package

imported by: email._header_value_parser • urllib.error • urllib.parse • urllib.request • urllib.response

urllib.error SourceModule

imports: io • urllib • urllib.response

imported by: urllib.request

urllib.parse SourceModule

imports: collections • functools • ipaddress • math • re • types • unicodedata • urllib • warnings

imported by: email.utils • http.client • http.cookiejar • http.server • mimetypes • nturl2path • pathlib._local • pydoc • urllib.request • xml.dom.xmlbuilder • xml.etree.ElementInclude • xml.sax.saxutils • xmlrpc.client

urllib.request SourceModule

imports: _scproxy • base64 • bisect • contextlib • email • email.utils • fnmatch • ftplib • getpass • hashlib • http.client • http.cookiejar • io • ipaddress • mimetypes • nturl2path • os • re • socket • ssl • string • sys • tempfile • time • urllib • urllib.error • urllib.parse • urllib.response • warnings • winreg

imported by: http.cookiejar • xml.dom.xmlbuilder • xml.sax.saxutils

urllib.response SourceModule

imports: tempfile • urllib

imported by: urllib.error • urllib.request

vms_lib MissingModule

imported by: platform

warnings SourceModule

imports: _warnings • builtins • functools • inspect • linecache • re • sys • traceback • tracemalloc • types

imported by: _collections_abc • _pydatetime • _strptime • ads7953_diagnostic_gui.py • argparse • ast • calendar • ctypes • defusedxml • defusedxml.ElementTree • defusedxml.cElementTree • email.utils • enum • functools • getpass • gettext • glob • gzip • http.cookiejar • http.server • importlib.abc • importlib.metadata • importlib.metadata._adapters • importlib.resources._common • importlib.resources._functional • importlib.resources.readers • locale • logging • openpyxl.compat • openpyxl.packaging.custom • openpyxl.packaging.relationship • openpyxl.reader.drawings • openpyxl.reader.excel • openpyxl.reader.workbook • openpyxl.styles.stylesheet • openpyxl.workbook.child • openpyxl.worksheet._reader • openpyxl.worksheet._writer • openpyxl.worksheet.header_footer • openpyxl.worksheet.worksheet • openpyxl.xml • os • pathlib._local • pkgutil • platform • pydoc • random • re • re._parser • serial.serialposix • sre_compile • sre_constants • sre_parse • ssl • subprocess • sysconfig • tarfile • tempfile • threading • traceback • typing • urllib.parse • urllib.request • xml.etree.ElementTree • zipfile

weakref SourceModule

imports: _collections_abc • _weakref • _weakrefset • atexit • copy • gc • itertools • sys

imported by: _threading_local • ads7953_diagnostic_gui.py • copy • functools • gzip • inspect • logging • tempfile • xml.etree.ElementTree • xml.sax.expatreader

webbrowser SourceModule

imports: argparse • copy • ctypes • os • shlex • shutil • subprocess • sys • threading

imported by: pydoc

winreg (builtin module)

imported by: importlib._bootstrap_external • mimetypes • platform • urllib.request

xml Package

imports: xml.sax.expatreader • xml.sax.xmlreader

imported by: xml.dom • xml.etree • xml.parsers • xml.sax

xml.dom Package

imports: xml • xml.dom.domreg • xml.dom.minidom • xml.dom.pulldom • xml.dom.xmlbuilder

imported by: xml.dom.NodeFilter • xml.dom.domreg • xml.dom.expatbuilder • xml.dom.minicompat • xml.dom.minidom • xml.dom.pulldom • xml.dom.xmlbuilder

xml.dom.NodeFilter SourceModule

imports: xml.dom

imported by: xml.dom.expatbuilder • xml.dom.xmlbuilder

xml.dom.domreg SourceModule

imports: os • sys • xml.dom • xml.dom.minidom

imported by: xml.dom • xml.dom.minidom

xml.dom.expatbuilder SourceModule

imports: xml.dom • xml.dom.NodeFilter • xml.dom.minidom • xml.dom.xmlbuilder • xml.parsers • xml.parsers.expat

imported by: defusedxml.expatbuilder • xml.dom.minidom • xml.dom.xmlbuilder

xml.dom.minicompat SourceModule

imports: xml.dom

imported by: xml.dom.minidom

xml.dom.minidom SourceModule

imports: io • xml.dom • xml.dom.domreg • xml.dom.expatbuilder • xml.dom.minicompat • xml.dom.pulldom • xml.dom.xmlbuilder

imported by: defusedxml.minidom • xml.dom • xml.dom.domreg • xml.dom.expatbuilder • xml.dom.pulldom

xml.dom.pulldom SourceModule

imports: io • xml.dom • xml.dom.minidom • xml.sax • xml.sax.handler

imported by: defusedxml.pulldom • xml.dom • xml.dom.minidom

xml.dom.xmlbuilder SourceModule

imports: copy • posixpath • urllib.parse • urllib.request • xml.dom • xml.dom.NodeFilter • xml.dom.expatbuilder

imported by: xml.dom • xml.dom.expatbuilder • xml.dom.minidom

xml.etree Package

imports: xml • xml.etree • xml.etree.ElementPath • xml.etree.ElementTree

imported by: xml.etree • xml.etree.ElementInclude • xml.etree.ElementPath • xml.etree.ElementTree • xml.etree.cElementTree

xml.etree.ElementInclude SourceModule

imports: copy • urllib.parse • xml.etree • xml.etree.ElementTree

imported by: _elementtree

xml.etree.ElementPath SourceModule

imports: re • xml.etree

imported by: _elementtree • xml.etree • xml.etree.ElementTree

xml.etree.ElementTree SourceModule

imports: 'collections.abc' • _elementtree • collections • contextlib • io • pyexpat • re • sys • warnings • weakref • xml.etree • xml.etree.ElementPath • xml.parsers • xml.parsers.expat

imported by: _elementtree • defusedxml.ElementTree • defusedxml.cElementTree • et_xmlfile.incremental_tree • et_xmlfile.xmlfile • openpyxl.xml.functions • xml.etree • xml.etree.ElementInclude • xml.etree.cElementTree

xml.etree.cElementTree SourceModule

imports: xml.etree • xml.etree.ElementTree

imported by: _elementtree • defusedxml.cElementTree

xml.parsers Package

imports: xml

imported by: xml.dom.expatbuilder • xml.etree.ElementTree • xml.parsers.expat • xml.sax.expatreader • xmlrpc.client

xml.parsers.expat SourceModule

imports: pyexpat • sys • xml.parsers

imported by: defusedxml.common • xml.dom.expatbuilder • xml.etree.ElementTree • xml.sax.expatreader • xmlrpc.client

xml.sax Package

imports: io • os • sys • xml • xml.sax • xml.sax._exceptions • xml.sax.expatreader • xml.sax.handler • xml.sax.saxutils • xml.sax.xmlreader

imported by: defusedxml.sax • xml.dom.pulldom • xml.sax • xml.sax._exceptions • xml.sax.expatreader • xml.sax.handler • xml.sax.saxutils • xml.sax.xmlreader

xml.sax._exceptions SourceModule

imports: xml.sax

imported by: xml.sax • xml.sax.expatreader • xml.sax.xmlreader

xml.sax.expatreader SourceModule

imports: _weakref • weakref • xml.parsers • xml.parsers.expat • xml.sax • xml.sax._exceptions • xml.sax.handler • xml.sax.saxutils • xml.sax.xmlreader

imported by: defusedxml.expatreader • xml • xml.sax

xml.sax.handler SourceModule

imports: xml.sax

imported by: xml.dom.pulldom • xml.sax • xml.sax.expatreader • xml.sax.saxutils • xml.sax.xmlreader

xml.sax.saxutils SourceModule

imports: codecs • io • os • sys • urllib.parse • urllib.request • xml.sax • xml.sax.handler • xml.sax.xmlreader

imported by: xml.sax • xml.sax.expatreader • xml.sax.xmlreader

xml.sax.xmlreader SourceModule

imports: xml.sax • xml.sax._exceptions • xml.sax.handler • xml.sax.saxutils

imported by: xml • xml.sax • xml.sax.expatreader • xml.sax.saxutils

xmlrpc Package

imports: xmlrpc.server

imported by: defusedxml.xmlrpc • xmlrpc.client • xmlrpc.server

xmlrpc.client SourceModule

imports: base64 • datetime • decimal • errno • gzip • http.client • io • sys • time • urllib.parse • xml.parsers • xml.parsers.expat • xmlrpc

imported by: defusedxml.xmlrpc • xmlrpc.server

xmlrpc.server SourceModule

imports: datetime • fcntl • functools • html • http.server • inspect • os • pydoc • re • socketserver • sys • traceback • xmlrpc • xmlrpc.client

imported by: defusedxml.xmlrpc • xmlrpc

xmlrpclib MissingModule

imported by: defusedxml.xmlrpc

zipfile Package

imports: argparse • binascii • bz2 • importlib.util • io • lzma • os • py_compile • shutil • stat • struct • sys • threading • time • warnings • zipfile._path • zlib

imported by: importlib.metadata • importlib.resources.readers • openpyxl.reader.excel • openpyxl.writer.excel • pyi_rth_inspect.py • shutil • zipfile._path

zipfile._path Package

imports: contextlib • io • itertools • pathlib • posixpath • re • stat • sys • zipfile • zipfile._path.glob

imported by: zipfile • zipfile._path.glob

zipfile._path.glob SourceModule

imports: os • re • zipfile._path

imported by: zipfile._path

zipimport SourceModule

imports: _frozen_importlib • _frozen_importlib_external • _imp • _io • _warnings • importlib.readers • marshal • struct • sys • time • zlib

imported by: pkgutil

zlib (builtin module)

imported by: encodings.zlib_codec • gzip • shutil • tarfile • zipfile • zipimport
