18460003808-coder/16_ADC_TEST/ADS7953_20Board_SharedSPI/SCH_Schematic1_2026-09-07.pdf

电源

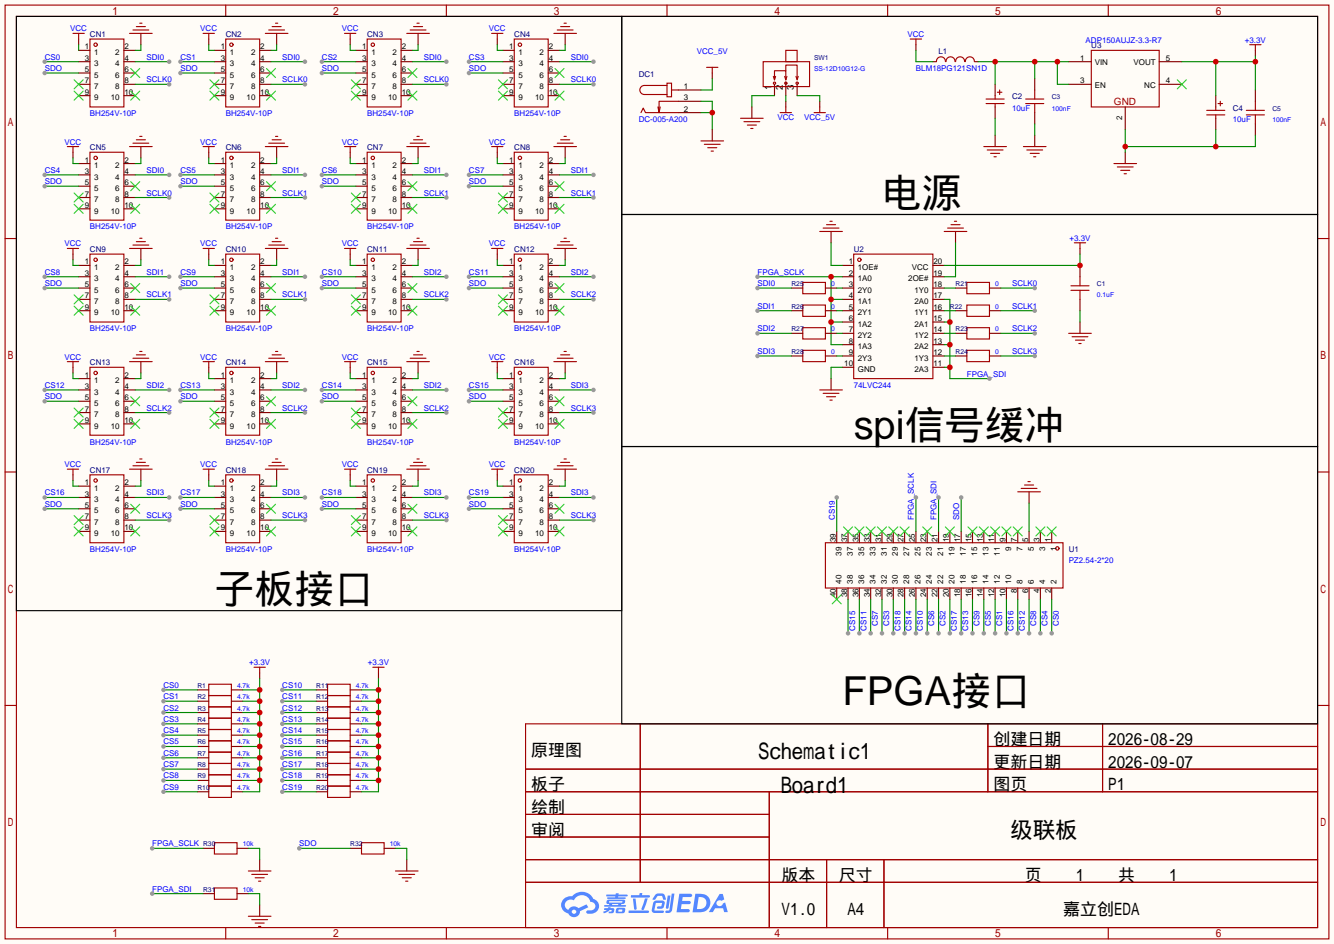
[picture p2: page 1]

原理图 | Schematic1 | 创建日期 | 2026-08-29

更新日期 | 2026-09-07

板子 | Board1 | 图页 | P1
绘制 | | 级联板
审阅

V1.0 | A4 | 嘉立创EDA
