18460003808-coder/16_ADC_TEST/ADS7953_0-5V/电路原理图.pdf

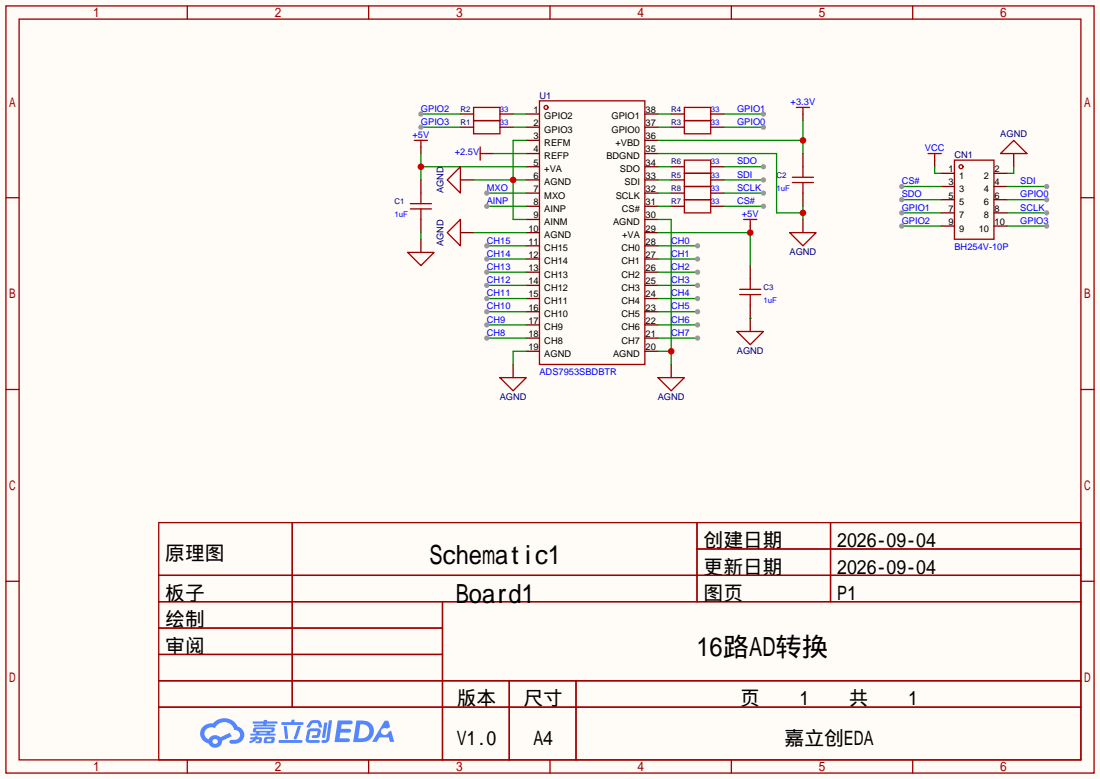
[picture p3: page 1]

原理图 | Schematic1 | 创建日期 | 2026-09-04

更新日期 | 2026-09-04

板子 | Board1 | 图页 | P1
绘制 | | 16路AD转换
审阅

V1.0 | A4 | 嘉立创EDA
