18460003808-coder/16_ADC_TEST/NEW/ADS7953_NBoard_UART_SLIDE/host/ads7953_Nboard_gui.py

"""ADS7953 N-board shared-SPI acquisition tool."""

from __future__ import annotations

import csv
import queue
import sys
import threading
import time
from datetime import datetime
from pathlib import Path
import tkinter as tk
from tkinter import filedialog, messagebox, ttk

import serial
from serial.tools import list_ports
from openpyxl import Workbook, load_workbook
from openpyxl.styles import Font, PatternFill


BAUD = 115200
MAX_BOARD_COUNT = 20
HEADER = b"\xA5\x5A"
VERSION = 1
PAYLOAD_LENGTH = 32
DATA_FRAME_LENGTH = 40
END_FRAME_LENGTH = 8
SLIDE_FRAME_ID = 0xFE
SLIDE_FRAME_LENGTH = 9
SLIDE_DONE = 1
SLIDE_COMMAND_HEADER = b"\x55\xAA"
SLIDE_COMMAND_OPCODE = 0x4D
IV_TO_CHANNEL = (14, 12, 10, 8, 13, 15, 9, 11, 5, 7, 1, 3, 6, 4, 2, 0)
BOARD_MAPPING_FILENAME = "board_mapping.csv"
CHANNEL_MAPPING_FILENAME = "channel_mapping.csv"


def application_directory() -> Path:
    if getattr(sys, "frozen", False):
        return Path(sys.executable).resolve().parent
    return Path(__file__).resolve().parent


def configuration_directory(
        platform_name: str | None = None, home: Path | None = None) -> Path:
    platform_name = platform_name or sys.platform
    if platform_name == "darwin":
        return (home or Path.home()) / "Library" / "Application Support" / \
            "ADS7953_NBoard_UART_SLIDE"
    return application_directory()


def default_export_directory(
        platform_name: str | None = None, home: Path | None = None) -> Path:
    platform_name = platform_name or sys.platform
    if platform_name == "darwin":
        user_home = home or Path.home()
        documents = user_home / "Documents"
        return documents if documents.is_dir() else user_home
    return Path.cwd()


def create_identity_board_mapping(path: Path) -> None:
    """Create the editable first-run mapping used by the macOS app."""
    save_board_mapping(path, tuple(range(MAX_BOARD_COUNT)))


def save_board_mapping(path: Path, physical_to_logical: tuple[int, ...]) -> None:
    if (len(physical_to_logical) != MAX_BOARD_COUNT or
            set(physical_to_logical) != set(range(MAX_BOARD_COUNT))):
        raise ValueError("板卡映射必须是0～19的一一对应排列。")
    path.parent.mkdir(parents=True, exist_ok=True)
    rows = ["capture_slot,logical_board"]
    rows.extend(
        f"{physical + 1},{logical + 1}"
        for physical, logical in enumerate(physical_to_logical))
    path.write_text("\n".join(rows) + "\n", encoding="utf-8")


def load_board_mapping(path: Path) -> tuple[int, ...]:
    """Load physical capture-slot to logical-board mapping as zero-based IDs."""
    if not path.is_file():
        raise ValueError(f"找不到板卡映射文件：{path}")

    physical_to_logical: list[int | None] = [None] * MAX_BOARD_COUNT
    logical_seen: set[int] = set()
    with path.open("r", encoding="utf-8-sig", newline="") as stream:
        reader = csv.DictReader(stream)
        required = {"capture_slot", "logical_board"}
        if not reader.fieldnames or not required.issubset(reader.fieldnames):
            raise ValueError(
                "映射文件表头必须包含capture_slot和logical_board。")
        for row_number, row in enumerate(reader, start=2):
            if not any((value or "").strip() for value in row.values()):
                continue
            try:
                capture_slot = int((row["capture_slot"] or "").strip())
                logical_board = int((row["logical_board"] or "").strip())
            except ValueError as exc:
                raise ValueError(f"映射文件第{row_number}行必须是整数。") from exc
            if not 1 <= capture_slot <= MAX_BOARD_COUNT:
                raise ValueError(f"第{row_number}行capture_slot必须为1～20。")
            if not 1 <= logical_board <= MAX_BOARD_COUNT:
                raise ValueError(f"第{row_number}行logical_board必须为1～20。")
            physical_index = capture_slot - 1
            logical_index = logical_board - 1
            if physical_to_logical[physical_index] is not None:
                raise ValueError(f"采集卡插口{capture_slot}重复配置。")
            if logical_index in logical_seen:
                raise ValueError(f"实际子板{logical_board}重复配置。")
            physical_to_logical[physical_index] = logical_index
            logical_seen.add(logical_index)

    missing_slots = [
        str(index + 1) for index, value in enumerate(physical_to_logical)
        if value is None
    ]
    if missing_slots:
        raise ValueError("映射文件缺少采集卡插口：" + ",".join(missing_slots))
    missing_boards = [
        str(index + 1) for index in range(MAX_BOARD_COUNT)
        if index not in logical_seen
    ]
    if missing_boards:
        raise ValueError("映射文件缺少实际子板：" + ",".join(missing_boards))
    return tuple(value for value in physical_to_logical if value is not None)


def remap_board_group(
        physical_boards: dict[int, tuple[list[int], bool]],
        board_count: int, physical_to_logical: tuple[int, ...]
        ) -> dict[int, tuple[list[int], bool]]:
    """Convert FPGA physical board IDs to configured logical board IDs."""
    return {
        physical_to_logical[physical_board]: physical_boards[physical_board]
        for physical_board in range(board_count)
    }


def create_default_channel_mapping(path: Path) -> None:
    save_channel_mapping(path, IV_TO_CHANNEL)


def save_channel_mapping(path: Path, iv_to_channel: tuple[int, ...]) -> None:
    if (len(iv_to_channel) != 16 or set(iv_to_channel) != set(range(16))):
        raise ValueError("板内接口映射必须是ADC CH0～CH15的一一对应排列。")
    path.parent.mkdir(parents=True, exist_ok=True)
    rows = ["local_iv,adc_channel"]
    rows.extend(
        f"{local_iv},{adc_channel}"
        for local_iv, adc_channel in enumerate(iv_to_channel))
    path.write_text("\n".join(rows) + "\n", encoding="utf-8")


def load_channel_mapping(path: Path) -> tuple[int, ...]:
    if not path.is_file():
        raise ValueError(f"找不到板内接口映射文件：{path}")

    iv_to_channel: list[int | None] = [None] * 16
    channel_seen: set[int] = set()
    with path.open("r", encoding="utf-8-sig", newline="") as stream:
        reader = csv.DictReader(stream)
        required = {"local_iv", "adc_channel"}
        if not reader.fieldnames or not required.issubset(reader.fieldnames):
            raise ValueError(
                "映射文件表头必须包含local_iv和adc_channel。")
        for row_number, row in enumerate(reader, start=2):
            if not any((value or "").strip() for value in row.values()):
                continue
            try:
                local_iv = int((row["local_iv"] or "").strip())
                adc_channel = int((row["adc_channel"] or "").strip())
            except ValueError as exc:
                raise ValueError(f"映射文件第{row_number}行必须是整数。") from exc
            if not 0 <= local_iv < 16:
                raise ValueError(f"第{row_number}行local_iv必须为0～15。")
            if not 0 <= adc_channel < 16:
                raise ValueError(f"第{row_number}行adc_channel必须为0～15。")
            if iv_to_channel[local_iv] is not None:
                raise ValueError(f"板内接口IV{local_iv}重复配置。")
            if adc_channel in channel_seen:
                raise ValueError(f"ADC CH{adc_channel}重复配置。")
            iv_to_channel[local_iv] = adc_channel
            channel_seen.add(adc_channel)

    missing_ivs = [
        str(index) for index, value in enumerate(iv_to_channel)
        if value is None
    ]
    if missing_ivs:
        raise ValueError("映射文件缺少板内接口IV：" + ",".join(missing_ivs))
    missing_channels = [
        str(index) for index in range(16) if index not in channel_seen
    ]
    if missing_channels:
        raise ValueError("映射文件缺少ADC CH：" + ",".join(missing_channels))
    return tuple(value for value in iv_to_channel if value is not None)


def build_slide_command(direction: int, pulse_count: int) -> bytes:
    if direction not in (0, 1):
        raise ValueError("direction must be 0 or 1")
    if not 0 <= pulse_count <= 0xFFFF:
        raise ValueError("pulse_count must be in range 0..65535")
    body = bytes((SLIDE_COMMAND_OPCODE, direction,
                  pulse_count & 0xFF, pulse_count >> 8))
    return SLIDE_COMMAND_HEADER + body + bytes((FrameParser._xor(body),))


class FrameParser:
    def __init__(self) -> None:
        self.buffer = bytearray()

    def feed(self, data: bytes) -> list[tuple[str, int, int, list[int], bool]]:
        self.buffer.extend(data)
        frames: list[tuple[str, int, int, list[int], bool]] = []
        while True:
            start = self.buffer.find(HEADER)
            if start < 0:
                self.buffer[:] = self.buffer[-1:] if self.buffer[-1:] == HEADER[:1] else b""
                break
            if start:
                del self.buffer[:start]
            if len(self.buffer) < 5:
                break

            is_end = self.buffer[3] == 0xFF
            is_slide = self.buffer[3] == SLIDE_FRAME_ID
            if is_end:
                frame_length = END_FRAME_LENGTH
            elif is_slide:
                frame_length = SLIDE_FRAME_LENGTH
            else:
                frame_length = DATA_FRAME_LENGTH
            if len(self.buffer) < frame_length:
                break
            frame = bytes(self.buffer[:frame_length])

            if is_slide:
                if (frame[2] != VERSION or frame[4] != SLIDE_DONE or
                        frame[5] not in (0, 1) or
                        self._xor(frame[2:8]) != frame[8]):
                    del self.buffer[0]
                    continue
                pulse_count = frame[6] | (frame[7] << 8)
                frames.append(("slide", frame[4], frame[5], [pulse_count], False))
                del self.buffer[:frame_length]
                continue

            if is_end:
                if (frame[2] != VERSION or not 1 <= frame[4] <= MAX_BOARD_COUNT or
                        self._xor(frame[2:7]) != frame[7]):
                    del self.buffer[0]
                    continue
                sequence = frame[5] | (frame[6] << 8)
                frames.append(("end", sequence, frame[4], [], False))
                del self.buffer[:frame_length]
                continue

            if (frame[2] != VERSION or frame[4] != PAYLOAD_LENGTH or
                    frame[3] >= MAX_BOARD_COUNT or self._xor(frame[2:39]) != frame[39]):
                del self.buffer[0]
                continue

            board_id = frame[3]
            sequence = frame[5] | (frame[6] << 8)
            codes = [
                frame[7 + 2 * channel] | ((frame[8 + 2 * channel] & 0x0F) << 8)
                for channel in range(16)
            ]
            spi_error = bool(frame[8] & 0x80)
            frames.append(("data", sequence, board_id, codes, spi_error))
            del self.buffer[:frame_length]
        return frames

    @staticmethod
    def _xor(data: bytes) -> int:
        result = 0
        for value in data:
            result ^= value
        return result


class Ads7953App:
    def __init__(self, root: tk.Tk) -> None:
        self.root = root
        self.root.title("ADS7953 N板自动识别采集工具")
        self.root.geometry("900x710")
        self.serial_port: serial.Serial | None = None
        self.stop_event = threading.Event()
        self.continuous_stop_event = threading.Event()
        self.continuous_active = False
        self.events: queue.Queue[tuple[str, object]] = queue.Queue()
        self.pending: dict[int, dict[int, tuple[list[int], bool]]] = {}
        self.current_codes = {board: [0] * 16 for board in range(MAX_BOARD_COUNT)}
        self.current_errors = {board: False for board in range(MAX_BOARD_COUNT)}
        self.active_logical_boards: set[int] = set()
        self.current_sequence: int | None = None
        self.detected_board_count = 0
        config_dir = configuration_directory()
        self.mapping_path = config_dir / BOARD_MAPPING_FILENAME
        self.channel_mapping_path = config_dir / CHANNEL_MAPPING_FILENAME
        mapping_errors = []
        try:
            if sys.platform == "darwin" and not self.mapping_path.exists():
                create_identity_board_mapping(self.mapping_path)
            self.physical_to_logical = load_board_mapping(self.mapping_path)
        except (OSError, UnicodeError, ValueError) as exc:
            self.physical_to_logical = tuple(range(MAX_BOARD_COUNT))
            mapping_errors.append(f"板卡序号：{exc}")
        try:
            if sys.platform == "darwin" and not self.channel_mapping_path.exists():
                create_default_channel_mapping(self.channel_mapping_path)
            self.iv_to_channel = load_channel_mapping(self.channel_mapping_path)
        except (OSError, UnicodeError, ValueError) as exc:
            self.iv_to_channel = IV_TO_CHANNEL
            mapping_errors.append(f"板内接口：{exc}")
        self.mapping_error = "\n".join(mapping_errors) or None
        self.export_path = default_export_directory() / "ADS7953_NBoard_data.xlsx"
        self._build_ui()
        if self.mapping_error:
            self.status.set(f"映射配置错误：{self.mapping_error}")
            self.root.after(0, lambda: messagebox.showerror(
                "映射配置错误",
                self.mapping_error +
                "\n\n请点击上位机中的“映射配置”进行修正。"))
        else:
            self.status.set("未连接；板卡序号和板内接口映射已加载")
        self._refresh_ports()
        self.root.after(50, self._poll_events)
        self.root.protocol("WM_DELETE_WINDOW", self._close)

    def _build_ui(self) -> None:
        controls = ttk.Frame(self.root, padding=8)
        controls.pack(fill=tk.X)
        ttk.Label(controls, text="串口：").pack(side=tk.LEFT)
        self.port_box = ttk.Combobox(controls, width=16, state="readonly")
        self.port_box.pack(side=tk.LEFT, padx=(0, 5))
        ttk.Button(controls, text="刷新", command=self._refresh_ports).pack(side=tk.LEFT)
        self.connect_button = ttk.Button(controls, text="连接", command=self._toggle_connection)
        self.connect_button.pack(side=tk.LEFT, padx=5)
        self.trigger_button = ttk.Button(
            controls, text="采集", state=tk.DISABLED, command=self._trigger)
        self.trigger_button.pack(side=tk.LEFT, padx=5)
        ttk.Button(controls, text="选择Excel", command=self._select_export).pack(side=tk.LEFT, padx=5)
        ttk.Button(
            controls, text="映射配置",
            command=self._open_mapping_editor).pack(side=tk.LEFT, padx=5)

        repeat_controls = ttk.Frame(self.root, padding=(8, 0, 8, 6))
        repeat_controls.pack(fill=tk.X)
        ttk.Label(repeat_controls, text="连续触发间隔(ms)：").pack(side=tk.LEFT)
        self.interval_var = tk.StringVar(value="500")
        ttk.Entry(repeat_controls, textvariable=self.interval_var, width=8).pack(
            side=tk.LEFT, padx=(0, 8))
        ttk.Label(repeat_controls, text="采集时间(s，0=不限)：").pack(side=tk.LEFT)
        self.duration_var = tk.StringVar(value="10")
        ttk.Entry(repeat_controls, textvariable=self.duration_var, width=8).pack(
            side=tk.LEFT, padx=(0, 8))
        self.continuous_button = ttk.Button(
            repeat_controls, text="开始连续采集", state=tk.DISABLED,
            command=self._toggle_continuous)
        self.continuous_button.pack(side=tk.LEFT, padx=5)
        self.continuous_excel_var = tk.BooleanVar(value=False)
        ttk.Checkbutton(
            repeat_controls, text="连续采集时写Excel",
            variable=self.continuous_excel_var).pack(side=tk.LEFT, padx=8)

        board_bar = ttk.Frame(self.root, padding=(8, 0, 8, 6))
        board_bar.pack(fill=tk.X)
        ttk.Label(board_bar, text="查看板号：").pack(side=tk.LEFT)
        self.board_box = ttk.Combobox(
            board_bar, width=8, state="readonly",
            values=["0"])
        self.board_box.current(0)
        self.board_box.pack(side=tk.LEFT)
        self.board_box.bind("<<ComboboxSelected>>", lambda _event: self._refresh_table())
        self.sequence_text = tk.StringVar(value="采集序号：--")
        ttk.Label(board_bar, textvariable=self.sequence_text).pack(side=tk.LEFT, padx=20)

        self.status = tk.StringVar(value="未连接")
        ttk.Label(self.root, textvariable=self.status, padding=(8, 0, 8, 6)).pack(fill=tk.X)

        columns = ("iv", "channel", "code", "mv", "voltage")
        self.table = ttk.Treeview(self.root, columns=columns, show="headings", height=16)
        headings = ("接口", "ADC通道", "原始码", "毫伏", "电压(V)")
        widths = (100, 120, 120, 150, 150)
        for column, heading, width in zip(columns, headings, widths):
            self.table.heading(column, text=heading)
            self.table.column(column, width=width, anchor=tk.CENTER)
        self.table.pack(fill=tk.BOTH, expand=True, padx=8, pady=(0, 8))
        for iv, channel in enumerate(self.iv_to_channel):
            self.table.insert("", tk.END, iid=str(iv),
                              values=(f"IV{iv}", channel, 0, "0.00", "0.0000"))
        self.table.tag_configure(
            "spi_error", foreground="#C00000", background="#FFE6E6")

    def _open_mapping_editor(self) -> None:
        if self.serial_port and self.serial_port.is_open:
            messagebox.showwarning("映射配置", "请先断开串口，再修改映射配置。")
            return
        if getattr(self, "link_captures", []):
            messagebox.showwarning(
                "映射配置", "请先保存当前待保存的联动数据，再修改映射配置。")
            return

        window = tk.Toplevel(self.root)
        window.title("板卡序号与板内接口映射配置")
        window.transient(self.root)
        window.resizable(False, False)

        content = ttk.Frame(window, padding=10)
        content.pack(fill=tk.BOTH, expand=True)
        board_frame = ttk.LabelFrame(
            content, text="采集卡物理插口 → 实际逻辑子板", padding=8)
        board_frame.grid(row=0, column=0, sticky=tk.N, padx=(0, 8))
        channel_frame = ttk.LabelFrame(
            content, text="板内接口 → ADC通道（所有子板共用）", padding=8)
        channel_frame.grid(row=0, column=1, sticky=tk.N)

        board_values = tuple(str(value) for value in range(1, 21))
        board_vars = []
        for physical, logical in enumerate(self.physical_to_logical, start=1):
            ttk.Label(board_frame, text=f"插口 {physical}", width=9).grid(
                row=physical - 1, column=0, padx=(0, 4), pady=1)
            value = tk.StringVar(value=str(logical + 1))
            board_vars.append(value)
            ttk.Combobox(
                board_frame, textvariable=value, values=board_values,
                state="readonly", width=7).grid(
                    row=physical - 1, column=1, pady=1)

        channel_values = tuple(f"CH{value}" for value in range(16))
        channel_vars = []
        for local_iv, adc_channel in enumerate(self.iv_to_channel):
            ttk.Label(channel_frame, text=f"IV{local_iv}", width=7).grid(
                row=local_iv, column=0, padx=(0, 4), pady=1)
            value = tk.StringVar(value=f"CH{adc_channel}")
            channel_vars.append(value)
            ttk.Combobox(
                channel_frame, textvariable=value, values=channel_values,
                state="readonly", width=7).grid(
                    row=local_iv, column=1, pady=1)

        ttk.Label(
            content,
            text="保存时会检查两组映射均为一一对应；保存成功后立即生效。",
            foreground="#555555").grid(
                row=1, column=0, columnspan=2, pady=(10, 4))
        buttons = ttk.Frame(content)
        buttons.grid(row=2, column=0, columnspan=2, pady=(4, 0))
        ttk.Button(
            buttons, text="保存并应用",
            command=lambda: self._save_mapping_editor(
                window, board_vars, channel_vars)).pack(side=tk.LEFT, padx=5)
        ttk.Button(buttons, text="取消", command=window.destroy).pack(
            side=tk.LEFT, padx=5)
        window.grab_set()

    def _save_mapping_editor(
            self, window: tk.Toplevel, board_vars: list[tk.StringVar],
            channel_vars: list[tk.StringVar]) -> None:
        try:
            physical_to_logical = tuple(
                int(value.get()) - 1 for value in board_vars)
            iv_to_channel = tuple(
                int(value.get().removeprefix("CH")) for value in channel_vars)
            if set(physical_to_logical) != set(range(MAX_BOARD_COUNT)):
                raise ValueError("20个逻辑子板编号必须各使用一次，不能重复或缺失。")
            if set(iv_to_channel) != set(range(16)):
                raise ValueError("ADC CH0～CH15必须各使用一次，不能重复或缺失。")
            save_board_mapping(self.mapping_path, physical_to_logical)
            save_channel_mapping(self.channel_mapping_path, iv_to_channel)
        except (OSError, ValueError) as exc:
            messagebox.showerror("保存失败", str(exc), parent=window)
            return

        self.physical_to_logical = physical_to_logical
        self.iv_to_channel = iv_to_channel
        self.mapping_error = None
        self._reset_mapping_state()
        window.destroy()
        self.status.set("映射配置已保存并立即生效")
        messagebox.showinfo(
            "映射配置", "板卡序号和板内接口映射已保存并立即生效。",
            parent=self.root)

    def _reset_mapping_state(self) -> None:
        self.pending.clear()
        self.current_sequence = None
        self.detected_board_count = 0
        self.active_logical_boards.clear()
        for board in range(MAX_BOARD_COUNT):
            self.current_codes[board] = [0] * 16
            self.current_errors[board] = False
        if hasattr(self, "sequence_text"):
            self.sequence_text.set("采集序号：--")
        if hasattr(self, "board_box"):
            self.board_box["values"] = ["0"]
            self.board_box.set("0")
        if hasattr(self, "table"):
            self._refresh_table()

    def _refresh_ports(self) -> None:
        ports = [port.device for port in list_ports.comports()]
        self.port_box["values"] = ports
        if ports and self.port_box.get() not in ports:
            self.port_box.current(0)

    def _toggle_connection(self) -> None:
        if self.serial_port and self.serial_port.is_open:
            self._disconnect()
            return
        if self.mapping_error:
            messagebox.showerror(
                "映射配置错误",
                self.mapping_error +
                "\n\n请点击上位机中的“映射配置”进行修正。")
            return
        port = self.port_box.get()
        if not port:
            messagebox.showwarning("提示", "没有可用串口，请连接设备后刷新。")
            return
        try:
            self.serial_port = serial.Serial(port, BAUD, timeout=0.1)
        except serial.SerialException as exc:
            messagebox.showerror("连接失败", str(exc))
            return
        self.stop_event.clear()
        threading.Thread(target=self._reader, daemon=True).start()
        self.connect_button.configure(text="断开")
        self.trigger_button.configure(state=tk.NORMAL)
        self.continuous_button.configure(state=tk.NORMAL)
        self.status.set(f"已连接 {port} @ {BAUD} baud")

    def _disconnect(self) -> None:
        self._stop_continuous(update_status=False)
        self.stop_event.set()
        port = self.serial_port
        self.serial_port = None
        if port:
            try:
                port.close()
            except serial.SerialException:
                pass
        self.connect_button.configure(text="连接")
        self.trigger_button.configure(state=tk.DISABLED)
        self.continuous_button.configure(state=tk.DISABLED)
        self.status.set("未连接；板卡序号和板内接口映射已加载")

    def _reader(self) -> None:
        parser = FrameParser()
        port = self.serial_port
        try:
            while port and port.is_open and not self.stop_event.is_set():
                data = port.read(port.in_waiting or 1)
                for frame in parser.feed(data):
                    self.events.put(("frame", frame))
        except serial.SerialException as exc:
            self.events.put(("error", str(exc)))

    def _trigger(self) -> None:
        if not self.serial_port or not self.serial_port.is_open:
            return
        try:
            self.serial_port.reset_input_buffer()
            self.pending.clear()
            self.serial_port.write(b"T")
            self.trigger_button.configure(state=tk.DISABLED)
            self.status.set("正在采集，等待FPGA报告实际板卡数量……")
            self.root.after(6000, self._trigger_timeout)
        except serial.SerialException as exc:
            self._serial_error(str(exc))

    def _toggle_continuous(self) -> None:
        if self.continuous_active:
            self._stop_continuous()
            return
        if not self.serial_port or not self.serial_port.is_open:
            return
        try:
            interval_ms = int(self.interval_var.get())
            duration_s = float(self.duration_var.get())
        except ValueError:
            messagebox.showwarning("参数错误", "触发间隔和采集时间必须是数字。")
            return
        if not 20 <= interval_ms <= 60000:
            messagebox.showwarning("参数错误", "触发间隔范围为20～60000 ms。")
            return
        if not 0 <= duration_s <= 86400:
            messagebox.showwarning("参数错误", "采集时间范围为0～86400秒，0表示不限时。")
            return

        try:
            self.serial_port.reset_input_buffer()
        except serial.SerialException as exc:
            self._serial_error(str(exc))
            return
        self.pending.clear()
        self.continuous_stop_event.clear()
        self.continuous_active = True
        self.trigger_button.configure(state=tk.DISABLED)
        self.continuous_button.configure(text="停止连续采集")
        duration_text = "不限时" if duration_s == 0 else f"持续 {duration_s:g} 秒"
        self.status.set(
            f"连续采集中：自动识别板数，每 {interval_ms} ms触发，{duration_text}")
        threading.Thread(
            target=self._continuous_writer,
            args=(interval_ms, duration_s), daemon=True).start()

    def _continuous_writer(self, interval_ms: int, duration_s: float) -> None:
        port = self.serial_port
        deadline = time.monotonic() + duration_s if duration_s > 0 else None
        try:
            while port and port.is_open and not self.continuous_stop_event.is_set():
                port.write(b"T")
                wait_seconds = interval_ms / 1000.0
                if deadline is not None:
                    remaining = deadline - time.monotonic()
                    if remaining <= 0:
                        break
                    wait_seconds = min(wait_seconds, remaining)
                if self.continuous_stop_event.wait(wait_seconds):
                    return
            if not self.continuous_stop_event.is_set():
                self.events.put(("continuous_done", None))
        except serial.SerialException as exc:
            self.events.put(("error", str(exc)))

    def _stop_continuous(self, update_status: bool = True) -> None:
        self.continuous_stop_event.set()
        self.continuous_active = False
        if hasattr(self, "continuous_button"):
            self.continuous_button.configure(text="开始连续采集")
        if self.serial_port and self.serial_port.is_open:
            self.trigger_button.configure(state=tk.NORMAL)
            if update_status:
                self.status.set("连续采集已停止")

    def _trigger_timeout(self) -> None:
        if (not self.continuous_active and
                str(self.trigger_button["state"]) == tk.DISABLED and self.serial_port):
            self.trigger_button.configure(state=tk.NORMAL)
            self.status.set("采集超时：请检查缺失板卡的CS、共用SPI和串口连接")

    def _poll_events(self) -> None:
        try:
            while True:
                kind, payload = self.events.get_nowait()
                if kind == "frame":
                    frame_kind, sequence, value, codes, spi_error = payload  # type: ignore[misc]
                    if frame_kind == "data":
                        boards = self.pending.setdefault(sequence, {})
                        boards[value] = (codes, spi_error)
                        self.status.set(f"序号 {sequence}：已收到 {len(boards)} 块板")
                    elif frame_kind == "end":
                        board_count = value
                        boards = self.pending.get(sequence, {})
                        missing = [
                            board for board in range(board_count)
                            if board not in boards
                        ]
                        if missing:
                            self.status.set(
                                f"序号 {sequence}不完整，缺少板号："
                                + ",".join(str(board) for board in missing))
                            if not self.continuous_active:
                                self.trigger_button.configure(state=tk.NORMAL)
                            continue
                        logical_boards = remap_board_group(
                            boards, board_count, self.physical_to_logical)
                        self._complete_capture(
                            sequence, logical_boards, board_count)
                        self.pending = {
                            seq: values for seq, values in self.pending.items()
                            if seq > sequence
                        }
                    else:
                        self._handle_aux_frame(payload)  # type: ignore[arg-type]
                elif kind == "continuous_done":
                    self._stop_continuous()
                    self.status.set("已达到设定采集时间，连续采集已停止")
                else:
                    self._serial_error(str(payload))
        except queue.Empty:
            pass
        self.root.after(50, self._poll_events)

    def _handle_aux_frame(
            self, frame: tuple[str, int, int, list[int], bool]) -> None:
        """Hook for project variants with extra FPGA response frames."""

    def _complete_capture(
            self, sequence: int, boards: dict[int, tuple[list[int], bool]],
            board_count: int) -> None:
        self._store_logical_boards(boards, board_count)
        logical_board_ids = sorted(boards)
        self.board_box["values"] = [str(board) for board in logical_board_ids]
        if int(self.board_box.get() or 0) not in boards:
            self.board_box.set(str(logical_board_ids[0]))
        self.current_sequence = sequence
        self.sequence_text.set(f"采集序号：{sequence}")
        self._refresh_table()
        wrote_excel = not self.continuous_active or self.continuous_excel_var.get()
        if wrote_excel:
            self._append_excel(sequence, boards, board_count)
        if not self.continuous_active:
            self.trigger_button.configure(state=tk.NORMAL)
        suffix = f"，已写入 {self.export_path}" if wrote_excel else ""
        failed = [str(board) for board in sorted(boards) if self.current_errors[board]]
        if failed:
            self.status.set(
                f"序号 {sequence}：板号 {','.join(failed)} SPI读取异常（32字超时）{suffix}")
        else:
            mode = "连续采集" if self.continuous_active else "单次采集"
            self.status.set(
                f"序号 {sequence}：{mode}完成{board_count}板"
                f"共{board_count * 16}路，全部正常{suffix}")

    def _refresh_table(self) -> None:
        board = int(self.board_box.get() or 0)
        codes = self.current_codes[board]
        row_tags = ("spi_error",) if self.current_errors[board] else ()
        for iv, channel in enumerate(self.iv_to_channel):
            code = codes[channel]
            millivolts = code * 5000.0 / 4096.0
            self.table.item(
                str(iv), values=(f"IV{iv}", channel, code,
                                 f"{millivolts:.2f}", f"{millivolts / 1000.0:.4f}"),
                tags=row_tags)

    def _store_logical_boards(
            self, boards: dict[int, tuple[list[int], bool]],
            board_count: int) -> None:
        self.detected_board_count = board_count
        self.active_logical_boards = set(boards)
        for board in range(MAX_BOARD_COUNT):
            self.current_codes[board] = [0] * 16
            self.current_errors[board] = False
        for board, (codes, spi_error) in boards.items():
            self.current_codes[board] = codes
            self.current_errors[board] = spi_error

    def _select_export(self) -> None:
        selected = filedialog.asksaveasfilename(
            title="选择数据文件", defaultextension=".xlsx",
            filetypes=[("Excel 工作簿", "*.xlsx")], initialfile=self.export_path.name)
        if selected:
            self.export_path = Path(selected)
            self.status.set(f"Excel输出：{self.export_path}")

    def _append_excel(
            self, sequence: int, boards: dict[int, tuple[list[int], bool]],
            board_count: int) -> None:
        if self.export_path.exists():
            workbook = load_workbook(self.export_path)
            sheet = workbook.active
        else:
            workbook = Workbook()
            sheet = workbook.active
            sheet.title = "采集数据"
            sheet.append(
                ["时间", "序号", "板号", "读取状态"]
                + [f"IV{i}(mV)" for i in range(16)])
        if sheet.cell(1, 4).value != "读取状态":
            sheet.insert_cols(4)
            sheet.cell(1, 4, "读取状态")
        timestamp = datetime.now().strftime("%Y-%m-%d %H:%M:%S.%f")[:-3]
        error_fill = PatternFill(fill_type="solid", fgColor="FFE6E6")
        error_font = Font(color="C00000")
        for board in sorted(boards):
            codes, spi_error = boards[board]
            values = [
                codes[channel] * 5000.0 / 4096.0
                for channel in self.iv_to_channel
            ]
            sheet.append([
                timestamp, sequence, board,
                "读取异常（32字超时）" if spi_error else "正常",
            ] + values)
            if spi_error:
                for cell in sheet[sheet.max_row]:
                    cell.fill = error_fill
                    cell.font = error_font
        workbook.save(self.export_path)

    def _serial_error(self, detail: str) -> None:
        self._disconnect()
        messagebox.showerror("串口错误", detail)

    def _close(self) -> None:
        self._disconnect()
        self.root.destroy()


def main() -> None:
    root = tk.Tk()
    Ads7953App(root)
    root.mainloop()


if __name__ == "__main__":
    main()
