18460003808-coder/16_ADC_TEST/NEW/ADS7953_NBoard_UART_SLIDE/host/test_views.py

import unittest
from pathlib import Path
from tempfile import TemporaryDirectory

from openpyxl import Workbook, load_workbook

from ads7953_all_channels_gui import AllChannelsApp
from ads7953_all_channels_gui import all_channel_rows
from ads7953_all_channels_gui import grayscale_pixels_from_excel
from ads7953_scope_gui import ScopeApp
from ads7953_Nboard_gui import remap_board_group


class AllChannelMappingTests(unittest.TestCase):
    def test_grayscale_320_by_n_linear_mapping(self):
        with TemporaryDirectory() as temporary_directory:
            path = Path(temporary_directory) / "gray.xlsx"
            workbook = Workbook()
            sheet = workbook.active
            sheet.title = "纵向通道数据"
            sheet.cell(1, 1, "接口")
            sheet.cell(1, 2, "采集1")
            sheet.cell(1, 3, "采集2")
            for global_iv in range(320):
                sheet.cell(global_iv + 2, 1, f"IV{global_iv}")
            sheet.cell(2, 2, 0.0)
            sheet.cell(2, 3, 5000.0)
            sheet.cell(3, 2, 2500.0)
            sheet.cell(3, 3, 6000.0)
            workbook.save(path)

            width, height, pixels = grayscale_pixels_from_excel(path, 0.0, 5.0)
            self.assertEqual((2, 320), (width, height))
            self.assertEqual((0, 255), (pixels[0], pixels[1]))
            self.assertEqual((128, 255), (pixels[2], pixels[3]))
            self.assertEqual(0, pixels[4])

    def test_grayscale_rejects_invalid_voltage_scale(self):
        with TemporaryDirectory() as temporary_directory:
            path = Path(temporary_directory) / "unused.xlsx"
            with self.assertRaises(ValueError):
                grayscale_pixels_from_excel(path, 5.0, 5.0)

    def test_slide_distance_to_pulses(self):
        self.assertEqual((0.5, 40), AllChannelsApp._distance_to_pulses("0.5"))
        self.assertEqual((2.0, 160), AllChannelsApp._distance_to_pulses("2"))
        with self.assertRaises(ValueError):
            AllChannelsApp._distance_to_pulses("2.1")
        self.assertEqual(
            (300.0, 24000),
            AllChannelsApp._distance_to_pulses("300", maximum_mm=300.0))
        with self.assertRaises(ValueError):
            AllChannelsApp._distance_to_pulses("300.1", maximum_mm=300.0)

    def test_global_iv_mapping_across_boards(self):
        boards = {
            0: list(range(16)),
            1: [100 + value for value in range(16)],
        }
        rows = list(all_channel_rows(boards, 2))
        self.assertEqual(32, len(rows))
        self.assertEqual((0, 0, 0, 14, 14), rows[0][:5])
        self.assertEqual((15, 0, 15, 0, 0), rows[15][:5])
        self.assertEqual((16, 1, 0, 14, 114), rows[16][:5])
        self.assertEqual((31, 1, 15, 0, 100), rows[31][:5])

    def test_custom_channel_mapping_changes_display_rows(self):
        boards = {0: list(range(16))}
        rows = list(all_channel_rows(boards, 1, tuple(range(16))))
        self.assertEqual((0, 0, 0, 0, 0), rows[0][:5])
        self.assertEqual((15, 0, 15, 15, 15), rows[15][:5])

    def test_all_channels_excel_uses_iv_rows_and_time_columns(self):
        boards = {
            0: (list(range(16)), False),
            1: ([100 + value for value in range(16)], False),
        }
        with TemporaryDirectory() as temporary_directory:
            path = Path(temporary_directory) / "all.xlsx"
            app = AllChannelsApp.__new__(AllChannelsApp)
            app.export_path = path
            app.iv_to_channel = tuple(range(16))
            app._append_excel(7, boards, 2)
            sheet = load_workbook(path, data_only=True).active
            self.assertEqual("接口", sheet.cell(1, 1).value)
            self.assertEqual("IV0", sheet.cell(2, 1).value)
            self.assertEqual("IV319", sheet.cell(321, 1).value)
            self.assertIn("Seq 7", sheet.cell(1, 2).value)
            self.assertAlmostEqual(0.0, sheet.cell(2, 2).value)
            self.assertIsNone(sheet.cell(34, 2).value)
            self.assertEqual(2, sheet.max_column)
            self.assertEqual(321, sheet.max_row)

            app._append_excel(8, boards, 2, position_mm=1.5)
            sheet = load_workbook(path, data_only=True).active
            self.assertIn("Seq 8", sheet.cell(1, 3).value)
            self.assertIn("Pos 1.5 mm", sheet.cell(1, 3).value)
            self.assertEqual(3, sheet.max_column)

    def test_all_channels_excel_highlights_failed_board(self):
        boards = {
            0: (list(range(16)), False),
            1: ([0] * 16, True),
        }
        with TemporaryDirectory() as temporary_directory:
            path = Path(temporary_directory) / "all_error.xlsx"
            app = AllChannelsApp.__new__(AllChannelsApp)
            app.export_path = path
            app._append_excel(8, boards, 2)
            sheet = load_workbook(path, data_only=True).active
            self.assertEqual("IV16", sheet.cell(18, 1).value)
            self.assertEqual("00C00000", sheet.cell(18, 2).font.color.rgb)
            self.assertIsNone(sheet.cell(34, 2).value)

    def test_all_channels_excel_uses_configured_logical_order(self):
        physical_boards = {
            0: (list(range(16)), False),
            1: ([100 + value for value in range(16)], True),
        }
        mapping = (1, 0) + tuple(range(2, 20))
        boards = remap_board_group(physical_boards, 2, mapping)
        with TemporaryDirectory() as temporary_directory:
            path = Path(temporary_directory) / "mapped.xlsx"
            app = AllChannelsApp.__new__(AllChannelsApp)
            app.export_path = path
            app._append_excel(9, boards, 2)
            sheet = load_workbook(path, data_only=True).active
            self.assertAlmostEqual(
                114 * 5000.0 / 4096.0, sheet.cell(2, 2).value)
            self.assertEqual("00C00000", sheet.cell(2, 2).font.color.rgb)
            self.assertAlmostEqual(
                14 * 5000.0 / 4096.0, sheet.cell(18, 2).value)

    def test_linked_run_creates_new_named_workbook(self):
        boards = {
            0: (list(range(16)), False),
            1: ([100 + value for value in range(16)], True),
        }
        with TemporaryDirectory() as temporary_directory:
            path = Path(temporary_directory) / "named_run.xlsx"
            old = Workbook()
            old.active.title = "旧数据"
            old.save(path)

            app = AllChannelsApp.__new__(AllChannelsApp)
            app.link_captures = [
                ("2026-10-08 12:00:00.123", 7, boards, 2, 0.0),
                ("2026-10-08 12:00:00.623", 8, boards, 2, 1.0),
            ]
            app._write_linked_excel(path)

            workbook = load_workbook(path, data_only=True)
            self.assertEqual(["纵向通道数据"], workbook.sheetnames)
            sheet = workbook.active
            self.assertEqual("IV0", sheet.cell(2, 1).value)
            self.assertIn("2026-10-08 12:00:00.123", sheet.cell(1, 2).value)
            self.assertIn("Pos 1 mm", sheet.cell(1, 3).value)
            self.assertEqual("00C00000", sheet.cell(18, 2).font.color.rgb)
            self.assertEqual(3, sheet.max_column)

    def test_all_channels_preserves_legacy_sheet(self):
        boards = {0: (list(range(16)), False)}
        with TemporaryDirectory() as temporary_directory:
            path = Path(temporary_directory) / "legacy.xlsx"
            workbook = Workbook()
            workbook.active.title = "全通道采集数据"
            workbook.active["A1"] = "旧格式"
            workbook.save(path)
            app = AllChannelsApp.__new__(AllChannelsApp)
            app.export_path = path
            app._append_excel(9, boards, 1)
            workbook = load_workbook(path, data_only=True)
            self.assertIn("全通道采集数据", workbook.sheetnames)
            self.assertIn("纵向通道数据", workbook.sheetnames)
            self.assertEqual("纵向通道数据", workbook.active.title)

    def test_scope_excel_exports_only_selected_global_channels(self):
        physical_boards = {
            0: (list(range(16)), False),
            1: ([100 + value for value in range(16)], True),
        }
        mapping = (1, 0) + tuple(range(2, 20))
        boards = remap_board_group(physical_boards, 2, mapping)
        with TemporaryDirectory() as temporary_directory:
            path = Path(temporary_directory) / "scope.xlsx"
            app = ScopeApp.__new__(ScopeApp)
            app.export_path = path
            app.iv_to_channel = tuple(range(16))
            app._selected_channels = lambda: [0, 16]
            app._append_excel(8, boards, 2)
            sheet = load_workbook(path, data_only=True).active
            self.assertEqual("IV0", sheet.cell(2, 3).value)
            self.assertEqual("IV16", sheet.cell(3, 3).value)
            self.assertEqual("读取状态", sheet.cell(1, 7).value)
            self.assertEqual("读取异常（32字超时）", sheet.cell(2, 7).value)
            self.assertEqual(100, sheet.cell(2, 8).value)
            self.assertEqual(0, sheet.cell(3, 8).value)
            self.assertEqual(3, sheet.max_row)


if __name__ == "__main__":
    unittest.main()
