18460003808-coder/16_ADC_TEST/(commit log)

2026-10-27 Add macOS packaging and board mapping support
    [ADS7953_AllChannels_data.xlsx, ADS7953_SLIDE_20261021_142926.xlsx, ADS7953_SLIDE_20261021_143152.xlsx, board_mapping.csv]
2026-11-03 Add editable board and channel mappings
    [channel_mapping.csv]
